antoniofloresgil/cvw/README.md

# core-v-wally

This repository is a fork of [openhwgroup/cvw](https://github.com/openhwgroup/cvw) (CORE-V-Wally) that is
more than Wally: next to the processor it holds an [open FPGA flow, an open ASIC flow with a
microcontroller chip, a KiCad test board and FreeRTOS](#what-this-fork-adds). The core and its configurations
are Wally's, upstream is merged into `main` regularly, and every addition to the core is behind a configuration
parameter that is off by default, so the upstream configurations behave as before
([the inventory](docs/engineering/upstream-coupling.md)). The rest of this README is upstream's setup guide
and still applies.

Wally is a 5-stage pipelined processor configurable to support up through the RVA22 profile, including virtual memory, PMP, and the various privileged modes and CSRs. The rv64gc configuration supports:

- RV64IMAFDCB with M, S, and U modes
- Zicsr, Zifencei, Zicntr, Zihpm, Zicond, and Zicclsm
- Zbc
- Zkn scalar crypto (Zbkb, Zbkc, Zbkx, Zknd, Zkne, and Zknh)
- Zcb
- Zfh and Zfa
- Zicbom, Zicboz, and Zicbop
- Sstc
- Sv39, Sv48, and Sv57 virtual memory with Svpbmt, Svnapot, Svinval, and Svadu
- 16 PMP entries

Other configurations range down to a minimal RV32E core, and derivative configurations add the Q extension. Wally provides optional caches, branch prediction, and standard RISC-V peripherals (CLINT, PLIC, UART, GPIO).   Wally is written in SystemVerilog.  It passes the [RISC-V Arch Tests](https://github.com/riscv/riscv-arch-test) and boots Linux on an FPGA.  Wally is part of the OpenHW Foundation family of robust open RISC-V cores.

Wally block diagram

Wally is described in a textbook, [*RISC-V System-on-Chip Design*](https://pages.hmc.edu/harris/ddca/rvsocd.html), by Harris, Stine, Thompson, and Harris.  Users should follow the setup instructions below.

# What this fork adds

| | What it is | Where |
|---|---|---|
| **Open FPGA flow** | Wally on Xilinx 7-series boards with no Vivado: Yosys, nextpnr-xilinx (openXC7) and Project X-Ray, with LiteX/LiteDRAM for the DDR3 instead of Vivado's MIG. On the Nexys Video the RV32 design runs at 40 MHz and RV64GC boots Linux to a BusyBox shell at 12.5 MHz. The Vivado flow stays. The chip below also builds for the Nexys Video (`make nexysvideochip`). | `fpga/`, [flow and LiteDRAM](docs/fpga-opensource-litedram.md), [DDR3 bring-up](docs/engineering/experiments/open-ddr3-bringup.md), [the chip on the FPGA](docs/fpga-chip.md) |
| **Open ASIC flow** | Wally from RTL to GDS with LibreLane on the IHP SG13G2 and SG13CMOS5L open PDKs, with KLayout and Magic DRC, LVS and timing signoff, all open tools. It builds a chip: **`asic_soc_rv32imac`**, an RV32IMAC RISC-V microcontroller with 16 PMP entries, the JTAG debug port and instruction trace, 64 KiB of SRAM in eight macros, an SPI-flash/UART bootloader, a timer with PWM and capture, a watchdog, I2C, an RTC and a pad ring for a QFN 32. It has not been fabricated. | `asic/librelane/`, [README](asic/librelane/README.md), [ADR 0022](docs/engineering/decisions/0022-asic-microcontroller.md) |
| **Test board** | A KiCad 10 board for that chip: USB-C, an FT2232H for JTAG and UART, SPI flash, I2C and analog parts to try the peripherals, and, in a second variant (rev A-S), a test socket for the QFN 32 chip next to the direct-soldering one (rev A). Its schematic and PCB are generated and routed by Python scripts, and `fab.py` writes the JLCPCB files. `make boardsim` simulates the chip on the board's own netlist. | `hardware/board/`, [README](hardware/board/README.md), [ADR 0023](docs/engineering/decisions/0023-mcu-test-board.md) |
| **Real-time OS** | FreeRTOS and Zephyr run on the chip, with static memory protection from locked PMP entries (FreeRTOS) and User-mode threads isolated by the PMP (Zephyr, with drivers for the UART, GPIO, SPI, PWM, I2C, watchdog, MCU timer with capture and RTC, GPIO and I2C interrupts, and the instruction trace switched on by the kernel); their demos are tested in the chip's RTL simulation (`make chipsim`, 15 tests). | `asic/librelane/chip/freertos/`, `asic/librelane/chip/zephyr/` |
| **Debug and trace** | RISC-V Debug 1.0 over JTAG (halt, step, triggers, System Bus Access; OpenOCD and GDB) and an E-Trace instruction trace. | [debug](docs/debug.md), [trace](docs/trace.md), `testbench/debug/` |
| **Multicore and PMU** | Optional multicore (`NCORES`) with private MSI/MESI caches and Linux SMP; the Sscofpmf, Smcntrpmf and Smcdeleg counter extensions and an SBI PMU. | [engineering notes](docs/engineering/README.md) |

The design decisions, measurements and what is still open are written down in
[`docs/engineering/`](docs/engineering/README.md): architecture decision records, experiment records and
[current work](docs/engineering/current-work.md). To use the fork, clone `antoniofloresgil/cvw` with
`--recurse-submodules` (the step-by-step setup below clones upstream; the commands are the same).

# Configurations

Wally default configurations are listed below.  Synthesis results are from TSMC 28HPC+ TT conditions (0.9 V, 25 °C), Design Compiler Y-2026.03-SP3 physical (topographical) synthesis, with timing that includes its estimated wire delays, before place and route.  The hierarchy is ungrouped automatically, and the clock frequency counts paths into the register files, which are written on the falling edge, as half-cycle paths.  Embench results are without F and D.

| | rv32e | rv32i | rv32imc | rv32imcb | rv32gc | rv64i | rv64gc |
| --- | --- | --- | --- | --- | --- | --- | --- |
| Features | Tiny Embedded | RVI20U32 | Microcontroller | Microcontroller with bit manipulation | Like rv64gc | RVI20U64 | RVA22S64 |
| Privilege Modes | M | M | M, U | M, U | M, S, U | M | M, S, U |
| Extensions | E | I | IMC, Zicsr, Zicntr, Zihpm | IMCB, Zbc, Zicsr, Zicntr, Zihpm | IMAFDCB, Zbc, Zbkb, Zbkc, Zbkx, Zkn, Zkt, Zfh, Zfa, Zcb, Zicond, Zicbom, Zicboz, Zicbop, Zifencei, Zicntr, Zihpm, Sv32, Svadu, Svinval, Sstc | I | IMAFDCB, Zbc, Zbkb, Zbkc, Zbkx, Zkn, Zkt, Zfh, Zfa, Zcb, Zicond, Zicbom, Zicboz, Zicbop, Zifencei, Zicntr, Zihpm, Sv39, Sv48, Sv57, Svadu, Svinval, Svnapot, Svpbmt, Sstc |
| Memory | Bus | IROM, DTIM | IROM, DTIM | IROM, DTIM | 16 KB I$, 16 KB D$ | IROM, DTIM | 16 KB I$, 16 KB D$ |
| Branch Predictor | None | None | Static (backward taken) | Static (backward taken) | 1K gshare, 1K BTB, 16 RAS | None | 1K gshare, 1K BTB, 16 RAS |
| Peripherals | No | No | CLINT, PLIC, UART, GPIO, SPI, PWM | CLINT, PLIC, UART, GPIO, SPI, PWM | CLINT, PLIC, UART, GPIO, SPI, PWM | No | CLINT, PLIC, UART, GPIO, SPI, PWM |
| External bus (AHB) | Yes | No | Yes | Yes | Yes | No | Yes |
| CoreMark/MHz | 0.35 | 1.04 | 3.54 | 4.06 | 4.33 | 0.91 | 4.20 |
| Embench Speed | 0.20 | 0.63 | 1.58 | 1.65 | 1.70 | 0.70 | 2.03 |
| Clock Frequency (MHz) | 2800 | 2780 | 1880 | 1890 | 920 | 2540 | 770 |
| Total Area (mm^2) | 0.0058 | 0.0065 | 0.020 | 0.021 | 0.43 | 0.016 | 0.48 |
| Logic Area (mm^2) | 0.0058 | 0.0065 | 0.020 | 0.021 | 0.11 | 0.016 | 0.17 |
| Flip-Flops | 573 + 495 latches | 573 + 1,023 latches | 1,792 + 1,023 latches | 1,801 + 1,023 latches | 16,496 | 3,026 | 24,416 |
| Gates | 3,650 | 4,495 | 14,583 | 16,122 | 89,945 | 10,309 | 139,072 |
| RAM Bits | 0 | 0 | 0 | 0 | 312,320 | 0 | 356,352 |

CoreMark and Embench (speed-optimized, scored per MHz) are compiled for each configuration's ISA and simulated with Verilator.  With F and D, the compiler optimizes away much of the timed work in the Embench nbody, st, and minver benchmarks, so Embench is compiled without F and D for every configuration, and its floating-point benchmarks use software floating point rather than the FPU.  rv32e, rv32i, and rv64i add performance counters to time the benchmarks.  Synthesis is of `wallypipelinedcore`, with rv32i, rv32imc, rv32imcb, and rv64i using the AHB bus in place of the IROM and DTIM.  The clock frequency is the best of three synthesis targets, and the area is from that run.  Flip-flops and gates are standard cells; gates exclude buffers and inverters.  rv32e, rv32i, rv32imc, and rv32imcb build the integer register file from latches (`LATCH_BASED_REGISTERFILE`), counted separately, including a clock-gate latch for each register.  RAM bits are the SRAM bits used for I$ and D$ data and tags, BTB, and PHT; the SRAM macros take 0.31 mm^2 in rv32gc and rv64gc.

See also [comparison to other cores](docs/comparison.adoc).

# Verification

Wally is presently at Technology Readiness Level 4, passing the [RISC-V architectural certification tests](https://github.com/riscv/riscv-arch-test) and custom tests, and booting Linux in simulation and on an FPGA.  The rv32imc, rv32gc, and rv64gc configurations achieve 100% code and functional coverage.  See the [Test Plan](docs/testplans/testplan.md) for details.

# New User Setup

New users may wish to do the following setup to access the server via a GUI and use a text editor.

- Git started with Git configuration and authentication: C.1  (replace with your name and email)
  ```bash
  $ git config --global user.name "Ben Bitdiddle"
  $ git config --global user.email "ben_bitdiddle@wally.edu"
  $ git config --global pull.rebase false
  ```
- Optional: Download and install x2go - B.1.1
- Optional: Download and install VSCode - B.4.2
- Optional: Make sure you can log into your server via x2go and via a terminal
  - Terminal on Mac, cmd on Windows, xterm on Linux
  - See B.1 about ssh -Y login from a terminal

Then fork and clone the repo, source setup, make the tests and run regression

1. If you don't already have a Github account, create one
2. In a web browser, visit https://github.com/openhwfoundation/cvw
3. In the upper right part of the screen, click on Fork
4. Create a fork, choosing the owner as your github account and the repository as cvw.
5. On the Linux computer where you will be working, log in.
6. Clone your fork of the repo. Change `<yourgithubid>` to your github id.
  ```bash
  $ git clone --recurse-submodules https://github.com/<yourgithubid>/cvw
  $ cd cvw
  $ git remote add upstream https://github.com/openhwfoundation/cvw
  ```

> [!NOTE]
> If you are installing on a new system without any tools installed, please jump to the next section, [Toolchain Installation](#toolchain-installation-and-configuration), then come back here.

7. Run the setup script to set `$WALLY` and `$RISCV` and add `$WALLY/bin` to your `PATH`.

  ```bash
  $ source ./setup.sh
  ```

8. Add the following lines to your `.bashrc` or `.bash_profile` to run the setup script each time you log in.

  ```bash
  if [ -f ~/cvw/setup.sh ]; then
    source ~/cvw/setup.sh
  fi
  ```

9. Try compiling the HelloWally program and simulating it on the SystemVerilog with Verilator and on the Spike simulator.
  ```
  $ cd examples/C/hello
  $ make
  $ wsim --sim verilator rv64gc --elf hello
  Hello Wally!
  0 1 2 3 4 5 6 7 8 9
  $ spike hello
  Hello Wally!
  0 1 2 3 4 5 6 7 8 9
  ```

10. Build the tests from the cvw directory and run a regression simulation to prove everything is installed.  Building tests may take a while.

  ```bash
  $ cd ~/cvw && make --jobs
  $ regression-wally
  ```

# Toolchain Installation and Configuration

This section describes the open source toolchain installation.

### Compatibility
The current version of the toolchain has been tested on Ubuntu (versions 20.04 LTS, 22.04 LTS, 24.04 LTS, and 26.04 LTS), Debian (versions 12 and 13), Red Hat/Rocky/AlmaLinux (versions 8, 9, and 10), SUSE versions 15.6 and 16.0 and Fedora (version 44). Only the latest minor release of each major version is tested.

> [!WARNING]
> - Ubuntu 22.04 LTS is incompatible with Synopsys Design Compiler.
> - Whisper is not installed on Ubuntu 20.04 LTS due to issues compiling the boost libraries.

### Overview
The toolchain installation script installs the following tools:
- [RISC-V GNU Toolchain](https://github.com/riscv-collab/riscv-gnu-toolchain): GCC and accompanying compiler tools
- [QEMU](https://www.qemu.org/docs/master/system/target-riscv.html): emulator
- [Spike](https://github.com/riscv-software-src/riscv-isa-sim): functional RISC-V model
- [Whisper](https://github.com/tenstorrent/whisper): RISC-V instruction set simulator (ISS)
- [Verilator](https://github.com/verilator/verilator): open-source Verilog simulator
- [RISC-V Sail Model](https://github.com/riscv/sail-riscv): golden reference model for RISC-V
- [OSU Skywater 130 cell library](https://foss-eda-tools.googlesource.com/skywater-pdk/libs/sky130_osu_sc_t12): standard cell library
- [uv](https://docs.astral.sh/uv/): Python package manager and virtual environment tool
- [mise](https://mise.jdx.dev/): development environment setup tool for managing tool versions and environment variables
- [Yosys](https://github.com/YosysHQ/yosys) and [yosys-slang](https://github.com/povik/yosys-slang): Verilog/SystemVerilog synthesis
- [nextpnr-xilinx](https://github.com/openXC7/nextpnr-xilinx): placement and routing for Xilinx 7-series FPGAs
- [Project X-Ray](https://github.com/f4pga/prjxray): Xilinx 7-series device database and bitstream tools
- [openFPGALoader](https://github.com/trabucayre/openFPGALoader): FPGA SRAM and flash programmer

The FPGA installation also generates nextpnr chip databases for the `xc7a100t` used by the Arty A7-100T and Nexys A7-100T and the `xc7a200t` used by the Nexys Video. On the Arty A7 and Nexys A7 the open-source flow builds a reduced Wally configuration with internal BRAM, UART, GPIO and CLINT. On the Nexys Video it uses a LiteX/LiteDRAM DDR3 controller instead of Vivado IP, and can build either the reduced RV32 configuration or the RV64GC Linux configuration (`OPENCONFIG=fpganexysvideo`, see [docs/fpga-opensource-litedram.md](docs/fpga-opensource-litedram.md)).

After sourcing `$WALLY/setup.sh`, generate a bitstream with either:

```bash
cd fpga/generator
make FLOW=vivado ArtyA7
make FLOW=vivado nexysa7
make FLOW=vivado nexysvideo
make FLOW=opensource ArtyA7
make FLOW=opensource nexysa7
make FLOW=opensource nexysvideo
```

`make nexysvideochip` (no `FLOW`) builds the microcontroller chip of the ASIC flow for the Nexys Video, with no DDR3 ([docs/fpga-chip.md](docs/fpga-chip.md)). The open-source output is written under `fpga/generator/opensource-<board>/`. The open-source flow is experimental: it targets 25 MHz on the Arty A7-100T and Nexys A7-100T and 40 MHz on the Nexys Video. So far only the Nexys Video bitstream has been programmed on hardware (`DONE=1`); DDR3 bring-up is still in progress (see `docs/fpga-opensource-litedram.md`).

Additionally, Buildroot Linux is built for Wally and linux test-vectors are generated for simulation. See the [Linux README](linux/README.md) for more details. This can be skipped using the `--no-buildroot` flag.

### Installation

The tools can be installed by running this from your `cvw` directory (`$WALLY` is not set until `setup.sh` has been sourced, and `setup.sh` needs the tools installed first)

```bash
$ ./bin/wally-tool-chain-install.sh
```
If this script is run as root or using `sudo`, it will also install all of the prerequisite packages using the system package manager. The default installation directory when run in this manner is `/opt/riscv`.

If a user-level installation is desired, the script can instead be run by any user without `sudo` and the installation directory will be `~/riscv`. In this case, the prerequisite packages must first be installed by running

```bash
$ sudo ./bin/wally-package-install.sh
```

In either case, the installation directory can be overridden by passing the desired directory as an argument to the installation script. For example,

```bash
$ sudo ./bin/wally-tool-chain-install.sh /home/riscv
```

See `wally-tool-chain-install.sh` and the scripts in the `bin/installation` directory for a detailed description of each component, or to issue the commands one at a time to install on the command line.

> [!NOTE]
> The complete installation process requires ~55 GB of free space. If the `--clean` flag is passed to the installation script then the final consumed space is only ~26 GB. The `--clean` flag removes source files and build directories.

### Configuration
`$WALLY/setup.sh` sources `$RISCV/site-setup.sh`. If the toolchain was installed in either of the default locations (`/opt/riscv` or `~/riscv`), `$RISCV` will automatically be set to the correct path when `setup.sh` is run. If a custom installation directory was used, then `$WALLY/setup.sh` must be modified to set the correct path.

`$RISCV/site-setup.sh` allows for customization of the site specific information such as commercial licenses and PATH variables. It is automatically copied into your `$RISCV` folder when the installation script is run.

Change the following lines to point to the path and license server for your Siemens Questa and Synopsys Design Compiler and VCS installations and license servers.  If you only have Questa or VCS, you can still simulate but cannot run logic synthesis.  If Questa, VSC, or Design Compiler are already setup on this system then don't set these variables.

```bash
export MGLS_LICENSE_FILE=..         # Change this to your Siemens license server
export SNPSLMD_LICENSE_FILE=..      # Change this to your Synopsys license server
export QUESTA_HOME=..               # Change this for your path to Questa
export DC_HOME=..                   # Change this for your path to Synopsys Design Compiler
export VCS_HOME=..                  # Change this for your path to Synopsys VCS
```

# Installing EDA Tools

Electronic Design Automation (EDA) tools are vital to implementations of System on Chip architectures as well as validating different designs.   Open-source and commercial tools exist for multiple strategies and although the one can spend a lifetime using combinations of different tools, only a small subset of tools is utilized for this text.  The tools are chosen because of their ease in access as well as their repeatability for accomplishing many of the tasks utilized to design Wally.  It is anticipated that additional tools may be documented later after this is text is published to improve use and access.

Verilator is an open-source Verilog simulator.  It is fast and free.  Run Wally on the riscv-arch-test suite using Verilator with:

```
regression-wally
```

Running code coverage simulations or lock-step presently requires commercial tools; functional coverage also runs on Verilator.  Siemens Questa is the primary tool utilized for simulating and validating Wally. Synopsys VCS also can run regression-wally, lock-step simulation, and code and functional coverage.  For logic synthesis, you will need Synopsys Design Compiler.  Questa and Design Compiler are commercial tools that require an educational or commercial license.

Measure code and functional coverage of the rv64gc, rv32gc, or rv32imc configuration with Questa (add `--coveragesim vcs` to use VCS):

```
regression-wally --ccov rv64gc    # report in sim/questa/cov/rv64gc_uncovered_hierarchical.rpt
regression-wally --fcov rv64gc    # report in sim/questa/fcov/rv64gc_fcov.uncovered.log
```

Note: Some EDA tools utilize `LM_LICENSE_FILE` for their environmental variable to point to their license server.  Some operating systems may also utilize `MGLS_LICENSE_FILE` instead, therefore, it is important to read the user manual on the preferred environmental variable required to point to a user’s license file.  Although there are different mechanisms to allow licenses to work, many companies commonly utilize the FlexLM (i.e., Flex-enabled) license server manager that runs off a node locked license.

Although most EDA tools are Linux-friendly, they tend to have issues when not installed on recommended OS flavors.  Red Hat Enterprise Linux (and its free Rocky clone) and SUSE Linux products  typically tend to be recommended for installing commercial-based EDA tools and are recommended for utilizing complex simulation and architecture exploration.

### Siemens Questa

Siemens Questa simulates behavioral, RTL and gate-level HDL.  To install Siemens Questa first go to a web browser and navigate to https://eda.sw.siemens.com/en-US/ic/questa/simulation/advanced-simulator/.  Click Sign In and log in with your credentials and the product can easily be downloaded and installed.  Some  Windows-based installations also require gcc libraries that are typically provided as a compressed zip download through Siemens.

### Synopsys Design Compiler (DC)

Many commercial synthesis and place and route tools require a common installer.  These installers are provided by the EDA vendor and Synopsys has one called Synopsys Installer.  To use Synopsys Installer, you will need to acquire a license through Synopsys that is typically Called Synopsys Common Licensing (SCL).  Both the Synopsys Installer, license key file, and Design Compiler can all be downloaded through Synopsys Solvnet.  First open a web browser, log into Synsopsy Solvnet, and download the installer and Design Compiler installation files.  Then, install the Installer.

```bash
$ firefox &
```

- Navigate to https://solvnet.synopsys.com
- Log in with your institution’s username and password
- Click on Downloads, then scroll down to Synopsys Installer
- Select the latest version (currently 5.4).  Click Download Here, agree,
- Click on SynopsysInstaller_v5.4.run
- Return to downloads and also get Design Compiler (synthesis) latest version, and any others you want.
- Click on all parts and the .spf file, then click Download Files near the top
- Move the SynopsysInstaller into `/cad/synopsys/Installer_5.4` with 755 permission for cad,
- move other files into `/cad/synopsys/downloads` and work as user cad from here on

```bash
$ cd /cad/synopsys/installer_5.4
$ ./SynopsysInstaller_v5.4.run
```
- Accept default installation directory
```bash
$ ./installer
```
- Enter source path as `/cad/synopsys/downloads`, and installation path as `/cad/synopsys`
- When prompted, enter your site ID
- Follow prompts

Installer can be utilized in graphical or text-based modes.  It is far easier to use the text-based installation tool.  To install DC, navigate to the location where your downloaded DC files are and type installer.  You should be prompted with questions related to where you wish to have your files installed.

The Synopsys Installer automatically installs all downloaded product files into a single top-level target directory. You do not need to specify the installation directory for each product. For example, if you specify `/import/programs/synopsys` as the target directory, your installation directory structure might look like this after installation:

```bash
/import/programs/synopsys/syn/S-2021.06-SP1
```

> [!Note]
> Although most parts of Wally, including the Questa simulator, will work on most modern Linux platforms, as of 2024, the Synopsys CAD tools for SoC design are only supported on Red Hat Enterprise Linux (or AlmaLinux/Rocky) 8.4+ or 9.1+ or SUSE Linux Enterprise Server (SLES) 15.

The Verilog simulation has been tested with Siemens Questa/ModelSim. This package is available to universities worldwide as part of the Design Verification Bundle through the Siemens Academic Partner Program members for $990/year.

If you want to implement your own version of the chip, your tool and license complexity rises significantly. Logic synthesis uses Synopsys Design Compiler. Placement and routing uses Cadence Innovus. Both Synopsys and Cadence offer their tools at a steep discount to their university program members, but the cost is still several thousand dollars per year. Most research universities with integrated circuit design programs have Siemens, Synopsys, and Cadence licenses. You also need a process design kit (PDK) for a specific integrated circuit technology and its libraries. The open-source Google Skywater 130 nm PDK is sufficient to synthesize the core but lacks memories. Google presently funds some fabrication runs for universities. IMEC and Muse Semiconductor offers full access to multiproject wafer fabrication on the TSMC 28 nm process including logic, I/O, and memory libraries; this involves three non-disclosure agreements. Fabrication costs on the order of $10,000 for a batch of 1 mm2 chips.

Startups can expect to spend more than $1 million on CAD tools to get a chip to market. Commercial CAD tools are not realistically available to individuals without a university or company connection.

# Adding Cron Job for nightly builds

If you want to add a cronjob you can do the following:
1) Set up the email client `mutt` to send emails through the command line
2) Enter `crontab -e` into a terminal
3) add this code to test cloning CVW, making CVW's tests, then running `regression-wally --nightly --buildroot` every day at 21:30 in your local time
```bash
30 21 * * * curl -L https://raw.githubusercontent.com/openhwfoundation/cvw/refs/heads/main/bin/nightly_build.py | uv run --script - --path {PATH_FOR_NIGHTLY_RUNS} --target all --tests all --send_email {YOUR_EMAIL}
```
This utility will take up approximately 100 GB on your hard drive. You can also run the script directly from `bin/nightly_build.py`.

# Example wsim commands

wsim runs one of multiple simulators, Questa, VCS, or Verilator using a specific configuration and one or more ELF files.
The general syntax is
`wsim <config> <elf or directory>... [--options]`

Every ELF named, and every `*.elf` found under every directory named, runs back-to-back in a single simulation session.
Tests are self-checking, so the simulation ends with a single summary: `SUCCESS! All tests ran without failures.` or `FAIL: N test programs had errors`.

Parameters and options:

```
-h, --help                                                   show this help message and exit
--elf ELF, -e ELF                                            ELF File name; use if name does not end in .elf
--test {buildroot,fpga,coremark,embench}, -T ...             Special testbench mode
--name NAME, -n NAME                                         Name used for log and coverage database files
--sim {questa,verilator,vcs}, -s {questa,verilator,vcs}      Simulator
--tb {testbench,testbench_fp}, -t {testbench,testbench_fp}   Testbench
--gui, -g                                                    Simulate with GUI
--ccov, -c                                                   Code Coverage
--fcov, -f                                                   Functional Coverage
--args ARGS, -a ARGS                                         Optional arguments passed to simulator via $value$plusargs
--params PARAMS, -p PARAMS                                   Optional top-level parameter overrides of the form param=value
--define DEFINE, -d DEFINE                                   Optional define macros passed to simulator
--vcd, -v                                                    Generate testbench.vcd
--lockstep, -l                                               Run ImperasDV lock, step, and compare.
--lockstepverbose, -lv                                       Run ImperasDV lock, step, and compare with tracing enabled
--rvvi, -r                                                   Simulate rvvi hardware interface and ethernet.
```

Run a whole directory of RISC-V Architecture Tests in one session with Questa

```bash
wsim rv64gc $WALLY/addins/riscv-arch-test/work/cvw-rv64gc/elfs/rv64i/I
```

Run one ELF in the Questa gui

```bash
wsim rv64gc $WALLY/addins/riscv-arch-test/work/cvw-rv64gc/elfs/rv64i/I/I-add-00.elf --gui
```

Run several ELFs back-to-back with Verilator

```bash
wsim rv32gc $WALLY/tests/periph/rv32/WALLY-gpio-01.elf $WALLY/tests/periph/rv32/WALLY-clint-01.elf --sim verilator
```

Run lockstep against ImperasDV with a single elf file in the gui. Lockstep requires a single elf.

```bash
wsim rv64gc $WALLY/addins/riscv-arch-test/work/cvw-rv64gc/elfs/rv64i/I/I-add-00.elf --lockstep --gui
```

Collect functional coverage over a directory of tests (add `--sim vcs` to use VCS).

```bash
wsim rv64gc $WALLY/addins/riscv-arch-test/work/cvw-rv64gc/elfs/priv/Sv --fcov
```

Run Linux boot simulation in lock step between Wally and ImperasDV

```bash
wsim buildroot buildroot --args +INSTR_LIMIT=600000000 --lockstep
```

# Textbook Errata

See [errata.md](./errata.md) for errata on the [RISC-V System-on-Chip Design](https://www.amazon.com/RISC-V-Microprocessor-System-Chip-Design/dp/0323994989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) textbook.
