antoniofloresgil/cvw/docs/comparison.adoc

= CORE-V-Wally Compared with Other RISC-V Cores

These tables compare CORE-V-Wally configurations with other open-source cores that have
https://github.com/riscv/riscv-arch-test[riscv-arch-test] (ACT) configurations.
Each row describes the configuration ACT builds, at the core commit ACT pins; the core name links to that commit.
Areas do not include L2 caches or tightly coupled memories (ICCM, DCCM, IROM, DTIM): they cover the core and its L1 caches,
as CORE-V-Wally's own results do.
See the <<_reproducing_the_tables,last section>> for where each entry comes from.

This comparison attempts to show each core in its most positive light: each runs the configuration and build its developers
chose for riscv-arch-test, with the most favorable settings we found (footnoted). If a core is not configured well here,
please https://github.com/openhwfoundation/cvw/issues[file an issue].

The data in these tables were collected with the help of AI (Claude Code): runs were scripted and checked, and descriptions,
readiness levels, and documentation ratings were researched from the cited sources, but errors are possible.
Corrections are appreciated, as an issue or a pull request.

== Overview

[cols="2,2,3,3,3,3,3,2,1,1",options="header"]
|===
| Core | Supplier | Language | Description | Pipeline | Memory | Branch Predictor | External Bus | TRLfootnote:trl[Technology Readiness Level, linked to its evidence: 3 by default; 4 if there is documentation of the core running on an FPGA or in silicon; 5 if full functional and code coverage is available in a public repository and documented to pass on a particular version. A core is 3 regardless if, with each riscv-arch-test exclusion narrowed to the test groups that actually fail, the exclusions for core bugs remove more than 10% of the tests or a whole suite of a base or major extension (I/E, M, A, F, D, C, B, V, H, Zicsr, Zifencei, Sm, S, U, PMP, or an Sv mode). Exclusions caused by the tests, the Sail reference model, UDB, or a testbench do not count. Counted with riscv-arch-test's own test selection over each configuration's `exclude_extensions` in `ci.yaml`.] | Docsfootnote:doc[Linked to the main documentation. Good: full documentation including features, a microarchitecture diagram, how to use the core, and performance. Fair: a list of features and enough documentation to use the core. Poor: the core would be hard to use for lack of documentation.]
10+h| Application cores — Linux-capable cores with caches and virtual memory.
| link:../config/rv64gc/config.vh[cvw rv64gc] | OpenHW Foundation | SystemVerilog | RVA22S64 | 5-stage, single issue, in-order | 16 KB I$, 16 KB D$ | 1K gshare, 1K BTB, 16 RAS | AHB | link:../fpga/README.md[4]footnote:trlcvw[CORE-V-Wally boots Linux on FPGAs. rv64gc, rv32gc, and rv32imc have 100% code coverage and 96.7% to 99.75% functional coverage, which is not yet documented for a release.] | https://pages.hmc.edu/harris/ddca/rvsocd.html[Good]
| link:../config/rv32gc/config.vh[cvw rv32gc] | OpenHW Foundation | SystemVerilog | Like rv64gc | 5-stage, single issue, in-order | 16 KB I$, 16 KB D$ | 1K gshare, 1K BTB, 16 RAS | AHB | link:../fpga/README.md[4]footnote:trlcvw[] | https://pages.hmc.edu/harris/ddca/rvsocd.html[Good]
| https://github.com/ucb-bar/chipyard/tree/0acc1e1de2d3284bcd4d876956932a013ffe1949[Rocket] | CHIPS Alliance, UC Berkeley | Chisel | Linux-capable core with the Saturn vector unit (VLEN 128)footnote:rocket[Chipyard 1.14.0 `MINV128D64RocketConfig`, Saturn's minimal reference configuration, with the hypervisor extension and Sv48 added; rocket-chip 55bcad0, Saturn 8ef05c9, and the four patches in riscv-arch-test#2652. One Rocket core with Saturn: VLEN 128, DLEN 64, ELEN 64, Zvfh and Zvbb. Vector loads and stores go through Rocket's L1 D$, and vector FMAs use Rocket's scalar FMA (FP latencies 3). One unified sequencer holds the integer, multiply (4 stages), permute, divide, and FP units, with no issue queues.] | 5-stage, single issue, in-order | 32 KB I$, 32 KB D$ (blocking) | 512-entry BHT, 28-entry BTB, 6-entry RAS | TileLink | https://www2.eecs.berkeley.edu/Pubs/TechRpts/2016/EECS-2016-17.html[4]footnote:trlxrocket[With each exclusion narrowed to the test groups that fail, its riscv-arch-test configuration excludes 317 of 3,441 tests (9%), nearly all for core bugs (chiefly vector floating point, the vector exceptions, and a few hypervisor groups), so TRL stays 4.] | https://chipyard.readthedocs.io/en/latest/generators/rocket/[Fair]
| https://github.com/openhwfoundation/cva6/tree/81245a47fad8fe1a5d562d953ef2662e099def76[CVA6 cv64a6_&#8203;imafdc_&#8203;sv39_&#8203;hpdcache] | OpenHW Foundation | SystemVerilog | Linux-capable application core | 6-stage, single issue, in-order issue, out-of-order completion | 16 KB I$, 32 KB 8-way HPDcache D$ (write-through) | 128-entry BHT, 32-entry BTB, 2-entry RAS | AXI4 | https://github.com/openhwfoundation/cva6/blob/master/tutorials/fpga.md[4] | https://docs.openhwfoundation.org/projects/cva6-user-manual/en/latest/[Good]
| https://github.com/openhwfoundation/cva6/tree/81245a47fad8fe1a5d562d953ef2662e099def76[CVA6 cv32a6_&#8203;imac_&#8203;sv32] | OpenHW Foundation | SystemVerilog | 32-bit Linux-capable application core | 6-stage, single issue, in-order issue, out-of-order completion | 16 KB I$, 32 KB D$ (write-through) | 128-entry BHT, 32-entry BTB, 2-entry RAS | AXI4 | https://github.com/openhwfoundation/cva6/blob/master/tutorials/fpga.md[4] | https://docs.openhwfoundation.org/projects/cva6-user-manual/en/latest/[Good]
| https://gitlab.com/shaktiproject/cores/c-class/-/tree/6feeb421f02f5f76dacba3c44caa61cfba60b56f[Shakti C-class] | IIT Madras | Bluespec SystemVerilog | Linux-capable Bluespec application core | 6-stage, single issue, in-order | 16 KB I$, 16 KB D$ | 512-entry gshare, 32-entry BTB, 8-entry RAS | AXI4 | https://shakti.org.in/tapeout.html[4]footnote:trlxshc[Its riscv-arch-test configuration excludes 104 of 572 tests (18%), many of them shared with E-class's exclusions in one ci.yaml; narrowed to its own failing groups, 49 (9%) are for core bugs, so TRL stays 4.] | https://c-class.readthedocs.io/en/latest/[Good]
| https://github.com/bsc-loca/core_tile/tree/2528e7df6507fa06d372f001e55cfd46efae4a4b[Sargantana] | Barcelona Supercomputing Center | SystemVerilog | Linux-capable core with register renaming | 7-stage, single issue, in-order with register renaming | 16 KB I$, 32 KB D$ (write-through) | 128-entry bimodal, 128-entry BTB, 16-entry RAS | Custom cache refill interfaces | https://upcommons.upc.edu/bitstream/handle/2117/384912/sargantana_preprint.pdf[3]footnote:trlxsarg[TRL 3: with each exclusion narrowed to the test groups that fail, its riscv-arch-test configuration still excludes 213 of 726 tests (29%), nearly all for core bugs, including all of ZicsrF. It would otherwise be TRL 4 (the link is the FPGA evidence).] | https://github.com/bsc-loca/sargantana[Fair]
| https://github.com/riscv-boom/riscv-boom/tree/5223e44cfeb26f41380057a2eb4d651197475f69[BOOM] | UC Berkeley | Chisel | Linux-capable 2-wide out-of-order core | 7-stage, 2-wide out-of-order | 16 KB I$, 16 KB D$ | TAGE-L, BTB, 32-entry RAS | TileLink | https://people.eecs.berkeley.edu/~krste/papers/SonicBOOM-CARRV2020.pdf[4] | https://docs.boom-core.org/en/latest/[Good]
| https://github.com/SpinalHDL/NaxRiscv/tree/9f452d50560d02fb391bc8039f5453c54e0911af[NaxRiscv] | SpinalHDL (Charles Papon) | SpinalHDL | Linux-capable 2-wide out-of-order core | 10-stage, 2-wide out-of-orderfootnote:naxdepth[Counted from the registered stage boundaries in the RTL of the Gen64 build with RVC, fetch to integer writeback: 3 fetch, align, decode, rename, dispatch, issue, register read and execute, and writeback. Not documented by NaxRiscv.] | 16 KB I$, 16 KB D$ | 4 KB gshare, 512-entry BTB, 16-entry RAS | Native cache and peripheral buses | https://spinalhdl.github.io/NaxRiscv-Rtd/main/NaxRiscv/hardware/index.html[4]footnote:trlxnax[Its riscv-arch-test configuration excludes 53 of 489 tests (11%); narrowed to the groups that fail, 43 (9%) are for core bugs, so TRL stays 4.] | https://spinalhdl.github.io/NaxRiscv-Rtd/[Good]
| https://github.com/T-head-Semi/openc910/tree/b91c90914c19f114d35c8f6b73408eb241ed847c[OpenC910] | T-Head (Alibaba) | Verilog | 3-wide out-of-order Linux-capable core | 12-stage, 3-wide out-of-order | 64 KB I$, 64 KB D$, 1 MB L2 | 64 Kbit bi-mode BHT, 1024-entry BTB, 12-entry RAS | AXI4 | https://hc32.hotchips.org/assets/program/conference/day1/HotChips2020_Edge_Computing_Xuantie910_v1.1.pdf[3]footnote:trlxc910[TRL 3: its riscv-arch-test configuration excludes 131 of 561 tests (23%) for core bugs, including ZicsrF and about half of F and D; the configuration is not run in CI. It would otherwise be TRL 4 (the link is the silicon evidence).] | https://github.com/T-head-Semi/openc910/tree/main/doc[Good]
| https://github.com/OpenXiangShan/XiangShan/tree/e7bab53e66dfb3c4a1d11cf9519b0396f8576cae[XiangShan Kunminghu] | BOSC, ICT (CAS) | Chisel | RVA23 6-wide out-of-order core | 13-stage, 6-wide out-of-order | 64 KB I$, 64 KB D$, 1 MB L2 | TAGE-SC, 2048-entry FTB, ITTAGE, RAS | CHI | https://www.qemu.org/docs/master/system/riscv/xiangshan-kunminghu.html[4]footnote:trlxxs[With each exclusion narrowed to the test groups that fail, its riscv-arch-test configuration excludes 336 of 4,568 tests (7%). Leaving out reference-model and UDB limitations (chiefly a required tdata3, and CSRs Sail 0.16 lacks), at most 172 (4%) are for core bugs, so TRL stays 4.] | https://docs.xiangshan.cc/projects/design/en/latest/[Good]
10+h| Embedded cores with caches or tightly coupled memories — Higher-performance embedded cores.
| link:../config/rv32imcb/config.vh[cvw rv32imcb] | OpenHW Foundation | SystemVerilog | Microcontroller with bit manipulation | 5-stage, single issue, in-order | IROM, DTIM | Static (backward taken) | AHB | link:../fpga/README.md[4]footnote:trlcvw[] | https://pages.hmc.edu/harris/ddca/rvsocd.html[Good]
| https://github.com/stnolting/neorv32/tree/b1f307244928161a3fca1a010af11d5a736b5339[NEORV32] | Stephan Nolting | VHDL | Multicycle VHDL microcontroller core | 2-stage, single issue, in-order, multicycle | 4 KB I$ | None | Wishbone-style XBUS | https://github.com/stnolting/neorv32-setups[4] | https://stnolting.github.io/neorv32/[Good]
| https://github.com/lowRISC/ibex/tree/e9f55342edbd27e9e17a0e41b1c95a81abb5eac8[Ibex (OpenTitan)] | lowRISC | SystemVerilog | Security-hardened OpenTitan core | 3-stage, single issue, in-order | 4 KB I$ (ECC, scrambled)footnote:ibexic[The cache resets disabled (`cpuctrlsts.icache_enable` = 0), and the riscv-arch-test boot code leaves it off.] | None | Ibex memory interface (OBI-like) with ECC | https://opensource.googleblog.com/2026/03/opentitan-shipping-in-production.html[4] | https://ibex-core.readthedocs.io/en/latest/[Good]
| https://github.com/chipsalliance/Cores-VeeR-EL2/tree/925f3a34bdadc8f28b12a70cfb73e043b0f5ef3d[VeeR EL2] | CHIPS Alliance (Western Digital) | SystemVerilog | Scalar embedded core | 4-stage, single issue, in-order | 16 KB I$, 64 KB ICCM, 64 KB DCCMfootnote:el2ccm[The EL2 ICCM and DCCM arrays are instantiated in the testbench, outside `el2_veer_wrapper`.] | 512-entry gshare BHT, 512-entry BTB, 8-entry RAS | AXI4 | https://github.com/chipsalliance/Cores-SweRVolf[4]footnote:trlxel2[Its riscv-arch-test configuration excludes 30 of 234 tests (13%), but the U and Zifencei suites are excluded for a reference-model limitation (EL2 legally writes mtval = 0 on some illegal-instruction traps) and a testbench one; 19 tests (8%) are for core bugs, so TRL stays 4.] | https://github.com/chipsalliance/Cores-VeeR-EL2/tree/main/docs[Good]
| https://github.com/T-head-Semi/opene906/tree/c5b878958e73e0b8f324a8132943f184a7831c07[OpenE906] | T-Head (Alibaba) | Verilog | 32-bit microcontroller core with FPU | 5-stage, single issue, in-order | 16 KB I$, 16 KB D$ | 8 Kbit BHT, 16-entry BTB, 4-entry RAS | AHB-Lite (instruction, data, and system ports) | 3footnote:trlxe906[TRL 3: its riscv-arch-test configuration excludes 93 of 313 tests (30%) for core bugs, including ZicsrF and about half of F; no record of it running on an FPGA or in silicon was found either.] | https://github.com/T-head-Semi/opene906/tree/main/doc[Fair]
| https://github.com/litex-hub/pythondata-cpu-vexriscv/tree/642ecfed1c84460555d6d803d660cc60cfc1ecb6[VexRiscv] | SpinalHDL (Charles Papon) | SpinalHDL | 5-stage LiteX core | 5-stage, single issue, in-order | 4 KB I$, 4 KB D$ (write-through) | Static (backward taken) | Wishbone | https://github.com/litex-hub/linux-on-litex-vexriscv[3]footnote:trlxvex[TRL 3: with each exclusion narrowed to the test groups that fail, its riscv-arch-test configuration excludes 16 of 140 tests (11%) for core bugs, including all of Zicsr. It would otherwise be TRL 4 (the link is the FPGA evidence).] | https://github.com/SpinalHDL/VexRiscv[Fair]
| https://github.com/openhwfoundation/cva6/tree/81245a47fad8fe1a5d562d953ef2662e099def76[CVA6 cv32a65x] | OpenHW Foundation | SystemVerilog | Dual-issue embedded core | 6-stage, dual issue, in-order issue, out-of-order completion | 2 KB I$, 2 KB D$ (write-through) | 32-entry BHT, 2-entry RAS | AXI4 | https://github.com/openhwfoundation/cva6/releases/tag/cv32a60x-v6.0.0[5]footnote:trla65x[The TRL5 release cv32a60x-v6.0.0 documents 99.8% line, 98.4% condition, and 98.9% functional coverage; the table pins a later commit.] | https://cva6.readthedocs.io/en/latest/04_cv32a65x/design/design.html[Good]
| https://github.com/chipsalliance/Cores-VeeR-EH1/tree/d04b1c7ae675a63dc4307cacfd10547ec937b928[VeeR EH1] | CHIPS Alliance (Western Digital) | SystemVerilog | Dual-issue superscalar embedded core | 9-stage, dual issue, in-order | 16 KB I$, 64 KB DCCM, 512 KB ICCMfootnote:iccm[The EH1 build used with riscv-arch-test enables a 512 KB ICCM by default; the tests run from external memory.] | 128-entry gshare BHT, 32-entry BTB, 4-entry RAS | AXI4 | https://github.com/chipsalliance/Cores-SweRVolf[4] | https://github.com/chipsalliance/Cores-VeeR-EH1/tree/main/docs[Good]
| https://github.com/chipsalliance/Cores-VeeR-EH2/tree/a7203d02d4774c9b8aa08b4827ec300d2c80a388[VeeR EH2] | CHIPS Alliance (Western Digital) | SystemVerilog | Dual-issue superscalar embedded corefootnote:eh2thr[EH2 supports two hardware threads; the riscv-arch-test build has one.] | 9-stage, dual issue, in-order | 32 KB I$, 64 KB ICCM, 256 KB DCCM | 512-entry gshare BHT, 512-entry BTB, 4-entry RAS | AXI4 | 3 | https://github.com/chipsalliance/Cores-VeeR-EH2/tree/main/docs[Good]
10+h| Microcontroller cores — Small pipelined cores without caches.
| link:../config/rv32imc/config.vh[cvw rv32imc] | OpenHW Foundation | SystemVerilog | Microcontroller | 5-stage, single issue, in-order | IROM, DTIM | Static (backward taken) | AHB | link:../fpga/README.md[4]footnote:trlcvw[] | https://pages.hmc.edu/harris/ddca/rvsocd.html[Good]
| https://github.com/MikeOpenHWGroup/cve2/tree/094e9742648f3f527c6f47d047e625600653a9aa[CV32E20] | OpenHW Foundation | SystemVerilog | 2-stage microcontroller core | 2-stage, single issue, in-order | None | None | OBI | https://github.com/openhwfoundation/cve2[4] | https://docs.openhwfoundation.org/projects/cve2-user-manual/en/latest/[Good]
| https://github.com/T-head-Semi/opene902/tree/991836411b405ac6a0a8d7668f2f5de6fa2a5b8c[OpenE902] | T-Head (Alibaba) | Verilog | 2-stage RV32E microcontroller core | 2-stage, single issue, in-order | None | None | AHB-Lite (instruction and system ports) | https://nuttx.apache.org/docs/latest/platforms/risc-v/bl808/index.html[4] | https://github.com/T-head-Semi/opene902/tree/main/doc[Fair]
| https://gitlab.com/shaktiproject/cores/e-class/-/tree/e8a0dfd2d1c4907c74fb58432e379016871fdd3a[Shakti E-class] | IIT Madras | Bluespec SystemVerilog | 3-stage Bluespec embedded core | 3-stage, single issue, in-order | None | None | AXI4-Lite (instruction and data ports) | https://shakti.org.in/tapeout.html[3]footnote:trlxshe[TRL 3: with each exclusion narrowed to the test groups that fail, its riscv-arch-test configuration excludes 67 of 228 tests (29%) for core bugs. It would otherwise be TRL 4 (the link is the silicon evidence).] | https://gitlab.com/shaktiproject/cores/e-class[Fair]
| https://github.com/Wren6991/Hazard3/tree/ba0c83c657a21f2e9946cf02cbc6c8d3d9a7dab6[Hazard3] | Luke Wren (Raspberry Pi) | Verilog | RP2350 microcontroller core | 3-stage, single issue, in-order | None | 1-entry BTB | AHB5 (instruction and data ports) | https://datasheets.raspberrypi.com/rp2350/rp2350-datasheet.pdf[4] | https://wren.wtf/hazard3/doc/[Good]
| https://github.com/openhwgroup/cv32e40p/tree/360d272898d81806be3377193870dbf83a3ea79f[CV32E40P RV32IMC] | OpenHW Foundation | SystemVerilog | 4-stage microcontroller core | 4-stage, single issue, in-order | None | None | OBI | https://github.com/openhwgroup/programs/tree/master/Project-Descriptions-and-Plans/CV32E40Pv1/Milestone-data[5]footnote:trle40p[CV32E40P v1.0.0 closed code and functional coverage; v2 with the v1 parameters (RV32IMC, no FPU or PULP extensions) is kept logically equivalent to it.] | https://docs.openhwfoundation.org/projects/cv32e40p-user-manual/en/latest/[Good]
| https://github.com/openhwgroup/cv32e40p/tree/360d272898d81806be3377193870dbf83a3ea79f[CV32E40P RV32IMCF] | OpenHW Foundation | SystemVerilog | 4-stage microcontroller core with FPU | 4-stage, single issue, in-order | None | None | OBI | https://docs.openhwfoundation.org/projects/cv32e40p-user-manual/en/latest/[4] | https://docs.openhwfoundation.org/projects/cv32e40p-user-manual/en/latest/[Good]
| https://github.com/openhwfoundation/cv32e40s/tree/9d9cae78b01a11458953133d1173c61933a2ba86[CV32E40S RV32IMC] | OpenHW Foundation | SystemVerilog | Security-hardened microcontroller core, default parameters (no PMP or PMA regions)footnote:actnorun[https://github.com/riscv/riscv-arch-test/pull/3166[riscv-arch-test#3166] adds a CV32E40S testbench, pinned at openhwfoundation/cv32e40s 9d9cae7. It runs the tests on RV32IMCB but not on RV32IMC, whose U-mode accesses all fault because it has no PMP regions.] | 4-stage, single issue, in-order | None | None | OBI with integrity | 3 | https://docs.openhwfoundation.org/projects/cv32e40s-user-manual/en/latest/[Good]
| https://github.com/openhwfoundation/cv32e40s/tree/9d9cae78b01a11458953133d1173c61933a2ba86[CV32E40S RV32IMCB] | OpenHW Foundation | SystemVerilog | Security-hardened microcontroller core, maximal parameters: Zba, Zbb, Zbc, and Zbs, 16 PMP regions, and 1 PMA regionfootnote:actnorun[] | 4-stage, single issue, in-order | None | None | OBI with integrity | 3 | https://docs.openhwfoundation.org/projects/cv32e40s-user-manual/en/latest/[Good]
| https://github.com/openhwgroup/cv32e40x/tree/d952cd63bc1b4eb58cd893c28ef8283c781e345e[CV32E40X] | OpenHW Foundation | SystemVerilog | Microcontroller core with extension interface | 4-stage, single issue, in-order | None | None | OBI | https://github.com/mole99/greyhound-ihp[4] | https://docs.openhwfoundation.org/projects/cv32e40x-user-manual/en/latest/[Good]
10+h| Minimal cores — The smallest cores, for control tasks.
| link:../config/rv32e/config.vh[cvw rv32e] | OpenHW Foundation | SystemVerilog | Tiny Embedded | 5-stage, single issue, in-order | Bus | None | AHB | link:../fpga/README.md[4]footnote:trlcvw[] | https://pages.hmc.edu/harris/ddca/rvsocd.html[Good]
| link:../config/rv32i/config.vh[cvw rv32i] | OpenHW Foundation | SystemVerilog | RVI20U32 | 5-stage, single issue, in-order | IROM, DTIM | None | None | link:../fpga/README.md[4]footnote:trlcvw[] | https://pages.hmc.edu/harris/ddca/rvsocd.html[Good]
| https://github.com/YosysHQ/picorv32/tree/ef203c2b0a3fb793280f5114941416c425c5b461[PicoRV32] | YosysHQ (Claire Wolf) | Verilog | Size-optimized multicycle core | Not pipelined (about 4 cycles per instruction) | None | None | AXI4-Lite | https://github.com/YosysHQ/picorv32/tree/main/picosoc[4] | https://github.com/YosysHQ/picorv32[Fair]
| https://github.com/olofk/serv/tree/f200eb2ed7b69ac1c6b8eddd47654522aeee5ce8[SERV] | Olof Kindgren | Verilog | Bit-serial minimal core | Bit-serial, not pipelined (32 or more cycles per instruction) | None | None | Reduced Wishbone | https://serv.readthedocs.io/en/latest/servant.html[3]footnote:trlxserv[TRL 3: its riscv-arch-test configuration excludes 28 of 124 tests (23%) for core bugs, including all of Zicsr and Zifencei. It would otherwise be TRL 4 (the link is the FPGA evidence).] | https://serv.readthedocs.io/en/latest/[Good]
|===

== Features

[cols="2,2,3,6,2,2",options="header"]
|===
| Core | Privilege Modes | Peripherals | Extensions | HDL Linesfootnote:hdllines[Measured with cloc 2.08 as its code count, which leaves out blank and comment lines, over an explicit list of the core's source files (`cloc --list-file=<files>`; Bluespec `.bsv` files are counted with `--force-lang=Verilog-SystemVerilog,bsv`, which has the same comment syntax), at the commit riscv-arch-test pins. For Verilog, SystemVerilog, and VHDL cores, the list is the files whose modules the core's riscv-arch-test simulation elaborates under the core's top, with the packages and headers they use (from the same Verilator command with `--xml-only` or `--json-only`, or from ghdl for VHDL), rather than the whole file list, which can compile unused alternatives. This covers the configured core with its own FPU, caches, MMU, and bus interface, and the shared library modules it instantiates, but not testbenches, verification code, tracers, DPI models, simulation-only memories, or SoC peripherals. For Chisel, SpinalHDL, and Bluespec cores, it is the generator source (Scala or BSV) of the core, not the generated Verilog, which is many times larger (footnoted); the SpinalHDL library and Chisel itself are not counted. A line of a generator language describes more hardware than a line of Verilog, so counts compare best within a language (see the Language row).] | Simulation Speed (instr/s)footnote:simspeed[Instructions simulated per second of CPU time on one host core: an AMD Ryzen 9 9950X (Zen 5, 16 cores, 4.3 GHz maximum) under AlmaLinux 9, with no other load: eight simulations at a time, each pinned with `taskset` to its own physical core while the cores' second hardware threads stay idle. The time is user plus system CPU time including child processes, so a multithreaded simulator counts as one core. Each core runs the simulator of its riscv-arch-test configuration (mostly Verilator, at the version and with the build options of the install script). CoreMark is run at 1 and at N iterations, and the speed is the extra instructions divided by the extra CPU time, which leaves out simulator start-up, program loading, and CoreMark's initialization. N is chosen for about 30 s of extra CPU time (200 s for the Rocket, BOOM, Sargantana, and OpenC910 simulators, whose start-up takes 40 to 150 s), within each testbench's cycle limit. The extra instructions are the per-iteration counts measured with minstret for each ISA class (identical on every core built for the same ISA). CORE-V-Wally runs CoreMark on `wsim` with Verilator, reading MINSTRET, with the simulation speedups of https://github.com/openhwfoundation/cvw/pull/2063[cvw#2063]; rv32e, rv32i, and rv64i add counters, a CLINT, and a UART for it, as for the README benchmarks.]
6+h| Application cores
| link:../config/rv64gc/config.vh[cvw rv64gc] | M, S, U | CLINT, PLIC, UART, GPIO, SPI, PWMfootnote:cvwperiph[In the `wallypipelinedsoc` uncore; the other cores leave interrupt controllers and timers to the SoC.] | IMAFDCB, Zbc, Zbkb, Zbkc, Zbkx, Zkn, Zkt, Zfh, Zfa, Zcb, Zicond, Zicbom, Zicboz, Zicbop, Zifencei, Zicntr, Zihpm, Sv39, Sv48, Sv57, Svadu, Svinval, Svnapot, Svpbmt, Sstc | 11,603footnote:hlcvw[All of src/ except the uncore peripherals (1,671 lines) and the RVVI tracer (287): the one configurable source of every configuration. rv64gc elaborates 10,655 of these lines and rv32e 2,655.] | 203 k
| link:../config/rv32gc/config.vh[cvw rv32gc] | M, S, U | CLINT, PLIC, UART, GPIO, SPI, PWMfootnote:cvwperiph[] | IMAFDCB, Zbc, Zbkb, Zbkc, Zbkx, Zkn, Zkt, Zfh, Zfa, Zcb, Zicond, Zicbom, Zicboz, Zicbop, Zifencei, Zicntr, Zihpm, Sv32, Svadu, Svinval, Sstc | 11,603footnote:hlcvw[] | 364 k
| https://github.com/ucb-bar/chipyard/tree/0acc1e1de2d3284bcd4d876956932a013ffe1949[Rocket] | M, S, U, H | None | IMAFDCBV, Za64rs, Za128rs, Zfh, Zfhmin, Zicsr, Zifencei, Zihpm, Zvfh, Zvfhmin, Zvbb, Zvkb, Sv39, Sv48, Svbare, Svade, Sstvecd, Ssu64xl, Sscounterenw, Shcounterenw, Shvstvecd, Shvsatpa, Shgatpa, Shtvala | 26,210footnote:hlrocket[Rocket 18,368 lines (rocket/, tile/, the TileLink, AMBA, and util pieces it uses, and the hardfloat FPU) plus the Saturn vector unit 7,842. The generated Verilog of the tile is 45,086 lines.] | 5.3 k
| https://github.com/openhwfoundation/cva6/tree/81245a47fad8fe1a5d562d953ef2662e099def76[CVA6 cv64a6_&#8203;imafdc_&#8203;sv39_&#8203;hpdcache] | M, S, U | None | IMAFDCB, Zcb, Zicbom, Zicond, Zicsr, Zifencei, Zbc, Zkn, Ziccif, Zicntr, Zihpm, Ssccptr, Sv39, Svbare, Svade, Sstvala, Sstvecd, Sscounterenw, Ssu64xl | 41,871footnote:hlcva6[The modules elaborated under the core; the CVA6 file list also compiles the two cache subsystems the configuration does not use (about 60,100 lines in all). cv64a6_imafdc_sv39 includes the cvfpu FPU and the HPDcache that riscv-arch-test builds.] | 22 k
| https://github.com/openhwfoundation/cva6/tree/81245a47fad8fe1a5d562d953ef2662e099def76[CVA6 cv32a6_&#8203;imac_&#8203;sv32] | M, S, U | None | IMACB, Zbc, Zbkc, Zbkb, Zbkx, Zkn, Zknd, Zkne, Zknh, Zicntr, Zihpm, Zicsr, Zifencei, Sv32, Svbare | 32,555footnote:hlcva6[] | 35 k
| https://gitlab.com/shaktiproject/cores/c-class/-/tree/6feeb421f02f5f76dacba3c44caa61cfba60b56f[Shakti C-class] | M, S, U | None | IMAFDC, Zicsr, Zifencei, Zicntr, Zihpm, Zihintntl, Zihintpause, Sv39, Svbare, Sstvecd, Sstvecv, Ssu64xl | 23,233footnote:hlshc[The core with its FPU (3,453 lines), caches, TLBs, PMP, and AXI4 types. The generated Verilog is 87,273 lines.] | 195 k
| https://github.com/bsc-loca/core_tile/tree/2528e7df6507fa06d372f001e55cfd46efae4a4b[Sargantana] | M, S, U, H | None | IMAFDB, Zfhmin, Zfa, Zicond, Zicsr, Zifencei, Zicntr, Zihpm, Zicbom, Zicbop, Zicboz, Zic64b, Ziccamoa, Ziccif, Ziccrse, Smstateen, Ssstateen, Sv39, Svbare, Svade, Ssccptr, Sscounterenw, Sstvala, Sstvecd, Sscofpmf, Shcounterenw, Shgatpa, Shtvala, Shvsatpa, Shvstvala, Shvstvecd | 49,552footnote:hlsarg[The tile: core, cvfpu FPU, SIMD unit, MMU, instruction cache, and HPDcache, with its behavioral SRAMs; not the debug module, L2 model, or boot ROM.] | 12 k
| https://github.com/riscv-boom/riscv-boom/tree/5223e44cfeb26f41380057a2eb4d651197475f69[BOOM] | M, S, U | None | IMAFDC, Za64rs, Za128rs, Zicsr, Zifencei, Zicntr, Zihpm, Sv39, Svbare, Svade, Sstvecd, Sstvecv, Ssu64xl, Sscounterenwfootnote:boomnob[BOOM v3 does not implement the bit-manipulation extensions.] | 12,728footnote:hlboom[riscv-boom only; BOOM also reuses Rocket's page-table walker, FPU, and TileLink, which are not added. The generated Verilog of the tile, including those parts, is 115,547 lines.] | 9.6 k
| https://github.com/SpinalHDL/NaxRiscv/tree/9f452d50560d02fb391bc8039f5453c54e0911af[NaxRiscv] | M, S, U | None | IMAFDC, Zicsr, Zicntr, Zihpm, Zifencei, Ssu64xl, Sstvecd, Sv39, Svbare | 14,985footnote:hlnax[The plugins of the RV64 configuration with C, F, and D (FPU 1,817 lines). The generated Verilog is 66,297 lines.] | 308 k
| https://github.com/T-head-Semi/openc910/tree/b91c90914c19f114d35c8f6b73408eb241ed847c[OpenC910] | M, S, U | CLINT, PLIC, debug (in the cluster) | IMAFDC, Zicsr, Zifencei, Zicntr, Zihpm, Sv39, Svbare | 293,663footnote:hlc910[One core of the cluster: core, MMU, PMP, bus interface, performance counters, and its per-core debug unit, with the L1 SRAM models; not the L2 cache, CLINT, PLIC, or cluster logic. The released RTL appears to be written out by a tool, which inflates the count.] | 3.0 k
| https://github.com/OpenXiangShan/XiangShan/tree/e7bab53e66dfb3c4a1d11cf9519b0396f8576cae[XiangShan Kunminghu] | M, S, U, H | None | RVA23S64 profile (108 extensions in its riscv-arch-test configuration)footnote:xsext[Every RVA23S64 extension plus H; the riscv-arch-test configuration lists them.] | 115,176footnote:hlxs[XiangShan's core and utility source (84,897 lines), the yunsuan floating-point and vector units it uses (26,570), and hardware helpers (3,709); not the L2 (coupledL2, huancun), OpenLLC, difftest, AIA, or SoC. The generated Verilog of the core is 3.17 million lines.] | 1.8 k
6+h| Embedded cores with caches or tightly coupled memories
| link:../config/rv32imcb/config.vh[cvw rv32imcb] | M, U | CLINT, PLIC, UART, GPIO, SPI, PWMfootnote:cvwperiph[] | IMCB, Zbc, Zicsr, Zicntr, Zihpm | 11,603footnote:hlcvw[] | 946 k
| https://github.com/stnolting/neorv32/tree/b1f307244928161a3fca1a010af11d5a736b5339[NEORV32] | M, U | CLINT | IMACB, Zbc, Zbkc, Zcb, Zicond, Zicsr, Zifencei, Zicntr, Zihpm, Zihintpause, Zihintntl, Zkt, Smcntrpmf | 6,633footnote:hlneo[The CPU complex with its caches and bus; the FPU, CFU, and crypto units are disabled in this configuration and not counted.] | 277 k
| https://github.com/lowRISC/ibex/tree/e9f55342edbd27e9e17a0e41b1c95a81abb5eac8[Ibex (OpenTitan)] | M, U | None | IMCB, Zcb, Zicsr, Zifencei, Zbc, Zbkc, Zbkb, Zbkx, Zicntr, Zihpmfootnote:ibexun[Also implements Zcmp, Smepmp, and debug, which the riscv-arch-test configuration does not claim.] | 18,642footnote:hlibex[`ibex_top` with the OpenTitan parameters (lockstep, instruction cache with ECC, 16 PMP regions) and the primitives it uses.] | 140 k
| https://github.com/chipsalliance/Cores-VeeR-EL2/tree/925f3a34bdadc8f28b12a70cfb73e043b0f5ef3d[VeeR EL2] | M, U | PIC, 2 timers, debug module, DMA | IMCB, Zicsr, Zbc, Zbkc, Zihpm, Zifencei | 17,765footnote:hlel2[The VeeR wrapper, including the interrupt controller, DMA, and debug; EL2's memory arrays are in its testbench and not counted.] | 66 k
| https://github.com/T-head-Semi/opene906/tree/c5b878958e73e0b8f324a8132943f184a7831c07[OpenE906] | M, U | CLIC, CLINT, debug | IMAFC, Zicsr, Zifencei, Zicntr, Zihpm, Zicclsm | 71,755footnote:hle906[Core, FPU, PMP, bus interface, performance counters, trigger unit, and SRAM models; not the debug transport, CLINT, or CLIC.] | 119 k
| https://github.com/litex-hub/pythondata-cpu-vexriscv/tree/642ecfed1c84460555d6d803d660cc60cfc1ecb6[VexRiscv] | M | None | IMAC, Zicsr, Zicntr, Zifencei | 6,444footnote:hlvex[The framework, caches, and the 18 plugins of the IMAC configuration, at VexRiscv b6118e5, which pythondata 642ecfe pins. The generated Verilog is 7,040 lines.] | 1.46 M
| https://github.com/openhwfoundation/cva6/tree/81245a47fad8fe1a5d562d953ef2662e099def76[CVA6 cv32a65x] | M | Nonefootnote:a65cvxif[Includes the CV-X-IF example coprocessor, which decodes some custom and floating-point opcodes.] | IMCB, Zbc, Zbkc, Zcb, Zicsr, Zifencei | 29,924footnote:hlcva6[] | 50 k
| https://github.com/chipsalliance/Cores-VeeR-EH1/tree/d04b1c7ae675a63dc4307cacfd10547ec937b928[VeeR EH1] | M | PIC, 2 timers, debug module, DMA | IMC, Zicsr, Zifencei | 16,312footnote:hlveer[The VeeR wrapper, which includes the interrupt controller, DMA, debug, and the I$, ICCM, and DCCM arrays.] | 169 k
| https://github.com/chipsalliance/Cores-VeeR-EH2/tree/a7203d02d4774c9b8aa08b4827ec300d2c80a388[VeeR EH2] | M | PIC, 2 timers, debug module, DMA | IMACB, Zbc, Zbkb, Zbkc, Zbkx, Zicsr, Zifencei | 24,748footnote:hlveer[] | 67 k
6+h| Microcontroller cores
| link:../config/rv32imc/config.vh[cvw rv32imc] | M, U | CLINT, PLIC, UART, GPIO, SPI, PWMfootnote:cvwperiph[] | IMC, Zicsr, Zicntr, Zihpm | 11,603footnote:hlcvw[] | 1.33 M
| https://github.com/MikeOpenHWGroup/cve2/tree/094e9742648f3f527c6f47d047e625600653a9aa[CV32E20] | M | None | IMC, Zicsr, Zifencei | 7,657 | 1.19 M
| https://github.com/T-head-Semi/opene902/tree/991836411b405ac6a0a8d7668f2f5de6fa2a5b8c[OpenE902] | M, U | CLIC | EMC, Zicsr, Zifencei | 20,592footnote:hle902[Core, PMP, bus interface, and system I/O; not the debug unit (2,971 lines), which includes the triggers.] | 189 k
| https://gitlab.com/shaktiproject/cores/e-class/-/tree/e8a0dfd2d1c4907c74fb58432e379016871fdd3a[Shakti E-class] | M, U | None | IMAC, Zicsr, Zifencei, Zicntr, Zihpm, Zihintntl, Zihintpausefootnote:eclasstpl[Benchmarked and synthesized with the repository's ASIC template (see its synthesis note); riscv-arch-test builds it with AXI4 and a simulation multiplier.] | 7,136footnote:hlshe[The core, multiply/divide unit, and AXI4-Lite interface. The generated Verilog is 15,935 lines.] | 75 k
| https://github.com/Wren6991/Hazard3/tree/ba0c83c657a21f2e9946cf02cbc6c8d3d9a7dab6[Hazard3] | M, U | None | IMACB, Zcb, Zbc, Zbkc, Zbkb, Zbkx, Zicsr, Zifencei, Zicntr, Zihintntl, Zihintpause | 5,977footnote:hlhz3[`hazard3_cpu_2port` and its headers; not the debug module or transport.] | 966 k
| https://github.com/openhwgroup/cv32e40p/tree/360d272898d81806be3377193870dbf83a3ea79f[CV32E40P RV32IMC] | M | None | IMC, Zicsr, Zifencei, Zicntr | 10,956 | 1.16 M
| https://github.com/openhwgroup/cv32e40p/tree/360d272898d81806be3377193870dbf83a3ea79f[CV32E40P RV32IMCF] | M | None | IMFC, Zicsr, Zifencei, Zicntr | 17,754footnote:hle40pf[Including the FPU wrapper, the cvfpu and common_cells modules it uses, and the divide/square-root unit.] | 832 k
| https://github.com/openhwfoundation/cv32e40s/tree/9d9cae78b01a11458953133d1173c61933a2ba86[CV32E40S RV32IMC] | M, U | None | IMC, Zcb, Zcmp, Zcmt, Zicsr, Zifencei, Zktfootnote:e40sun[Also implements Smepmp, Smstateen, and the Xsecure hardening features, which the riscv-arch-test configuration does not claim.] | 11,533 | 524 k
| https://github.com/openhwfoundation/cv32e40s/tree/9d9cae78b01a11458953133d1173c61933a2ba86[CV32E40S RV32IMCB] | M, U | None | IMCB, Zcb, Zcmp, Zcmt, Zicsr, Zifencei, Zkt, Zbc, Zbkcfootnote:e40sun[] | 11,822 | 300 k
| https://github.com/openhwgroup/cv32e40x/tree/d952cd63bc1b4eb58cd893c28ef8283c781e345e[CV32E40X] | M | None | IMC, Zcb, Zcmp, Zcmt, Zkt, Zicsr, Zifencei, Zicntr | 10,037 | 380 k
6+h| Minimal cores
| link:../config/rv32e/config.vh[cvw rv32e] | M | None | E | 11,603footnote:hlcvw[] | 614 k
| link:../config/rv32i/config.vh[cvw rv32i] | M | None | I | 11,603footnote:hlcvw[] | 1.56 M
| https://github.com/YosysHQ/picorv32/tree/ef203c2b0a3fb793280f5114941416c425c5b461[PicoRV32] | M | None | IMCfootnote:nomul[Synthesized and benchmarked without M, which riscv-arch-test's configuration includes: a multiplier would be most of the core's area.] | 2,664 | 1.83 M
| https://github.com/olofk/serv/tree/f200eb2ed7b69ac1c6b8eddd47654522aeee5ce8[SERV] | M | None | IMC, Zicsr, Zifenceifootnote:nomul[] | 2,354footnote:hlserv[SERV with its multiply/divide unit; its register file is in servant's RAM, and servile's glue (340 lines) is not counted.] | 131 k
|===

== Performance

Benchmark scores per MHz and synthesized clock frequency.

[cols="3,2,2,2,2",options="header"]
|===
| Core | CoreMark/MHz | CoreMark IPC | Embench Speed | Clock (MHz)footnote:synprelim[The best of several targets (at least one that meets timing and two above it), with automatic ungrouping (`compile_ultra -no_seq_output_inversion`), and with fmax counting paths launched and captured on opposite clock edges at half the period: 1 / max(period − slack of full-cycle paths, period − 2 × slack of half-cycle paths). CORE-V-Wally writes its register files on the falling clock edge, so paths into them are half-cycle paths; they do not set the frequency of any configuration here.]
5+h| Application cores
| link:../config/rv64gc/config.vh[cvw rv64gc] | 4.20footnote:cmcvw[From the link:../README.md#configurations[README], which uses the same CoreMark port.] | 0.89 | 1.87footnote:embcvw64[With the common build and the medany GCC 16.1 toolchain used for every RV64 core; the README's 2.03 uses GCC 15.2 with the program linked at 0x4000_0000.] | 770footnote:syncvw[From the link:../README.md#configurations[README Configurations table].]
| link:../config/rv32gc/config.vh[cvw rv32gc] | 4.33footnote:cmcvw[] | 0.88 | 1.70footnote:embcvw[From the link:../README.md#configurations[README], built with CORE-V-Wally's own Embench build; the common build in benchmarks/comparison gives 1.572 on rv32imc (README 1.578).] | 920footnote:syncvw[]
| https://github.com/ucb-bar/chipyard/tree/0acc1e1de2d3284bcd4d876956932a013ffe1949[Rocket] | 3.10 | 0.76 | 1.58 | 1430footnote:synrocket[`RocketTile` with the Saturn vector unit as riscv-arch-test builds it, but with 6 performance counters instead of 29. The I$ and D$ data arrays and tags are single-port macros. The critical path runs through Saturn's vector integer multiply pipeline.]
| https://github.com/openhwfoundation/cva6/tree/81245a47fad8fe1a5d562d953ef2662e099def76[CVA6 cv64a6_&#8203;imafdc_&#8203;sv39_&#8203;hpdcache] | 3.44footnote:cmcva6[The testharness's 2,000,000-cycle limit is raised.] | 0.73 | 1.58 | 1310footnote:syncva6[`cva6`, the top of CVA6's own synthesis flow, with its I$, write-through HPDcache D$, AXI adapter, MMU, and PMP; the RVFI trace port is tied off. AMOs execute outside the core, in the testbench's AXI atomics adapter, so they are not included. The register files, TLBs, and arrays of at most 4 Kbit are flip-flops.]footnote:syncv64[Includes the FPU (FPnew with the T-Head divider and square root). The FMA and the path from `satp`'s ASID to the I$ data macro both limit the clock to about 1300 MHz.]
| https://github.com/openhwfoundation/cva6/tree/81245a47fad8fe1a5d562d953ef2662e099def76[CVA6 cv32a6_&#8203;imac_&#8203;sv32] | 3.52footnote:cmcva6[] | 0.71 | 1.49 | 1510footnote:syncva6[]footnote:syncv32[The shared TLB's 64-entry arrays are under 4 Kbit, so they are flip-flops: the MMU holds 6,300 flip-flops. The critical path runs from a D$ directory macro to the write buffer.]
| https://gitlab.com/shaktiproject/cores/c-class/-/tree/6feeb421f02f5f76dacba3c44caa61cfba60b56f[Shakti C-class] | 3.43 | 0.85 | 1.58 | 1450footnote:synshc[`mkccore_axi4` (core, caches, TLBs, page-table walker, FPU, PMP, and two AXI4 masters), generated by bsc from the riscv-arch-test configuration without its trace, assertion, and simulation-only logic. The RTL builds the 16 KB I$ and D$ as 104 separate 64-word arrays (64 × 32 and 64 × 64 data, 64 × 20 tags), so their macros are small and cost about 1 µm^2^ per bit, 55% of the total area; macros of 4 KB per way would be about a quarter of that. The register files are flip-flops. The critical path runs from an I$ tag macro through the hit and way selection.]
| https://github.com/bsc-loca/core_tile/tree/2528e7df6507fa06d372f001e55cfd46efae4a4b[Sargantana] | 3.40 | 0.83 | 1.64footnote:embsarg[Built for RV64IM: Sargantana has no C, and the medany toolchain has no RV64IMA library without it.] | 820footnote:synsarg[`top_tile`, the top of Sargantana's own synthesis flow, in the default configuration riscv-arch-test builds: it includes the 128-bit SIMD and vector unit (about 37,000 flip-flops) and the load bypass (`SARG_BYPASS_LSQ`). AMOs execute in the L2, outside the tile. The physical register files (integer, FP, and 64 × 128 vector) and the BTB are flip-flops. The critical path runs from the vector address generator to a D$ data macro.]
| https://github.com/riscv-boom/riscv-boom/tree/5223e44cfeb26f41380057a2eb4d651197475f69[BOOM] | 5.90 | 1.46 | 2.63 | 1240footnote:synboom[`BoomTile` as riscv-arch-test builds it, with 6 performance counters. Its 12 arrays of 4 Kbit or more (I$ and D$ data and tags, the L2 TLB, the BTB, and the TAGE and bimodal predictor tables) are 23 single- and two-port macros. The five smaller ones are flip-flops, and the ROB's 2 Kbit copy of instructions for the trace port, which nothing reads, is removed. The critical path runs from the loop predictor's update index to the bimodal predictor table's macro.]
| https://github.com/SpinalHDL/NaxRiscv/tree/9f452d50560d02fb391bc8039f5453c54e0911af[NaxRiscv] | 5.36footnote:cmnax[NaxRiscv's simulator memory has a 1-cycle minimum latency and then delivers each 64-bit beat with probability 100/128 per cycle.] | 1.33 | 2.65 | 1420footnote:synnax[`NaxRiscv` as riscv-arch-test generates it (RV64IMAFDC, Sv39), but with `asic = true`: the out-of-order core with its 16 KB I$ and D$ and native memory buses. Its cache data, BTB, gshare, and hit-prediction arrays have separate read and write ports, so they are two-port register-file macros, about twice the area of single-port ones. NaxRiscv is written for FPGAs: 151 smaller arrays (85 Kbit: physical register files, TLBs, cache tags, and reorder, load, store, and issue queues) are multiported or read asynchronously, so they are flip-flops with their read multiplexers, which make up most of the flip-flops and logic area; an ASIC implementation would use register-file macros. `asic = true` builds the multiplier from 65 × 1-bit partial products instead of the 17 × 17-bit DSP blocks of an FPGA, with the same latency, and has the load/store unit share an integer register-file write port. riscv-arch-test's `asic = false` build reaches 1440 MHz at 0.629 mm^2^, and both run CoreMark in the same number of cycles. The critical path runs from the gshare macro through the branch-history hash back to the macro's address.]
| https://github.com/T-head-Semi/openc910/tree/b91c90914c19f114d35c8f6b73408eb241ed847c[OpenC910] | 6.10 | 1.51 | 3.37 | 1790footnote:sync910[`ct_top`: one core with its 64 KB I$ and D$, MMU with 1024-entry JTLB, PMP, and per-core bus interface, configured by the stock `cpu_cfig.h` that riscv-arch-test builds. The L2, coherence unit, CLINT, PLIC, shared debug logic, and second core of riscv-arch-test's dual-core cluster are left out. The cache data and tags, BHT, BTB, indirect BTB, and JTLB are single-port macros; the physical register files are flip-flops. The latch is the core clock gate's enable latch. The critical path is the I$ data macro's read into the fetch stage's instruction register, so the clock is set by the estimated macro access time.]
| https://github.com/OpenXiangShan/XiangShan/tree/e7bab53e66dfb3c4a1d11cf9519b0396f8576cae[XiangShan Kunminghu] | 10.2footnote:cmxs[Three iterations rather than ten, because the Verilator emulator runs about 300 cycles per second.] | 2.14 | 6.43 | —footnote:synpend[Not yet synthesized.]
5+h| Embedded cores with caches or tightly coupled memories
| link:../config/rv32imcb/config.vh[cvw rv32imcb] | 4.06footnote:cmcvw[] | 0.83 | 1.65footnote:embcvw[] | 1890footnote:syncvw[]
| https://github.com/stnolting/neorv32/tree/b1f307244928161a3fca1a010af11d5a736b5339[NEORV32] | 1.24 | 0.25 | 0.52 | 1950footnote:synneo[NEORV32 v1.13.7 `neorv32_top` with the riscv-arch-test generics, but no CLINT and 8 PMP regions (the fewest riscv-arch-test's PMP tests accept; its configuration has 16): the core complex, its 4 KB I$ (a 1024 × 32 single-port data macro; the 64 × 20 tag array is flip-flops), and the bus gateway, external bus interface, I/O switch, SYSINFO, and the atomic-memory-operation and LR/SC units, which NEORV32 places outside the core complex. The I$ data macro's 0.51 ns minimum cycle time sets the clock frequency.]
| https://github.com/lowRISC/ibex/tree/e9f55342edbd27e9e17a0e41b1c95a81abb5eac8[Ibex (OpenTitan)] | 4.16footnote:cmibex[The boot code enables the instruction cache, which resets disabled; with the testbench's zero-wait memory it makes no difference (4.16 without).] | 0.84 | 1.60 | 1110footnote:synibex[`ibex_top` with the OpenTitan parameters riscv-arch-test builds: 16 PMP regions, 10 performance counters, debug triggers, the security features, and the scrambled, ECC-protected 4 KB I$ (two 256 × 28 tag and two 256 × 78 data macros). Its critical path runs from an I$ tag macro through descrambling, ECC check, and tag compare to the instruction register. The security features (the lockstep shadow core, dummy-instruction insertion, I$ scrambling, and ECC on the memory buses) account for nearly all of the area beyond Ibex's maxperf-pmp-bmfull-icache configuration, which has the same pipeline, I$, and PMP, runs the benchmarks in the same number of cycles, and synthesizes to 1160 MHz, 0.055 mm^2^, 3,302 flip-flops, and 31,547 gates. Ibex's basic "maxperf" configuration (no I$, PMP, or security features) synthesizes to 1700 MHz, 0.021 mm^2^, 2,037 flip-flops, and 13,569 gates.]
| https://github.com/chipsalliance/Cores-VeeR-EL2/tree/925f3a34bdadc8f28b12a70cfb73e043b0f5ef3d[VeeR EL2] | 4.78footnote:cmveer[With the stack, which holds CoreMark's data, in the DCCM, as VeeR's own CoreMark does; EH1 scores 1.85 with it in external memory.]footnote:cmel2[5 iterations: the testbench stops at 2,000,000 cycles.] | 0.97 | 1.67footnote:emblong[On a copy of the simulator rebuilt with a higher cycle limit; the riscv-arch-test build stops before the longest benchmarks finish.] | 1010footnote:synveer[The VeeR wrapper with the configuration riscv-arch-test builds, but with the ICCM and DCCM removed and without the JTAG transport (the debug module interface becomes ports). It includes the debug module, interrupt controller, DMA controller, trace port, and four 64-bit AXI4 ports, which the cores do not let us remove. The register file is flip-flops; the I$ data and tag arrays are macros. The cores are built with fpga_optimize=1, as riscv-arch-test simulates them, which replaces clock gates with enables. With fpga_optimize=0 and TSMC integrated clock gates (423, 1,195, and 912 of them), EH1, EH2, and EL2 reach 2060, 1630, and 985 MHz in 0.147, 0.246, and 0.159 mm^2^ (+4%, +4%, and −1.5% clock frequency; −4%, −5%, and −8% area), before clock-tree insertion delay through the gates is modeled.]footnote:synel2[With 16 PMP entries, VeeR's default; riscv-arch-test configures 64, which reaches 950 MHz at 0.211 mm^2^ with the PMP checker and its CSRs taking 29% of the logic area. The critical path runs from the instruction aligner to an I$ data macro. The 512 × 22 BTB (11 Kbit) has two combinational read ports, so it is flip-flops.]
| https://github.com/T-head-Semi/opene906/tree/c5b878958e73e0b8f324a8132943f184a7831c07[OpenE906] | 3.05footnote:cme906[The configuration's boot code enables the caches, which reset disabled. Code and data share one zero-wait-state SRAM.] | 0.73 | 1.43 | 1590footnote:syne906[`pa_core_top`: the core with its caches, FPU, 8-region PMP, and three AHB-Lite masters, configured by the stock `cpu_cfig.h` that riscv-arch-test builds; the CLIC, CLINT, and debug module are left out. The I$ and D$ data and tags and the 8 Kbit BHT are single-port macros. The critical path runs from the D$ tag macro through load forwarding and the register scoreboard's stall to the instruction buffer. Its 5-stage pipeline clocks faster than OpenE902's 2 stages.]
| https://github.com/litex-hub/pythondata-cpu-vexriscv/tree/642ecfed1c84460555d6d803d660cc60cfc1ecb6[VexRiscv] | 2.88footnote:cmvex[The testbench memory takes 2 cycles per 32-bit Wishbone beat, so a cache line refill takes 16 cycles.] | 0.69 | 1.11 | 1420footnote:synvex[`VexRiscv` from the LiteX netlist riscv-arch-test uses, with its two Wishbone masters. Its 4 KB I$ and 4 KB D$ data arrays each have a read port and a separate write port, so they are two-port register-file macros (1024 × 32), about twice the area of single-port macros, and their 0.70 ns minimum cycle time sets the clock frequency (the logic alone reaches 1630 MHz). The two 128 × 22 tag arrays (under 4 Kbit) and the register file are flip-flops, most of the 8,277.]
| https://github.com/openhwfoundation/cva6/tree/81245a47fad8fe1a5d562d953ef2662e099def76[CVA6 cv32a65x] | 5.37 | 1.09 | 1.76 | 1510footnote:syncva6[]footnote:syncv65x[The I$ tags (2 × 64 × 25) and D$ directory (2 × 64 × 28) are under 4 Kbit, so they are flip-flops; with the HPDcache's miss and write buffers they are about 8,300 of the 13,694 flip-flops. The critical path runs from operand read to the scoreboard.]
| https://github.com/chipsalliance/Cores-VeeR-EH1/tree/d04b1c7ae675a63dc4307cacfd10547ec937b928[VeeR EH1] | 5.16footnote:cmveer[] | 1.23 | 1.48footnote:emblong[] | 1970footnote:synveer[]footnote:syneh1[The critical path runs from an I$ tag macro to the instruction aligner, so the clock frequency depends on the macro's estimated access time. The 32-entry BTB and 128 × 2 BHT are flip-flops.]
| https://github.com/chipsalliance/Cores-VeeR-EH2/tree/a7203d02d4774c9b8aa08b4827ec300d2c80a388[VeeR EH2] | 6.30footnote:cmveer[]footnote:cmeh2[With one hardware thread.] | 1.28footnote:ipcother[The core's `minstret` is missing or does not count, so the instruction count is that of the same binary on another core: CoreMark's timed region executes the same instructions on every core built for the same ISA.] | 1.93 | 1560footnote:synveer[]footnote:syneh2[One thread, as riscv-arch-test builds it. The DCCM controller stays (VeeR requires a DCCM with atomics), but its arrays are removed. The 512 × 22 BTB (11 Kbit) has two combinational read ports, so it is flip-flops. The critical path runs from the I$ tag macro to the fetch address.]
5+h| Microcontroller cores
| link:../config/rv32imc/config.vh[cvw rv32imc] | 3.54footnote:cmcvw[] | 0.85 | 1.58footnote:embcvw[] | 1880footnote:syncvw[]
| https://github.com/MikeOpenHWGroup/cve2/tree/094e9742648f3f527c6f47d047e625600653a9aa[CV32E20] | 2.76 | 0.66 | 1.22 | 1890footnote:syncg[`cve2_top` with the default parameters the testbench uses; the latch is the enable latch of the behavioral clock gate.]
| https://github.com/T-head-Semi/opene902/tree/991836411b405ac6a0a8d7668f2f5de6fa2a5b8c[OpenE902] | 2.59 | 0.64footnote:ipcother[] | 0.80footnote:emblong[] | 1050footnote:syne902[`cr_core_top`: the core with its 8-region PMP and AHB-Lite masters, configured by the stock `cpu_cfig.h` that riscv-arch-test builds. `openE902` also has a CLIC, a CLINT, and the debug module, which add 0.008 mm^2^.]
| https://gitlab.com/shaktiproject/cores/e-class/-/tree/e8a0dfd2d1c4907c74fb58432e379016871fdd3a[Shakti E-class] | 0.67footnote:cmshe[With the ASIC template's AXI4-Lite fabric; E-class has no caches, so every fetch and load is a bus transaction to block RAM. With the AXI4 fabric of the riscv-arch-test build, it is 0.56.] | 0.16footnote:ipcother[] | 0.31 | 2080footnote:synshe[`mkeclass`, the core below the SoC (no CLINT, PLIC, or fabric), generated by bsc with the repository's ASIC template (`templates/synth32.inc`: ASIC multiplier with 4 multiply and 32 divide stages, AXI4-Lite) except where riscv-arch-test needs otherwise: 16 PMP entries (with fewer, `pmpaddr8`–`pmpaddr15` raise illegal-instruction exceptions), the reset address, and no user-level traps, debug, triggers, or HPM counters, which its riscv-arch-test configuration does not declare. The critical path is the multiplier's accumulate step. The riscv-arch-test build, with its single-cycle simulation multiplier, runs at 1400 MHz.]
| https://github.com/Wren6991/Hazard3/tree/ba0c83c657a21f2e9946cf02cbc6c8d3d9a7dab6[Hazard3] | 4.30 | 0.87 | 1.71 | 1370footnote:synhz3[`hazard3_cpu_2port` with the riscv-arch-test configuration's parameters, which also enable Zbkb, Zbkx, Zcb, 16 PMP regions (26% of the area), debug support, 4 triggers, and 32 interrupts; without the debug module and JTAG transport.]
| https://github.com/openhwgroup/cv32e40p/tree/360d272898d81806be3377193870dbf83a3ea79f[CV32E40P RV32IMC] | 3.44footnote:cmcnt[The boot code clears `mcountinhibit`: the counters reset stopped.] | 0.82 | 1.53 | 2090footnote:syncge4[The latches are the enable latches of the repository's behavioral clock-gate model: one in the sleep unit, one for the CV32E40P FPU, and in CV32E40S one per hardened CSR. Their paths borrow up to a full cycle, so they count as full-cycle paths.]
| https://github.com/openhwgroup/cv32e40p/tree/360d272898d81806be3377193870dbf83a3ea79f[CV32E40P RV32IMCF] | 3.44footnote:cmcnt[] | 0.82 | 1.53 | 1540footnote:syncge4[]footnote:syne40pf[With FPU_ADDMUL_LAT = FPU_OTHERS_LAT = 1, a verified setting, and with DC register retiming on the FPU wrapper, as the CV32E40P integration guide prescribes (FPnew places the pipeline registers at its outputs). FP add, multiply, and other non-divide operations take two cycles. The critical path runs from the operand register in the decode stage through the fused multiply-add to the first retimed FPU register. The single-cycle FPU that the riscv-arch-test testbench configures (latencies 0) limits the clock to 860 MHz at 0.036 mm^2^. Two-cycle latencies gain nothing in this flow (1350 MHz), because retiming leaves a stage inside the multiplier's datapath block. The benchmarks are compiled without F, so the FPU latency does not affect them.]
| https://github.com/openhwfoundation/cv32e40s/tree/9d9cae78b01a11458953133d1173c61933a2ba86[CV32E40S RV32IMC] | 2.78footnote:cmcnt[]footnote:cme40s[At reset settings: `cpuctrl.dataindtiming` = 1 makes divides and branches fixed-latency (3.11 for RV32IMC and 3.48 for RV32IMCB with it cleared). On a copy of the riscv-arch-test testbench without its fixed 2-cycle data-bus stalls (1.79 for RV32IMC and 1.91 for RV32IMCB with them).] | 0.66 | 1.36 | 1800footnote:syncge4[]footnote:syne40s[`cv32e40s_core` in a wrapper that sets the testbench's PMA and LFSR parameters; it includes register-file ECC, hardened CSRs, dummy-instruction logic, and, in RV32IMCB, 16 PMP regions.]
| https://github.com/openhwfoundation/cv32e40s/tree/9d9cae78b01a11458953133d1173c61933a2ba86[CV32E40S RV32IMCB] | 3.05footnote:cmcnt[]footnote:cme40s[] | 0.62 | 1.41 | 1670footnote:syncge4[]footnote:syne40s[]
| https://github.com/openhwgroup/cv32e40x/tree/d952cd63bc1b4eb58cd893c28ef8283c781e345e[CV32E40X] | 3.44footnote:cmcnt[]footnote:cme40x[On a copy of the riscv-arch-test testbench without its fixed 2-cycle data-bus stalls (2.04 with them).] | 0.82 | 1.53 | 1850footnote:syncge4[]footnote:syne40x[`cv32e40x_core` in a wrapper that ties off the unused X interface (X_EXT = 0), with the testbench's parameters.]
5+h| Minimal cores
| link:../config/rv32e/config.vh[cvw rv32e] | 0.35footnote:cmcvw[] | 0.25 | 0.20footnote:embcvw[] | 2800footnote:syncvw[]
| link:../config/rv32i/config.vh[cvw rv32i] | 1.04footnote:cmcvw[] | 0.71 | 0.63footnote:embcvw[] | 2780footnote:syncvw[]
| https://github.com/YosysHQ/picorv32/tree/ef203c2b0a3fb793280f5114941416c425c5b461[PicoRV32] | 0.35footnote:cmpico[Timed with `rdcycle`: PicoRV32 has no `mcycle`.]footnote:cmnom[Compiled without M (`-march=rv32ic_zicsr`), so multiplies and divides are library calls. With M, as riscv-arch-test builds the core: PicoRV32 0.95, SERV 0.072.] | 0.24 | 0.18 | 4140footnote:synpico[Without the multiplier and divider (`ENABLE_MUL`, `ENABLE_FAST_MUL`, and `ENABLE_DIV` = 0); with the fast multiplier and the divider that riscv-arch-test builds, it runs at 2460 MHz in 0.016 mm^2^. The `always @*` at picorv32.v:401 has a Verilog `(* full_case *)` attribute, which Yosys honors and Design Compiler ignores; the synthesized copy adds `// synopsys full_case`, so that Design Compiler does not infer 68 latches.]
| https://github.com/olofk/serv/tree/f200eb2ed7b69ac1c6b8eddd47654522aeee5ce8[SERV] | 0.025footnote:cmserv[SERV has no cycle counter: timed with the testbench's `servant_timer`, which counts cycles.]footnote:cmnom[] | 0.017footnote:ipcother[] | 0.014footnote:emblong[] | 4010footnote:synserv[`servile` (SERV and its bus arbiter) without the optional multiply/divide unit, and its 1,152-bit register-file RAM in flip-flops, with the parameters servant uses; servant's memory, timer, and GPIO are not included. The critical path is the register-file read. With the multiply/divide unit, as riscv-arch-test builds it, SERV runs at 2380 MHz in 0.014 mm^2^.]
|===

== Area

Synthesized area and size of each core with its L1 caches.

[cols="3,2,2,2,2,2",options="header"]
|===
| Core | Total Area (mm^2^) | Logic Area (mm^2^) | Flip-Flops | Gates | RAM Bits
6+h| Application cores
| link:../config/rv64gc/config.vh[cvw rv64gc] | 0.48 | 0.17 | 24,416 | 139,072 | 356,352
| link:../config/rv32gc/config.vh[cvw rv32gc] | 0.43 | 0.11 | 16,496 | 89,945 | 312,320
| https://github.com/ucb-bar/chipyard/tree/0acc1e1de2d3284bcd4d876956932a013ffe1949[Rocket] | 0.385 | 0.233 | 34,620 | 203,530 | 546,304
| https://github.com/openhwfoundation/cva6/tree/81245a47fad8fe1a5d562d953ef2662e099def76[CVA6 cv64a6_&#8203;imafdc_&#8203;sv39_&#8203;hpdcache] | 0.371 | 0.204 | 26,418 | 161,013 | 537,600
| https://github.com/openhwfoundation/cva6/tree/81245a47fad8fe1a5d562d953ef2662e099def76[CVA6 cv32a6_&#8203;imac_&#8203;sv32] | 0.239 | 0.094 | 16,736 | 70,196 | 470,016
| https://gitlab.com/shaktiproject/cores/c-class/-/tree/6feeb421f02f5f76dacba3c44caa61cfba60b56f[Shakti C-class] | 0.502 | 0.224 | 36,820 | 181,212 | 272,384
| https://github.com/bsc-loca/core_tile/tree/2528e7df6507fa06d372f001e55cfd46efae4a4b[Sargantana] | 1.148 | 0.874 | 148,143 | 697,575 | 417,792
| https://github.com/riscv-boom/riscv-boom/tree/5223e44cfeb26f41380057a2eb4d651197475f69[BOOM] | 0.618 | 0.395 | 82,476 | 305,498 | 412,672
| https://github.com/SpinalHDL/NaxRiscv/tree/9f452d50560d02fb391bc8039f5453c54e0911af[NaxRiscv] | 0.619 | 0.421 | 96,391 | 307,941 | 331,264
| https://github.com/T-head-Semi/openc910/tree/b91c90914c19f114d35c8f6b73408eb241ed847c[OpenC910] | 1.016 | 0.666 | 92,436 + 1 latch | 640,237 | 1,496,320
| https://github.com/OpenXiangShan/XiangShan/tree/e7bab53e66dfb3c4a1d11cf9519b0396f8576cae[XiangShan Kunminghu] | — | — | — | — | —
6+h| Embedded cores with caches or tightly coupled memories
| link:../config/rv32imcb/config.vh[cvw rv32imcb] | 0.021 | 0.021 | 1,801 + 1,023 latches | 16,122 | 0
| https://github.com/stnolting/neorv32/tree/b1f307244928161a3fca1a010af11d5a736b5339[NEORV32] | 0.033 | 0.025 | 4,886 | 18,876 | 32,768
| https://github.com/lowRISC/ibex/tree/e9f55342edbd27e9e17a0e41b1c95a81abb5eac8[Ibex (OpenTitan)] | 0.105 | 0.084 | 9,175 | 71,263 | 54,272
| https://github.com/chipsalliance/Cores-VeeR-EL2/tree/925f3a34bdadc8f28b12a70cfb73e043b0f5ef3d[VeeR EL2] | 0.175 | 0.135 | 21,745 | 99,574 | 152,064
| https://github.com/T-head-Semi/opene906/tree/c5b878958e73e0b8f324a8132943f184a7831c07[OpenE906] | 0.143 | 0.071 | 10,860 | 62,658 | 291,072
| https://github.com/litex-hub/pythondata-cpu-vexriscv/tree/642ecfed1c84460555d6d803d660cc60cfc1ecb6[VexRiscv] | 0.068 | 0.032 | 8,277 | 21,818 | 65,536
| https://github.com/openhwfoundation/cva6/tree/81245a47fad8fe1a5d562d953ef2662e099def76[CVA6 cv32a65x] | 0.122 | 0.083 | 13,694 | 60,393 | 49,152
| https://github.com/chipsalliance/Cores-VeeR-EH1/tree/d04b1c7ae675a63dc4307cacfd10547ec937b928[VeeR EH1] | 0.153 | 0.091 | 13,880 | 70,487 | 144,640
| https://github.com/chipsalliance/Cores-VeeR-EH2/tree/a7203d02d4774c9b8aa08b4827ec300d2c80a388[VeeR EH2] | 0.259 | 0.179 | 31,524 | 136,452 | 304,128
6+h| Microcontroller cores
| link:../config/rv32imc/config.vh[cvw rv32imc] | 0.020 | 0.020 | 1,792 + 1,023 latches | 14,583 | 0
| https://github.com/MikeOpenHWGroup/cve2/tree/094e9742648f3f527c6f47d047e625600653a9aa[CV32E20] | 0.019 | 0.019 | 2,386 + 1 latch | 12,657 | 0
| https://github.com/T-head-Semi/opene902/tree/991836411b405ac6a0a8d7668f2f5de6fa2a5b8c[OpenE902] | 0.019 | 0.019 | 1,510 | 14,378 | 0
| https://gitlab.com/shaktiproject/cores/e-class/-/tree/e8a0dfd2d1c4907c74fb58432e379016871fdd3a[Shakti E-class] | 0.030 | 0.030 | 3,452 | 23,225 | 0
| https://github.com/Wren6991/Hazard3/tree/ba0c83c657a21f2e9946cf02cbc6c8d3d9a7dab6[Hazard3] | 0.026 | 0.026 | 2,668 | 20,614 | 0
| https://github.com/openhwgroup/cv32e40p/tree/360d272898d81806be3377193870dbf83a3ea79f[CV32E40P RV32IMC] | 0.020 | 0.020 | 2,130 + 1 latch | 16,331 | 0
| https://github.com/openhwgroup/cv32e40p/tree/360d272898d81806be3377193870dbf83a3ea79f[CV32E40P RV32IMCF] | 0.039 | 0.039 | 3,924 + 2 latches | 31,464 | 0
| https://github.com/openhwfoundation/cv32e40s/tree/9d9cae78b01a11458953133d1173c61933a2ba86[CV32E40S RV32IMC] | 0.023 | 0.023 | 2,972 + 12 latches | 16,418 | 0
| https://github.com/openhwfoundation/cv32e40s/tree/9d9cae78b01a11458953133d1173c61933a2ba86[CV32E40S RV32IMCB] | 0.039 | 0.039 | 4,191 + 45 latches | 29,202 | 0
| https://github.com/openhwgroup/cv32e40x/tree/d952cd63bc1b4eb58cd893c28ef8283c781e345e[CV32E40X] | 0.020 | 0.020 | 2,432 + 1 latch | 14,072 | 0
6+h| Minimal cores
| link:../config/rv32e/config.vh[cvw rv32e] | 0.0058 | 0.0058 | 573 + 495 latches | 3,650 | 0
| link:../config/rv32i/config.vh[cvw rv32i] | 0.0065 | 0.0065 | 573 + 1,023 latches | 4,495 | 0
| https://github.com/YosysHQ/picorv32/tree/ef203c2b0a3fb793280f5114941416c425c5b461[PicoRV32] | 0.010 | 0.010 | 1,605 | 8,000 | 0
| https://github.com/olofk/serv/tree/f200eb2ed7b69ac1c6b8eddd47654522aeee5ce8[SERV] | 0.006 | 0.006 | 1,354 | 3,757 | 0
|===

== Reproducing the Tables

The privilege modes and extensions are the `implemented_extensions` of each configuration's
https://github.com/riscv/riscv-unified-db[UDB] architecture yaml in riscv-arch-test, at
https://github.com/riscv/riscv-arch-test/tree/cbbb9f0eb59beb5588e9158a7c13aace48231c51[act4 cbbb9f0eb] or in the open pull request listed below.
U, S, and H appear as privilege modes; M implies Zmmul, A implies Zaamo and Zalrsc, C implies Zca and its F and D
variants, and B stands for Zba, Zbb, and Zbs.
The other rows summarize each core's documentation and RTL at the commit ACT pins in
`.github/scripts/install-<core>.sh`, for the build parameters that script and the configuration's `run_cmd.txt` use.
The CORE-V-Wally entries come from the link:../README.md#configurations[Configurations table] in the README.

=== Synthesis

Every core is synthesized with CORE-V-Wally's `synthDC` flow: Design Compiler Y-2026.03-SP3 in topographical mode with TSMC 28HPC+ TT
libraries (0.9 V, 25 °C) and TLU+ parasitics, so timing and area include wire delays.
The area covers the core and its L1 caches. L2 caches and tightly coupled memories (VeeR ICCM and DCCM, CORE-V-Wally IROM and DTIM)
are not included; CORE-V-Wally's microcontroller configurations are synthesized with the AHB bus in their place.
Small, multi-ported, or associative arrays (register files, TLBs, queues, small predictor tables) are synthesized as flip-flops.
Large one- and two-port arrays (cache data and tags, large predictor tables) are SRAM macros; Logic Area excludes them,
Total Area includes them, and RAM Bits is their capacity.
CORE-V-Wally instantiates macros generated with the TSMC 28HPC+ memory compilers.
For the other cores, each such array is an estimated macro of exactly its size: its area, access time, setup times, and cycle
time come from the TSMC 28HPC+ memory compilers' quick-reference tables at the same corner (SVT periphery), interpolated
between table entries, with the timing tables and pins of a generated macro of the same kind. The quick-reference tables
reproduce the generated macros' timing to within 1 ps and overstate their area by 5%, so the estimated areas are scaled by 0.95
(0.97 for dual-port macros); the two-port register-file compiler has no generated macro to compare against, so its areas are
not scaled. The clock frequency is also limited by each macro's minimum cycle time.

=== Embench

Embench speed runs on the same testbenches with the common build in link:../benchmarks/comparison/README.md[benchmarks/comparison]:
the flags of CORE-V-Wally's Embench speed build (`-O3 -flto -funroll-loops`, plus `-fwrapv` on RV32), no F or D on any core
(so the floating-point benchmarks use software floating point), riscv64-unknown-elf-gcc 15.2.0 for RV32, and a medany GCC 16.1.0
toolchain for RV64. The score is the geometric mean over the 22 benchmarks of Embench's baseline time divided by the measured
cycles at 1 MHz, as Embench's `benchmark_speed.py` computes it, and a benchmark counts only if its own check passes.

----
export ACT_CONFIGS=... CI_TOOLS=... RV64_TOOLCHAIN=<bin directory of a medany riscv64-unknown-elf toolchain>
benchmarks/comparison/embench/run_all.sh <core> ...
----

=== CoreMark

CoreMark runs on each core's riscv-arch-test testbench with link:../benchmarks/coremark[CORE-V-Wally's CoreMark port],
which link:../benchmarks/comparison/README.md[benchmarks/comparison] documents:

* The program boots, halts, and prints with the configuration's `rvmodel_macros.h` and links with its `link.ld`.
* Time is `mcycle` (or the noted substitute), and CoreMark/MHz = Iterations × 10^6^ / Total ticks, with 10 iterations unless noted.
  A result counts only if CoreMark reports "Correct operation validated".
* Every core is compiled with riscv64-unknown-elf-gcc 15.2.0 and CORE-V-Wally's CoreMark flags,
  for its subset of IMAFDC, Zba, Zbb, Zbs, and Zbc; other extensions such as Zcb, Zicond, scalar crypto, and V are not used.
* `ee_u32` is `signed int` on RV64, as in CORE-V-Wally's and SiFive's RV64 ports, and `unsigned int` on RV32.
* Core-specific steps, each footnoted in the table, are behind compile flags of the port.
* CoreMark IPC is the instructions retired in the timed region (`minstret`, with `-DCOUNT_INSTRET`) divided by its cycles.
  Cores built for the same ISA execute identical instruction counts there: 238,965 per iteration for RV32IMC, 203,014 with B and Zbc,
  247,612 for RV32EMC, 210,696 for RV64IMAFDC with B and Zbc, 243,700 with B but not Zbc, and 247,606 without B.

----
export ACT_CONFIGS=<directory of ACT configuration directories> CI_TOOLS=<directory of ACT core installs>
benchmarks/comparison/coremark/run_all.sh            # all cores, or name the ones to run
----

[cols="2,3,3",options="header"]
|===
| Core | Core source | riscv-arch-test configuration
| Rocket | https://github.com/ucb-bar/chipyard/tree/0acc1e1de2d3284bcd4d876956932a013ffe1949[chipyard 0acc1e1] | https://github.com/riscv/riscv-arch-test/pull/2652[riscv-arch-test#2652]
| CVA6 cv64a6_imafdc_sv39_hpdcache | https://github.com/openhwfoundation/cva6/tree/81245a47fad8fe1a5d562d953ef2662e099def76[cva6 81245a4] | https://github.com/riscv/riscv-arch-test/pull/3041[riscv-arch-test#3041]
| CVA6 cv32a6_imac_sv32 | https://github.com/openhwfoundation/cva6/tree/81245a47fad8fe1a5d562d953ef2662e099def76[cva6 81245a4] | https://github.com/riscv/riscv-arch-test/pull/3072[riscv-arch-test#3072]
| Shakti C-class | https://gitlab.com/shaktiproject/cores/c-class/-/tree/6feeb421f02f5f76dacba3c44caa61cfba60b56f[c-class 6feeb42] | https://github.com/riscv/riscv-arch-test/pull/3110[riscv-arch-test#3110]
| Sargantana | https://github.com/bsc-loca/core_tile/tree/2528e7df6507fa06d372f001e55cfd46efae4a4b[core_tile 2528e7d] | https://github.com/riscv/riscv-arch-test/tree/cbbb9f0eb59beb5588e9158a7c13aace48231c51/config/cores/sargantana/sargantana-rv64imafdb[ACT config]
| BOOM | https://github.com/riscv-boom/riscv-boom/tree/5223e44cfeb26f41380057a2eb4d651197475f69[riscv-boom 5223e44] | https://github.com/riscv/riscv-arch-test/pull/3111[riscv-arch-test#3111]
| NaxRiscv | https://github.com/SpinalHDL/NaxRiscv/tree/9f452d50560d02fb391bc8039f5453c54e0911af[NaxRiscv 9f452d5] | https://github.com/riscv/riscv-arch-test/pull/3108[riscv-arch-test#3108]
| OpenC910 | https://github.com/T-head-Semi/openc910/tree/b91c90914c19f114d35c8f6b73408eb241ed847c[openc910 b91c909] | https://github.com/riscv/riscv-arch-test/tree/cbbb9f0eb59beb5588e9158a7c13aace48231c51/config/cores/c910/c910-openc910[ACT config]
| XiangShan Kunminghu | https://github.com/OpenXiangShan/XiangShan/tree/e7bab53e66dfb3c4a1d11cf9519b0396f8576cae[XiangShan e7bab53] | https://github.com/riscv/riscv-arch-test/tree/cbbb9f0eb59beb5588e9158a7c13aace48231c51/config/cores/xiangshan/xiangshan-kmhv2[ACT config]
| NEORV32 | https://github.com/stnolting/neorv32/tree/b1f307244928161a3fca1a010af11d5a736b5339[neorv32 b1f3072] | https://github.com/riscv/riscv-arch-test/pull/3105[riscv-arch-test#3105]
| Ibex (OpenTitan) | https://github.com/lowRISC/ibex/tree/e9f55342edbd27e9e17a0e41b1c95a81abb5eac8[ibex e9f5534] | https://github.com/riscv/riscv-arch-test/tree/cbbb9f0eb59beb5588e9158a7c13aace48231c51/config/cores/ibex/ibex-opentitan[ACT config]
| VeeR EL2 | https://github.com/chipsalliance/Cores-VeeR-EL2/tree/925f3a34bdadc8f28b12a70cfb73e043b0f5ef3d[Cores-VeeR-EL2 925f3a3] | https://github.com/riscv/riscv-arch-test/tree/cbbb9f0eb59beb5588e9158a7c13aace48231c51/config/cores/veer-el2/veer-el2-rv32imcb-u-pmp[ACT config]
| OpenE906 | https://github.com/T-head-Semi/opene906/tree/c5b878958e73e0b8f324a8132943f184a7831c07[opene906 c5b8789] | https://github.com/riscv/riscv-arch-test/pull/3107[riscv-arch-test#3107]
| VexRiscv | https://github.com/litex-hub/pythondata-cpu-vexriscv/tree/642ecfed1c84460555d6d803d660cc60cfc1ecb6[pythondata-cpu-vexriscv 642ecfe] | https://github.com/riscv/riscv-arch-test/pull/3108[riscv-arch-test#3108]
| CVA6 cv32a65x | https://github.com/openhwfoundation/cva6/tree/81245a47fad8fe1a5d562d953ef2662e099def76[cva6 81245a4] | https://github.com/riscv/riscv-arch-test/tree/cbbb9f0eb59beb5588e9158a7c13aace48231c51/config/cores/cva6/cv32a65x[ACT config]
| VeeR EH1 | https://github.com/chipsalliance/Cores-VeeR-EH1/tree/d04b1c7ae675a63dc4307cacfd10547ec937b928[Cores-VeeR-EH1 d04b1c7] | https://github.com/riscv/riscv-arch-test/tree/cbbb9f0eb59beb5588e9158a7c13aace48231c51/config/cores/veer-eh1/veer-eh1-rv32imc[ACT config]
| VeeR EH2 | https://github.com/chipsalliance/Cores-VeeR-EH2/tree/a7203d02d4774c9b8aa08b4827ec300d2c80a388[Cores-VeeR-EH2 a7203d0] | https://github.com/riscv/riscv-arch-test/tree/cbbb9f0eb59beb5588e9158a7c13aace48231c51/config/cores/veer-eh2/veer-eh2-rv32imacb[ACT config]
| CV32E20 | https://github.com/MikeOpenHWGroup/cve2/tree/094e9742648f3f527c6f47d047e625600653a9aa[cve2 094e974] | https://github.com/riscv/riscv-arch-test/tree/cbbb9f0eb59beb5588e9158a7c13aace48231c51/config/cores/cve2/cv32e20[ACT config]
| OpenE902 | https://github.com/T-head-Semi/opene902/tree/991836411b405ac6a0a8d7668f2f5de6fa2a5b8c[opene902 9918364] | https://github.com/riscv/riscv-arch-test/pull/3106[riscv-arch-test#3106]
| Shakti E-class | https://gitlab.com/shaktiproject/cores/e-class/-/tree/e8a0dfd2d1c4907c74fb58432e379016871fdd3a[e-class e8a0dfd] | https://github.com/riscv/riscv-arch-test/pull/3110[riscv-arch-test#3110]
| Hazard3 | https://github.com/Wren6991/Hazard3/tree/ba0c83c657a21f2e9946cf02cbc6c8d3d9a7dab6[Hazard3 ba0c83c] | https://github.com/riscv/riscv-arch-test/tree/cbbb9f0eb59beb5588e9158a7c13aace48231c51/config/cores/hazard3/hazard3-rv32imacb-u-pmp[ACT config]
| CV32E40P RV32IMC | https://github.com/openhwgroup/cv32e40p/tree/360d272898d81806be3377193870dbf83a3ea79f[cv32e40p 360d272] | https://github.com/riscv/riscv-arch-test/tree/cbbb9f0eb59beb5588e9158a7c13aace48231c51/config/cores/cve4/cv32e40p-v2-rv32imc[ACT config]
| CV32E40P RV32IMCF | https://github.com/openhwgroup/cv32e40p/tree/360d272898d81806be3377193870dbf83a3ea79f[cv32e40p 360d272] | https://github.com/riscv/riscv-arch-test/tree/cbbb9f0eb59beb5588e9158a7c13aace48231c51/config/cores/cve4/cv32e40p-v2-rv32imcf[ACT config]
| CV32E40S RV32IMC | https://github.com/openhwfoundation/cv32e40s/tree/9d9cae78b01a11458953133d1173c61933a2ba86[cv32e40s 9d9cae7] | https://github.com/riscv/riscv-arch-test/pull/3166[riscv-arch-test#3166]
| CV32E40S RV32IMCB | https://github.com/openhwfoundation/cv32e40s/tree/9d9cae78b01a11458953133d1173c61933a2ba86[cv32e40s 9d9cae7] | https://github.com/riscv/riscv-arch-test/pull/3166[riscv-arch-test#3166]
| CV32E40X | https://github.com/openhwgroup/cv32e40x/tree/d952cd63bc1b4eb58cd893c28ef8283c781e345e[cv32e40x d952cd6] | https://github.com/riscv/riscv-arch-test/tree/cbbb9f0eb59beb5588e9158a7c13aace48231c51/config/cores/cve4/cv32e40x-rv32imc[ACT config]
| PicoRV32 | https://github.com/YosysHQ/picorv32/tree/ef203c2b0a3fb793280f5114941416c425c5b461[picorv32 ef203c2] | https://github.com/riscv/riscv-arch-test/tree/cbbb9f0eb59beb5588e9158a7c13aace48231c51/config/cores/picorv32/picorv32-rv32imc[ACT config]
| SERV | https://github.com/olofk/serv/tree/f200eb2ed7b69ac1c6b8eddd47654522aeee5ce8[serv f200eb2] | https://github.com/riscv/riscv-arch-test/tree/cbbb9f0eb59beb5588e9158a7c13aace48231c51/config/cores/serv/serv-rv32imc[ACT config]
|===
