antoniofloresgil/cvw/hardware/board/chip_qfn32_socket.png

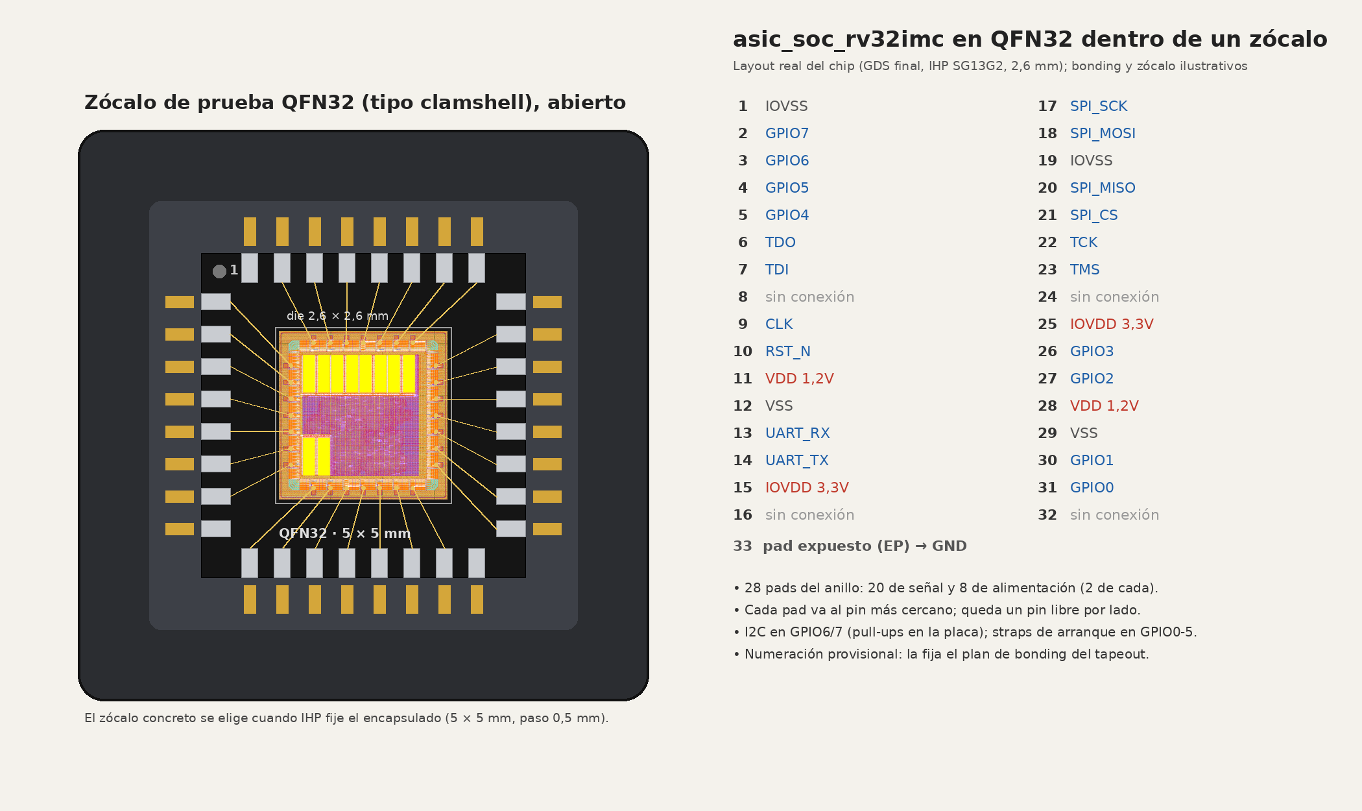
hardware/board/chip_qfn32_socket.png
