antoniofloresgil/cvw/hardware/board/mcu_board_bottom.png

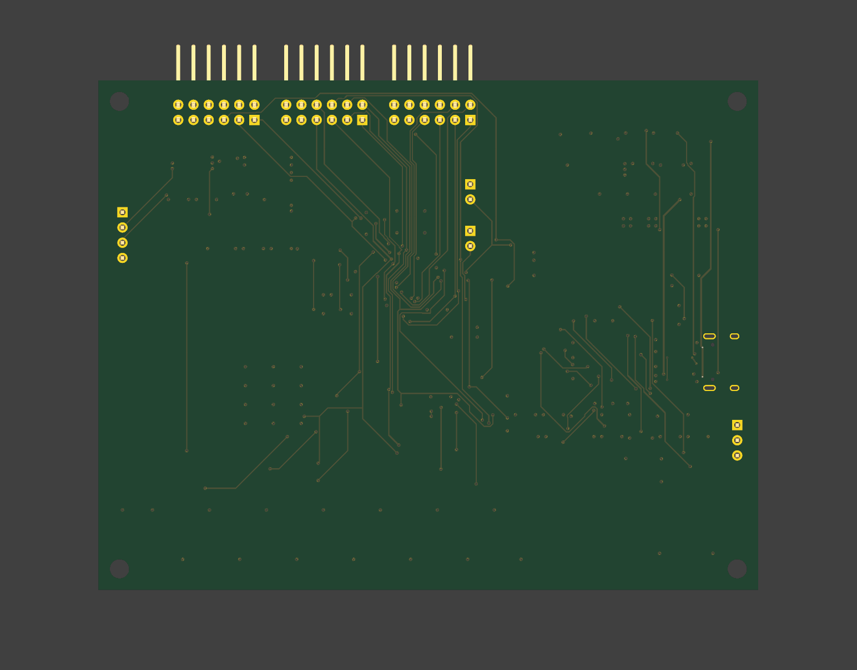
hardware/board/mcu_board_bottom.png
