antoniofloresgil/cvw/hardware/board/mcu_board_socket_bottom.png

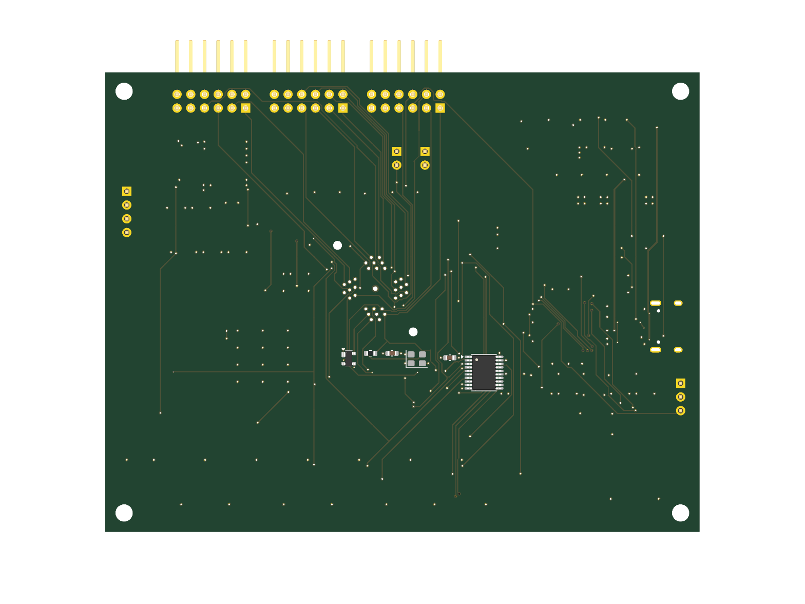
hardware/board/mcu_board_socket_bottom.png
