antoniofloresgil/cvw/hardware/board/mcu_board_socket_top.png

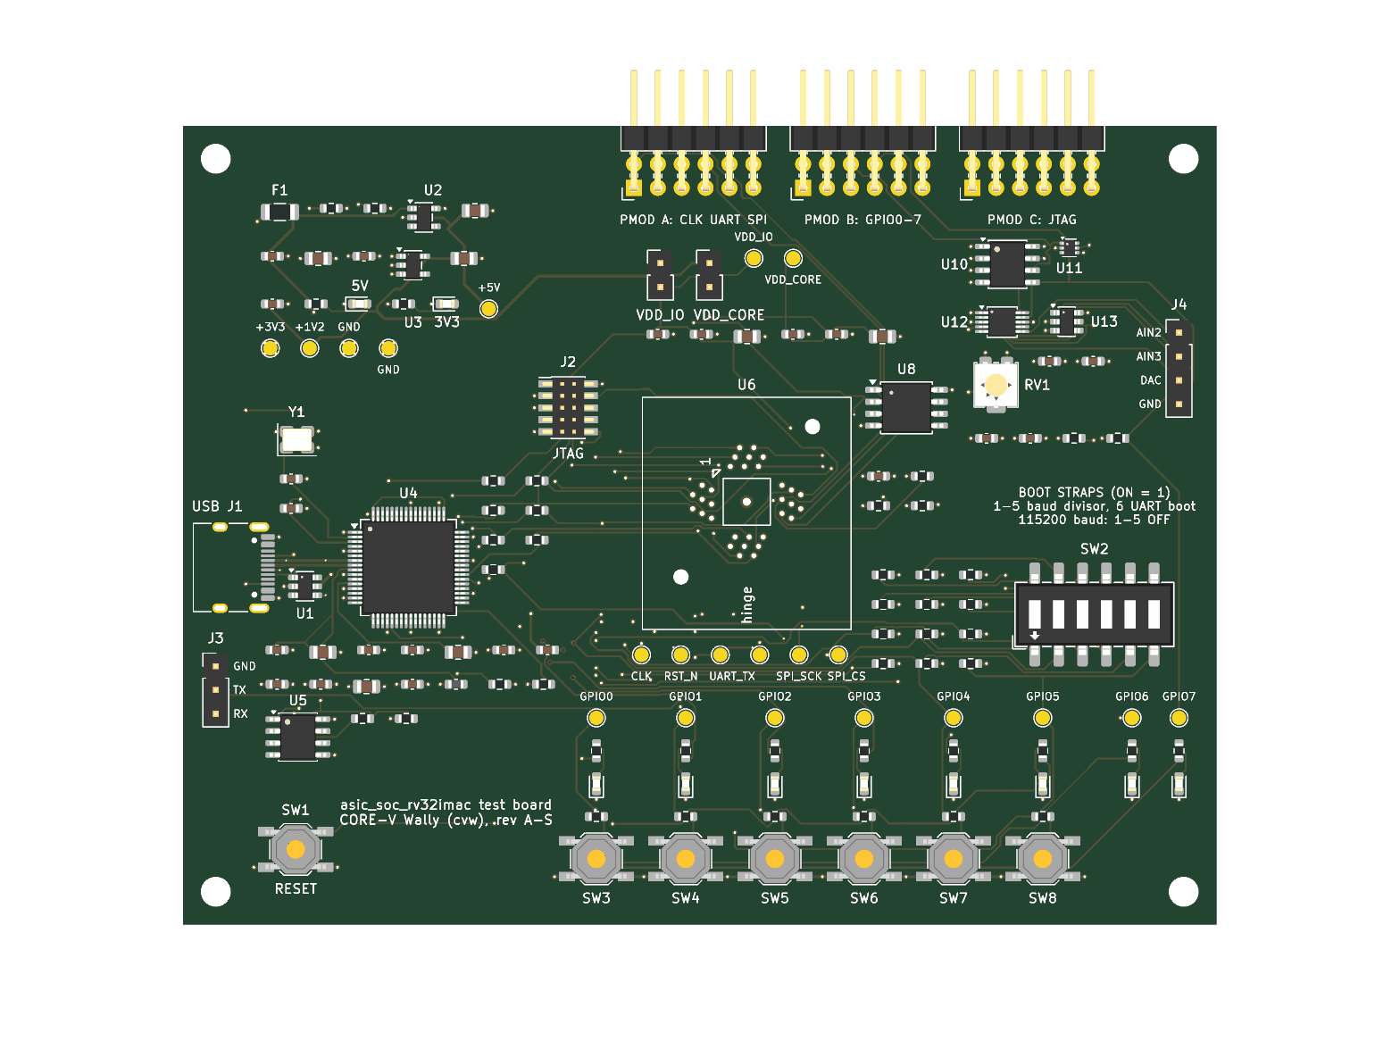
hardware/board/mcu_board_socket_top.png
