antoniofloresgil/cvw/hardware/board/mcu_board_top.png

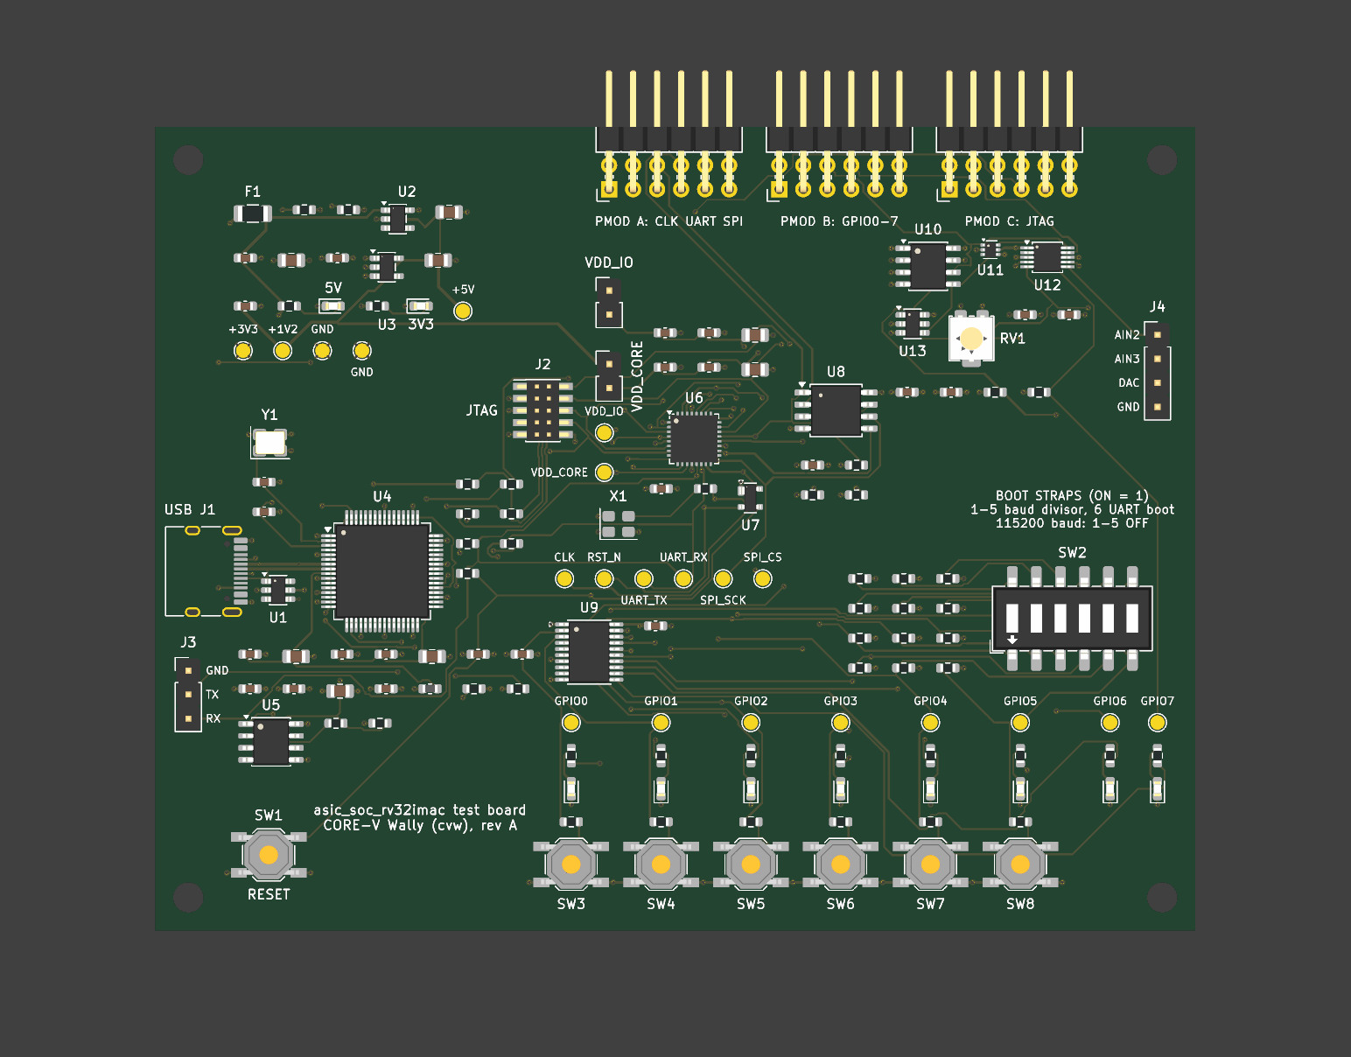
hardware/board/mcu_board_top.png
