antoniofloresgil/cvw/hardware/board/socket_footprint.png

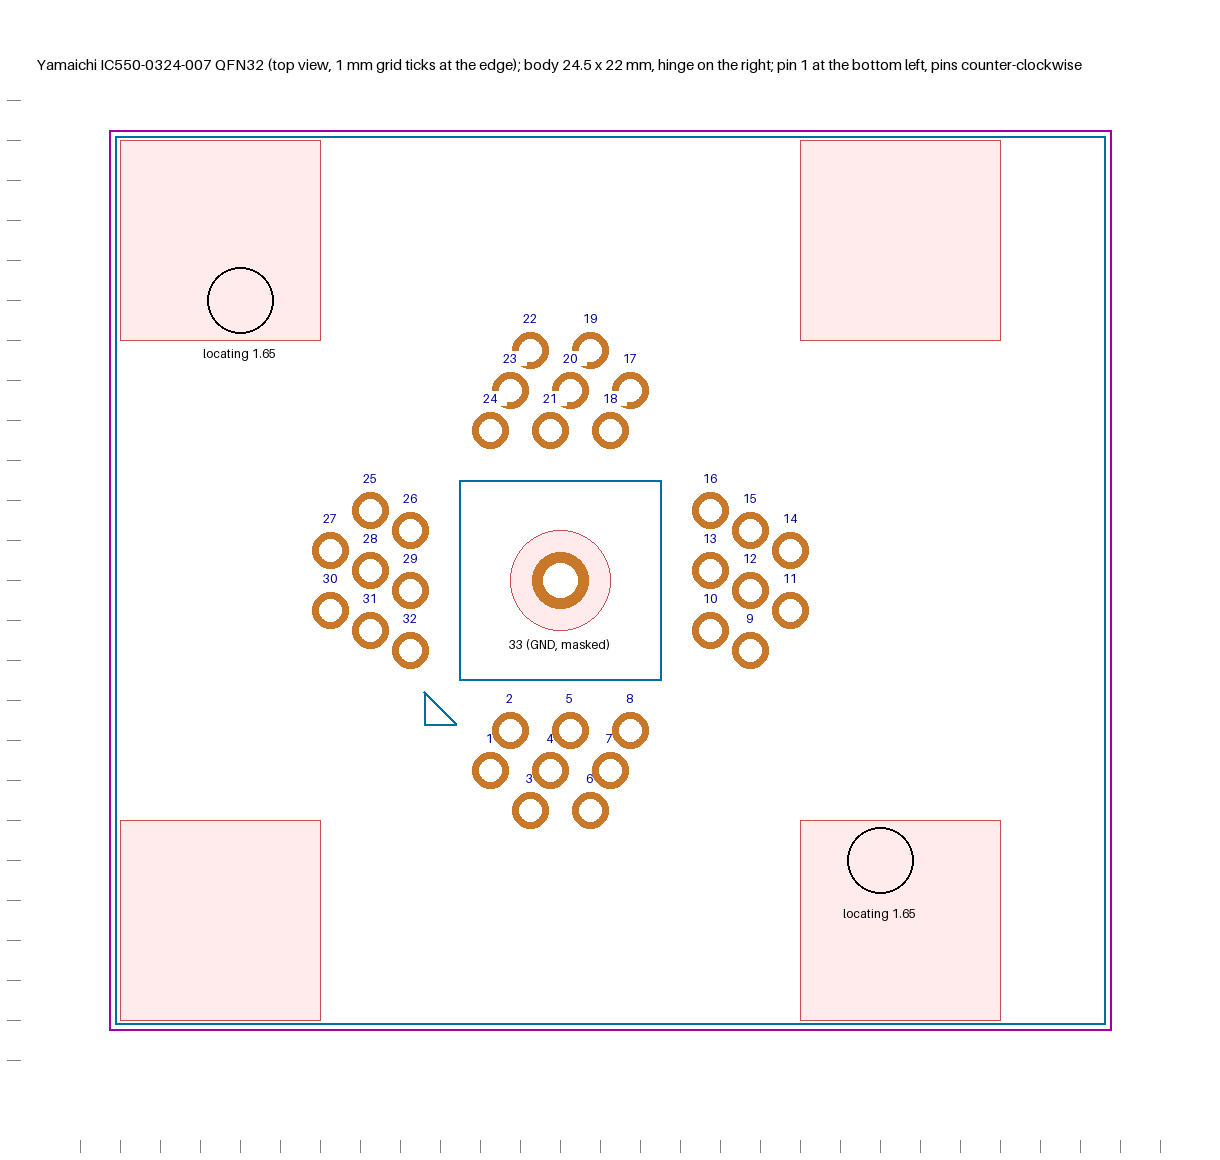
hardware/board/socket_footprint.png
