antoniofloresgil/cvw/docs/engineering/experiments/2026-10-21-sscofpmf.md

# Sscofpmf RTL and CSR verification (2026-10-21)

## Question and source

Does optional `SSCOFPMF_SUPPORTED` implement HPM overflow, privilege filtering
and the local interrupt without changing base configurations? Tested the
working tree on `adding-mpu-support` above `92c007ae5`, with the
`sscofpmf_rv32gc` and `sscofpmf_rv64gc` derivatives and base rv32gc/rv64gc,
rv32i/rv64i. Generated configs came from `make deriv`. Results must be
rechecked against any later committed revision.

## Procedure and observations

After `source ./setup.sh`:

```bash
make deriv
python3 tests/pmu/run.py --work /tmp/sscofpmf-pmu
```

Directed RTL checks: **PASS**, 14 Verilator cases (RV32/RV64; six original
counter cases, four Sscofpmf-on counter cases and four on/off interrupt
cases). The same run verified generated OpenSBI PMU mappings and all eight
board DTBs. Evidence: `/tmp/sscofpmf-pmu/results.json`, per-case build/run
logs, SHA-256 of `results.json`
`cbf65a7507fd688161cb0211fea3afbc394fddbc0ba53966f4483fd9aabaf24e`.

Verilator `5.022` RTL lint with `-Wall` and the repository lint exclusions:
**PASS** for both Sscofpmf derivatives, six base configurations and
`fdqh_rv64gc` (nine configurations).
Logs: `/tmp/sscofpmf-lint-<config>.log`. The installed `lint-wally` wrapper
uses `--quiet`, unsupported by this host's Verilator, so the equivalent direct
lint command omitted only that option. `source ./setup.sh` selected the
Verilator under `/opt/riscv`.

Full-core `hpmcounters.elf` on `sscofpmf_rv64gc`: **PASS**,
`SUCCESS! All tests ran without failures.` Run command:

```bash
python3 bin/wsim sscofpmf_rv64gc /tmp/wally-pmu-upstream-20261021-coverage/hpmcounters.elf --sim verilator
```

Evidence: `/tmp/sscofpmf-wsim-run.log` (SHA-256
`48f5af9c6cd22c0b9cf1b09cbf7b2a7a725f8315581db963cf00447aaeefdc0c`),
generated model `sim/verilator/wkdir/sscofpmf_rv64gc_testbench/Vtestbench`
(SHA-256 `2e99b5e7709919ac5b14eb49dd0e64aedf2a8b9f805f54566db3932fce2a5b6c`).
The development Verilator runtime lacks `VL_SYSTEM_IN(std::string)` used by
generated testbench C++; the same compatibility wrapper as in the earlier PMU
integration was added only to the generated PCH under `sim/verilator/wkdir/`
and the model was rebuilt. The RTL and testbench sources were not changed for
that workaround. The source ELF was assembled for the earlier PMU integration
and is outside the repository's tracked files.

## Limits

Directed tests establish RTL CSR/event behavior, not Linux sampling, board
timing or physical FPGA behavior. The pre-M-stage event attribution caveat is
described in [ADR 0014](../decisions/0014-sscofpmf-counter-overflow.md).
Existing board DTBs do not advertise Sscofpmf because their base configs keep
it disabled. An enabled SoC needs matching firmware and OS description before
testing `perf record` or mode-filtered `perf stat` end to end.
