antoniofloresgil/cvw/docs/engineering/experiments/2026-10-20-sbi-pmu.md

# SBI PMU / perf stat integration

Date: 2026-10-20. Branch: `riscv-pmu-counters`, base
`82d0b80f7d1471f224fc5a8fc307d75f5eb26f53` plus working-tree changes.
Question: can the synthesizable fixed-function counters be exposed accurately
to OpenSBI generic firmware and Linux perf stat? Scope and event definitions:
[ADR 0013](../decisions/0013-sbi-pmu-perf-stat.md).

Focused work/evidence: `/tmp/wally-pmu-20261020/`. Permanent raw evidence will
be archived under ignored `sim/verilator/wkdir/pmu/verification-20261020/`.
Unit tests, commands and Linux reproduction are described in
[linux/pmu](../../../linux/pmu/README.md). Tools: setup-selected `/opt/riscv`,
Verilator 5.022 devel (`v5.020-157-g2b4852048`), Linux 6.19.14 and OpenSBI 1.7
sources, Buildroot GCC 15.2.0 Linux toolchain. Sources/build products for the
Linux probe are isolated from existing multicore simulations.

## Observations

- **PASS:** six counter CSR/event unit configurations, RV32/RV64 and
  COUNTERS=3/8/32: fixed events, no double count for returns, invalid retirement,
  zero selectors, inhibition, S/U permissions and rollover/high halves.
- **PASS:** all seven board DTS compile with the generated PMU include; generator
  keeps standard event/counter bounds consistent for reduced counts.
- **PASS:** eight lint configurations, including the dedicated PMU Linux config.
  Host-unsupported `--quiet` is omitted; existing lint exclusions remain.
- **PASS:** full-core hpmcounters coverage, including the two new event sources.
  Standard wsim initially hit the installed development Verilator's missing
  runtime helper VL_SYSTEM_IN(std::string). The final native build supplies
  that host system-call wrapper only inside the generated precompiled header.
  A forced-include attempt was rejected by GCC's PCH rules and was superseded.
  No RTL, test assertions or repository simulator sources are changed by the
  compatibility helper. The host also lacks uv, so bin/elf2hex was invoked
  through Python explicitly. ELF objdump and memfile inputs were generated
  before the passing wsim run. Exact helper/commands/logs are archived.
- **PASS:** actual static RISC-V perf, Linux and OpenSBI images built. Native
  PMU model built from the matching source fingerprint. Checkpoint comparison
  (continuous 100k versus 50k+restore to 100k) is byte-identical.
- **INCOMPLETE/running:** full Linux PMU integration, under its own supervisor.
  No native Linux PMU PASS or FPGA hardware verdict is claimed yet.

The test harness requires a fresh executable/source fingerprint and image
hashes, prevents concurrent work-directory reuse and rejects incompatible
checkpoints. Expected end marker: WALLY_PMU_PASS perf_event_open_and_perf_stat.
No QEMU result is used as proof of Wally's fixed-event semantics. No Sscofpmf,
filtering, overflow sampling, FPGA synthesis or board test is included.

## Native Linux run

Supervisor: `/tmp/wally-pmu-20261020/supervisor.py`, PID 57465.
Status: `/tmp/wally-pmu-20261020/supervisor-status.json`. Model SHA-256:
`e379008b4082333def569f05fbeba94974590416b7b2a83b90c85c8aaab91071`. Frozen sources:
`/tmp/wally-pmu-20261020/frozen-source/`. Images, model metadata, log and
checkpoint: `/tmp/wally-pmu-20261020/linux/`. The model is one native-cache
hart with 32 counter slots and 128 MiB RAM, config pmu_linux. The full run
resumes the validated 100k checkpoint, saves every 5M cycles and has a 1.5B
limit. Its supervisor verifies software hashes, frozen source/model identity,
all seven counter reports, the real perf-stat output and the final marker.
It archives raw results and does not commit or push. Earlier multicore/Linux
models do not validate this model. The native run remains incomplete until
its own final verdict is recorded.

## Final native Linux verdict

**PASS at 121,617,639 cycles** on the frozen native single-core model.
The seven perf_event_open counters and disabled-value checks passed, followed
by the actual perf stat executable. Model SHA-256:
`e379008b4082333def569f05fbeba94974590416b7b2a83b90c85c8aaab91071`. Final log SHA-256:
`f5d058c755d1d44afac5fe80cb502d6b688ae868d18cd50172179aed37b83268`. Raw evidence is archived under the verification path
above. This supersedes the earlier running snapshot; no FPGA test is implied.
