antoniofloresgil/cvw/docs/engineering/experiments/2026-10-21-smcntrpmf.md

# Smcntrpmf RTL and mode-transition verification (2026-10-21)

## Question and source

Can Wally count `mcycle` and `minstret` only in a selected privilege mode
while preserving the base PMU behavior? Working tree on `adding-mpu-support`
above `f1a5b7744`; target configurations generated by `make deriv`:
`smcntrpmf_rv32gc`, `smcntrpmf_rv64gc`, `pmf_rv32gc` and `pmf_rv64gc`.
Results require rechecking against any later committed revision.

## Procedure and observations

After `source ./setup.sh`:

```bash
make deriv
python3 tests/pmu/run.py --work /tmp/smcntrpmf-pmu
```

The directed suite: **PASS**, 18 Verilator cases. It covers RV32/RV64 CSR permissions, reserved-field masks,
independent cycle/instret filtering, interaction with `mcountinhibit`, the
extension-disabled case, and coexistence with Sscofpmf. It also checks the
existing PMU map and board DTBs. The RTL lint elaborates the four new
derivatives and representative base configurations with the repository's
`-Wall` exclusions: **PASS** in the four new derivatives, two Sscofpmf
derivatives, six base configurations and `fdqh_rv64gc` (13 elaborations).
Logs are under `/tmp/smcntrpmf-pmu/` and
`/tmp/smcntrpmf-lint-<config>.log`; SHA-256 of `results.json` is
`f6a72ed9e2b116d62731be4175a5a123df3b3b38147f9dd9fa216c54d08e4ffb`.

A separate RV64 full-core program, `tests/pmu/smcntrpmf.S`, enters U-mode,
reads the unprivileged counter aliases, executes user instructions, takes an
ecall into the machine handler and returns to M-mode. It checks that the
fixed counters advanced in U-mode and remain constant during M-mode work.
The program is assembled into `/tmp/smcntrpmf-fullcore/smcntrpmf.elf` and
run on `pmf_rv64gc` through `wsim --sim verilator`: **PASS**,
`SUCCESS! All tests ran without failures.` The reproducible command sequence
uses `riscv64-unknown-elf-gcc -E -I tests/coverage`,
`riscv64-unknown-elf-as`, and `riscv64-unknown-elf-gcc -nostartfiles
-T examples/link/link.ld`, followed by:

```bash
python3 bin/elf2hex /tmp/smcntrpmf-fullcore/smcntrpmf.elf /tmp/smcntrpmf-fullcore/smcntrpmf.elf.memfile
bash bin/extractFunctionRadix.sh /tmp/smcntrpmf-fullcore/smcntrpmf.elf
python3 bin/wsim pmf_rv64gc /tmp/smcntrpmf-fullcore/smcntrpmf.elf --sim verilator
```

Evidence: `/tmp/smcntrpmf-fullcore/wsim-run-final.log` (SHA-256
`2859dc41c96c7c4561c6abca35884b012a0b6c1165ec613a54806d956f788415`),
ELF SHA-256 `269c9cda003e857efe19466d114550502283e530f9194cf76ecabfc3e3f054fc`,
model SHA-256 `0a79616ab518991c3484734a520cfc22b55b0df1f0e45889e15404964b6f9139`.
This host lacks `uv` for the `elf2hex` shebang, so the same script was run
through `python3`. Its development Verilator also lacks
`VL_SYSTEM_IN(std::string)`; the compatibility wrapper was added only to the
generated PCH under `sim/verilator/wkdir/` before rebuilding the model.
Neither workaround changed versioned RTL or testbench sources.

The existing `hpmcounters.elf` regression on the same combined
`pmf_rv64gc` model also **PASS**. Evidence:
`/tmp/smcntrpmf-fullcore/hpm-regression.log`, SHA-256
`ac2af1ce0ac0bcdfad191fd404f7f31bfca3e5913b41d96addacead53996258b`.
This checks that the new fixed-counter filters coexist with the existing HPM
event tests when their reset-default filters are clear.

## Limits

The directed tests are RTL simulation, not a Linux, board or synthesized FPGA
result. Cycle attribution at the exact trap/return edge is implementation
defined by the standard. `perf stat -e cycles:u,instructions:u` under Linux
requires a matching firmware/device tree and has not been exercised by this
record.
