antoniofloresgil/cvw/docs/engineering/experiments/2026-10-20-mesi.md

# Optional MESI validation

Latest native Linux verdict: **PASS at 388,367,974 cycles**.
This final result supersedes the earlier running/incomplete snapshot below.
Model SHA-256: `2e4b7a5c2be679753729dad4841d4dc117ecd4e5ea557113f4acc801d33fe376`.
Log SHA-256: `619c634aed64d8960c3b71a83b5ef168081a69f0a720a8c397303aee1ee70cd9`.
Both CPUs online, shared counters 128/128; evidence: `/tmp/wally-linux-mesi-20261020`.

Date: 2026-10-20. Branch: `multicore-support`, published base
`b72f8852188560c181b8f1bc06e552d497ccf371` plus uncommitted burst and MESI work.
Question: can clean-exclusive D permission avoid first-write arbitration
while preserving data sharing, instructions, atomics and failed-fill recovery?
See [ADR 0011](../decisions/0011-optional-mesi-exclusive-state.md).

## Reproduction and evidence

Source `./setup.sh`. Focused native-Linux work directory:
`/tmp/wally-mesi-20261020/`. Helpers `checks.py`, `soc.py`, `lint.py`,
`negative.py`, `software.py` record commands, source hashes and per-case logs.
Final focused evidence is archived under ignored
`sim/verilator/wkdir/multicore/verification-mesi-20261020/`, including source
copies, input hashes, commands, logs, binary hashes and a working-tree patch.
Raw logs and executables are not permanent documentation.

A repository-supported controller run is:

```bash
python3 tests/multicore/run.py --private-dcache --mesi --private-icache \
    --local-dcache-reads --local-dcache-writes --cache-to-cache \
    --cache-bursts --coherence-banks 2 --cache-line-words 4 \
    --icache-line-words 4 --cache-words 32 --icache-words 32 \
    --latency 0 3 --unit-only --work-dir /tmp/wally-mesi-example
```

The controller fixtures share `tests/multicore/mesi_checks.vh`: exclusive
allocation, first byte-store with measured coherence-request count, M-to-S
writeback, E-to-S sharing, shared upgrade, remote E invalidation, clean
replacement, instruction invalidation after E-to-M, LR/SC, simultaneous
readers and failed peer fill/retry. Existing randomized reference, multiword,
error/reset and AMO checks remain enabled. MSI-disabled controls run the same
fixture with their original permission expectations.

Tools: Verilator 5.022 devel (`v5.020-157-g2b4852048`) and the setup-selected
`/opt/riscv` toolchain. Lint removes only the host-unsupported `--quiet`
option; the repository's existing warning exclusions remain unchanged.
Single-core XML elaboration checks require all coherence modules to disappear.

## Observed verdict and limits

Focused verification **PASS**:

- Nine controller configurations, RV32/RV64, 2/3/4 harts, 1/2/4 homes,
  latency 0/3, D lines 1/4/8 words, unequal I/D geometry, bursts and
  cache-to-cache on/off, local paths on/off. Seven MESI and two MSI controls
  run directed checks and 2,000 random reference operations each: 18,000 total.
- Six full-core models run atomic, smoke, UART and the new `exclusive` suite:
  24 executions. Cases include MESI with one/two/four homes, local writes
  disabled, bursts disabled, an MSI control and single-core bypass.
- Fifteen lint/structural checks: seven ordinary configurations, five MESI
  variants, Linux wrapper and two single-core XML configurations. Neither
  single-core elaboration retains coherence modules.
- Two negative controls fail as required: granting E with a peer violates
  shared ownership; rejecting local E stores violates the measured request
  count. The fixtures remain outside tracked sources.
- Nine DTS comparisons preserve geometry and bytes; invalid topology and
  both directions of explicit manifest/protocol mismatch are rejected.
  Scoped pre-commit hooks and `git diff --check` pass.

All full-core cases use RV64, 2 KiB private I/D banks per hart and 32-byte
I/D lines. Matched two-hart/two-home, latency-three, burst/forwarding/local-path
measurements:

| Program | MSI cycles | MESI cycles |
| --- | ---: | ---: |
| Atomic | 17,839 | 17,839 |
| Smoke | 2,375 | 2,375 |
| UART | 7,785 | 7,785 |
| Exclusive first writes | 3,870 | 3,739 |

`exclusive.S` reads then writes 32 initially clean private lines per hart and
checks every initial/read-after-write value. Independent pages avoid data
sharing during its loop. It improves by 3.39%; the other three programs do
not improve. The directed fixture separately confirms that E-to-M uses zero
additional coherence requests with local writes enabled, while MSI S-to-M
requires one. This is workload-specific simulation evidence, not a universal
speedup or FPGA frequency result. Select it with `--suite exclusive`.
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
