antoniofloresgil/cvw/hardware/board/mcu_board.kicad_pcb

## KiCad design hardware/board/mcu_board.kicad_pcb (2026-11-08)

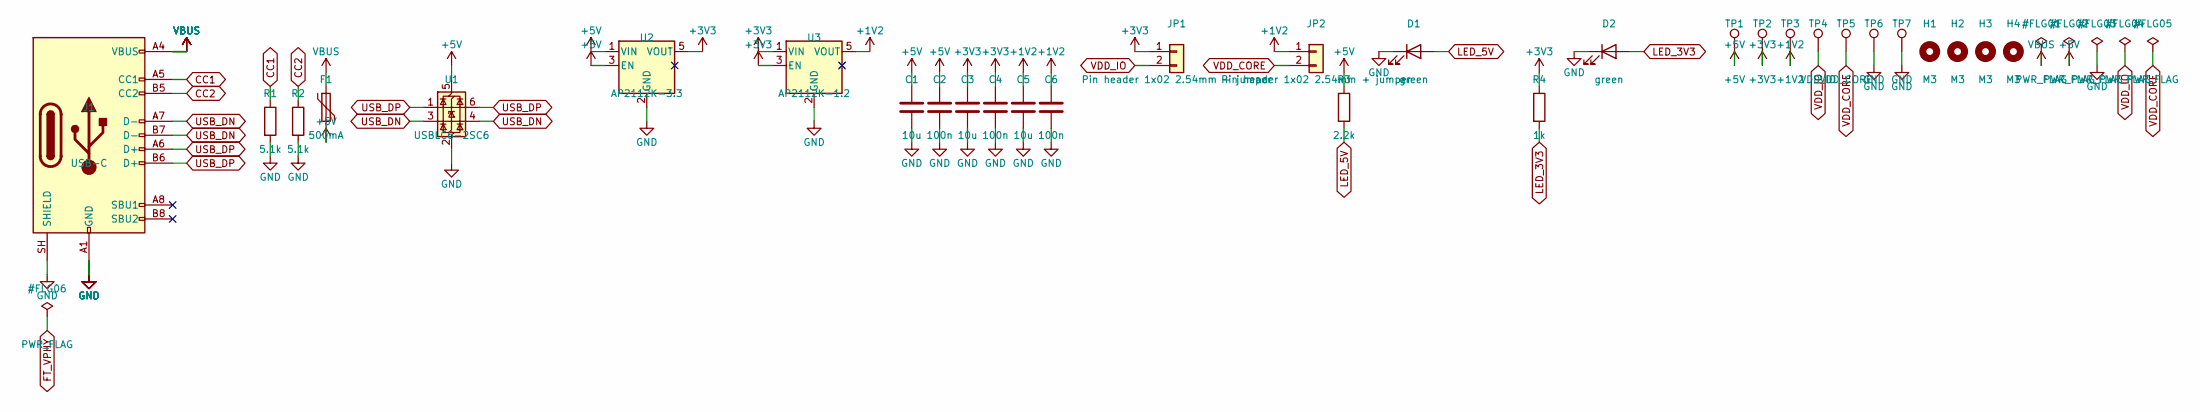
[picture p7: schematic power.kicad_sch, Power: USB-C, 3.3 V and 1.2 V]

Parts:
C1, C3, C5: 10u; C_0805_2012Metric
C2, C4, C6: 100n; C_0603_1608Metric
D1, D2: green; LED_0603_1608Metric
F1: 500mA; Fuse_1206_3216Metric
H1, H2, H3, H4: M3; MountingHole_3.2mm_M3
J1: USB-C; USB_C_Receptacle_HRO_TYPE-C-31-M-12
JP1, JP2: Pin header 1x02 2.54mm + jumper; PinHeader_1x02_P2.54mm_Vertical
R1, R2: 5.1k; R_0603_1608Metric
R3: 2.2k; R_0603_1608Metric
R4: 1k; R_0603_1608Metric
TP1: +5V; TestPoint_Pad_D1.5mm
TP2: +3V3; TestPoint_Pad_D1.5mm
TP3: +1V2; TestPoint_Pad_D1.5mm
TP4: VDD_IO; TestPoint_Pad_D1.5mm
TP5: VDD_CORE; TestPoint_Pad_D1.5mm
TP6, TP7: GND; TestPoint_Pad_D1.5mm
U1: USBLC6-2SC6; SOT-23-6
U2: AP2112K-3.3; SOT-23-5
U3: AP2112K-1.2; SOT-23-5

Connections:
+1V2: C5.1, C6.1, JP2.1, TP3.1, U3.5 (VOUT)
+3V3: C3.1, C4.1, JP1.1, R4.1, TP2.1, U2.5 (VOUT), U3.1 (VIN), U3.3 (EN); also elsewhere on the board
+5V: C1.1, C2.1, F1.2, R3.1, TP1.1, U1.5 (VBUS), U2.1 (VIN), U2.3 (EN)
CC1: J1.A5 (CC1), R1.1
CC2: J1.B5 (CC2), R2.1
GND: C1.2, C2.2, C3.2, C4.2, C5.2, C6.2, D1.1 (K), D2.1 (K), J1.A1 (GND), J1.A12 (GND), J1.B1 (GND), J1.B12 (GND), J1.SH (SHIELD), R1.2, R2.2, TP6.1, TP7.1, U1.2 (GND), U2.2 (GND), U3.2 (GND); also elsewhere on the board
LED_3V3: D2.2 (A), R4.2
LED_5V: D1.2 (A), R3.2
USB_DN: J1.A7 (D-), J1.B7 (D-), U1.3 (I/O2), U1.4 (I/O2); also elsewhere on the board
USB_DP: J1.A6 (D+), J1.B6 (D+), U1.1 (I/O1), U1.6 (I/O1); also elsewhere on the board
VBUS: F1.1, J1.A4 (VBUS), J1.A9 (VBUS), J1.B4 (VBUS), J1.B9 (VBUS)
VDD_CORE: JP2.2, TP5.1; also elsewhere on the board
VDD_IO: JP1.2, TP4.1; also elsewhere on the board

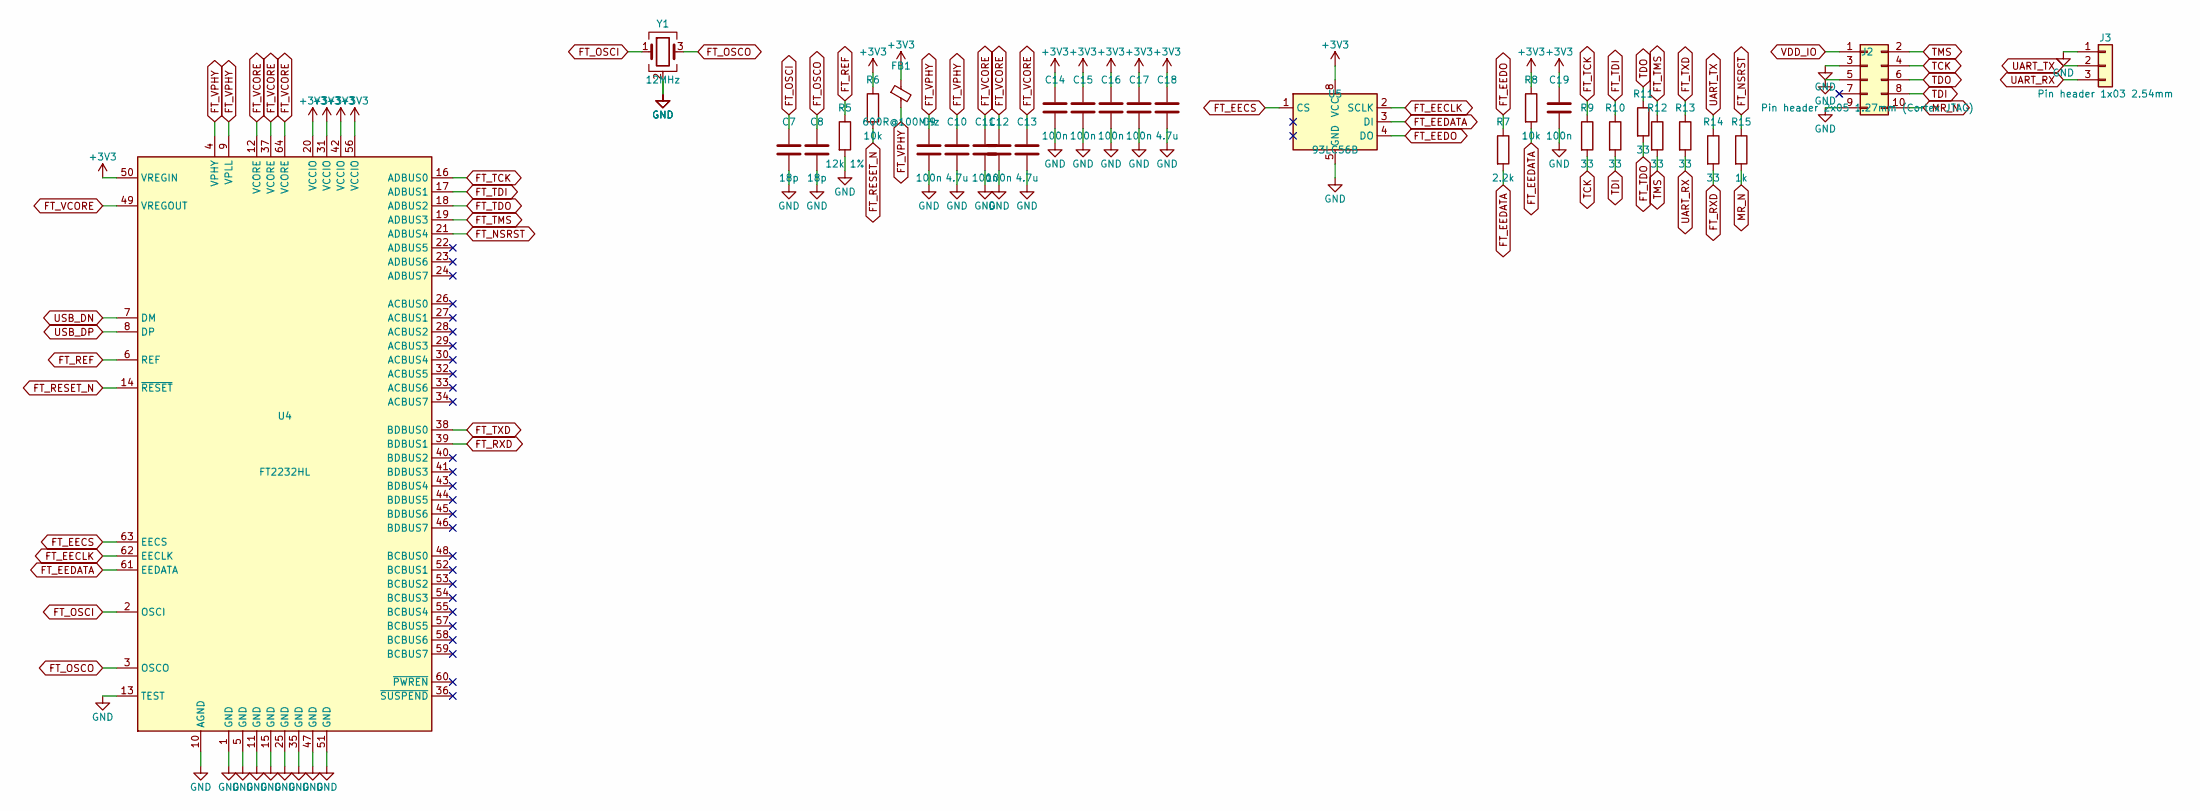
[picture p8: schematic debug.kicad_sch, USB: FT2232HL JTAG and UART]

Parts:
C7, C8: 18p; C_0603_1608Metric
C9, C11, C12, C14, C15, C16, C17, C19: 100n; C_0603_1608Metric
C10, C13, C18: 4.7u; C_0805_2012Metric
FB1: 600R@100MHz; L_0603_1608Metric
J2: Pin header 2x05 1.27mm (Cortex JTAG); PinHeader_2x05_P1.27mm_Vertical_SMD
J3: Pin header 1x03 2.54mm; PinHeader_1x03_P2.54mm_Vertical
R5: 12k 1%; R_0603_1608Metric
R6, R8: 10k; R_0603_1608Metric
R7: 2.2k; R_0603_1608Metric
R9, R10, R11, R12, R13, R14: 33; R_0603_1608Metric
R15: 1k; R_0603_1608Metric
U4: FT2232HL; LQFP-64_10x10mm_P0.5mm
U5: 93LC56B; SOIC-8_3.9x4.9mm_P1.27mm
Y1: 12MHz; Crystal_SMD_3225-4Pin_3.2x2.5mm

Connections:
+3V3: C14.1, C15.1, C16.1, C17.1, C18.1, C19.1, FB1.1, R6.1, R8.1, U4.20 (VCCIO), U4.31 (VCCIO), U4.42 (VCCIO), U4.50 (VREGIN), U4.56 (VCCIO), U5.8 (VCC); also elsewhere on the board
FT_EECLK: U4.62 (EECLK), U5.2 (SCLK)
FT_EECS: U4.63 (EECS), U5.1 (CS)
FT_EEDATA: R7.2, R8.2, U4.61 (EEDATA), U5.3 (DI)
FT_EEDO: R7.1, U5.4 (DO)
FT_NSRST: R15.1, U4.21 (ADBUS4)
FT_OSCI: C7.1, U4.2 (OSCI), Y1.1
FT_OSCO: C8.1, U4.3 (OSCO), Y1.3
FT_REF: R5.1, U4.6 (REF)
FT_RESET_N: R6.2, U4.14 (~RESET)
FT_RXD: R14.2, U4.39 (BDBUS1)
FT_TCK: R9.1, U4.16 (ADBUS0)
FT_TDI: R10.1, U4.17 (ADBUS1)
FT_TDO: R11.2, U4.18 (ADBUS2)
FT_TMS: R12.1, U4.19 (ADBUS3)
FT_TXD: R13.1, U4.38 (BDBUS0)
FT_VCORE: C11.1, C12.1, C13.1, U4.12 (VCORE), U4.37 (VCORE), U4.49 (VREGOUT), U4.64 (VCORE)
FT_VPHY: C9.1, C10.1, FB1.2, U4.4 (VPHY), U4.9 (VPLL)
GND: C7.2, C8.2, C9.2, C10.2, C11.2, C12.2, C13.2, C14.2, C15.2, C16.2, C17.2, C18.2, C19.2, J2.3, J2.5, J2.9, J3.1, R5.2, U4.1 (GND), U4.5 (GND), U4.10 (AGND), U4.11 (GND), U4.13 (TEST), U4.15 (GND), U4.25 (GND), U4.35 (GND), U4.47 (GND), U4.51 (GND), U5.5 (GND), Y1.2 (G), Y1.4 (G); also elsewhere on the board
MR_N: J2.10, R15.2; also elsewhere on the board
TCK: J2.4, R9.2; also elsewhere on the board
TDI: J2.8, R10.2; also elsewhere on the board
TDO: J2.6, R11.1; also elsewhere on the board
TMS: J2.2, R12.2; also elsewhere on the board
UART_RX: J3.3, R13.2; also elsewhere on the board
UART_TX: J3.2, R14.1; also elsewhere on the board
USB_DN: U4.7 (DM); also elsewhere on the board
USB_DP: U4.8 (DP); also elsewhere on the board
VDD_IO: J2.1; also elsewhere on the board

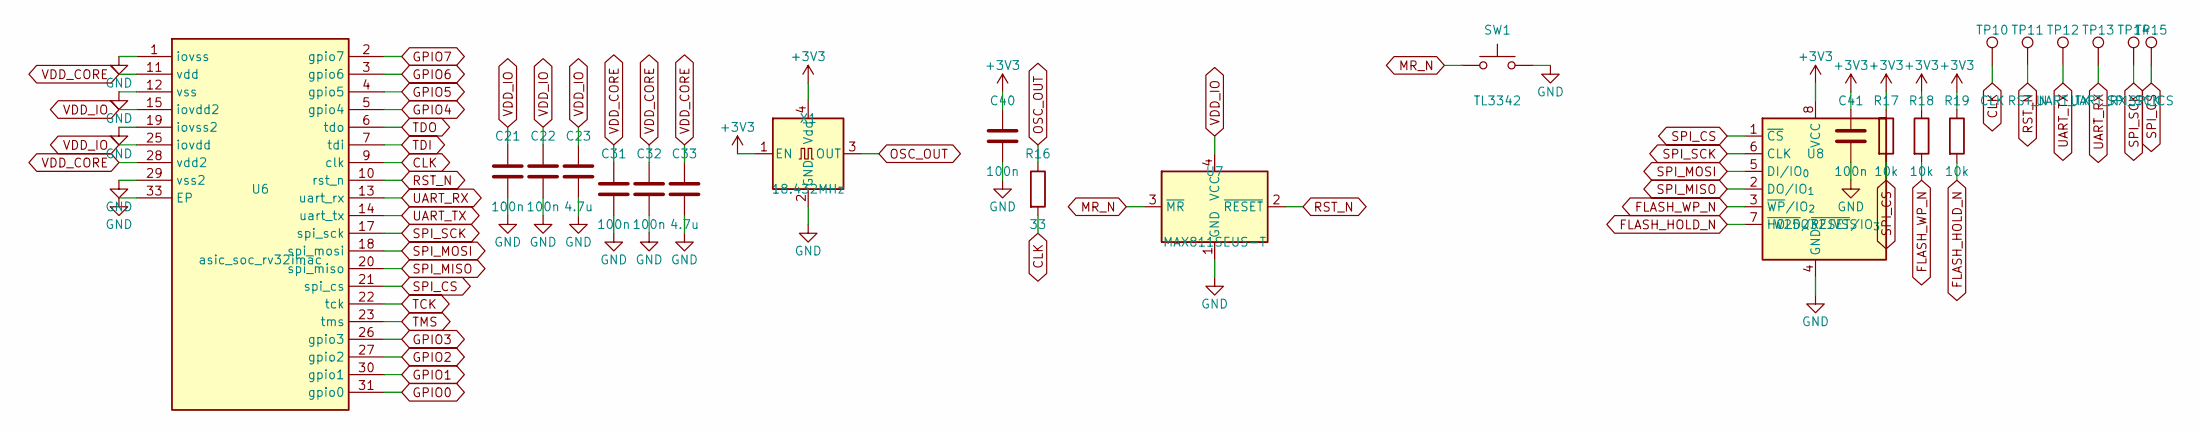
[picture p9: schematic chip.kicad_sch, asic_soc_rv32imac, clock, reset, SPI flash]

Parts:
C21, C22, C31, C32, C40, C41: 100n; C_0603_1608Metric
C23, C33: 4.7u; C_0805_2012Metric
R16: 33; R_0603_1608Metric
R17, R18, R19: 10k; R_0603_1608Metric
SW1: TL3342; SW_SPST_TL3342
TP10: CLK; TestPoint_Pad_D1.5mm
TP11: RST_N; TestPoint_Pad_D1.5mm
TP12: UART_TX; TestPoint_Pad_D1.5mm
TP13: UART_RX; TestPoint_Pad_D1.5mm
TP14: SPI_SCK; TestPoint_Pad_D1.5mm
TP15: SPI_CS; TestPoint_Pad_D1.5mm
U6: asic_soc_rv32imac; QFN-32-1EP_5x5mm_P0.5mm_EP3.3x3.3mm
U7: MAX811SEUS-T; SOT-143
U8: W25Q32JVSS; SOIC-8_5.3x5.3mm_P1.27mm
X1: 18.432MHz; Oscillator_SMD_Abracon_ASE-4Pin_3.2x2.5mm

Connections:
+3V3: C40.1, C41.1, R17.1, R18.1, R19.1, U8.8 (VCC), X1.1 (EN), X1.4 (Vdd); also elsewhere on the board
CLK: R16.2, TP10.1, U6.9 (clk); also elsewhere on the board
FLASH_HOLD_N: R19.2, U8.7 (~HOLD/~RESET/IO_{3})
FLASH_WP_N: R18.2, U8.3 (~WP/IO_{2})
GND: C21.2, C22.2, C23.2, C31.2, C32.2, C33.2, C40.2, C41.2, SW1.2, U6.1 (iovss), U6.12 (vss), U6.19 (iovss2), U6.29 (vss2), U6.33 (EP), U7.1 (GND), U8.4 (GND), X1.2 (GND); also elsewhere on the board
GPIO0: U6.31 (gpio0); also elsewhere on the board
GPIO1: U6.30 (gpio1); also elsewhere on the board
GPIO2: U6.27 (gpio2); also elsewhere on the board
GPIO3: U6.26 (gpio3); also elsewhere on the board
GPIO4: U6.5 (gpio4); also elsewhere on the board
GPIO5: U6.4 (gpio5); also elsewhere on the board
GPIO6: U6.3 (gpio6); also elsewhere on the board
GPIO7: U6.2 (gpio7); also elsewhere on the board
MR_N: SW1.1, U7.3 (~MR); also elsewhere on the board
OSC_OUT: R16.1, X1.3 (OUT)
RST_N: TP11.1, U6.10 (rst_n), U7.2 (~RESET); also elsewhere on the board
SPI_CS: R17.2, TP15.1, U6.21 (spi_cs), U8.1 (~CS); also elsewhere on the board
SPI_MISO: U6.20 (spi_miso), U8.2 (DO/IO_{1}); also elsewhere on the board
SPI_MOSI: U6.18 (spi_mosi), U8.5 (DI/IO_{0}); also elsewhere on the board
SPI_SCK: TP14.1, U6.17 (spi_sck), U8.6 (CLK); also elsewhere on the board
TCK: U6.22 (tck); also elsewhere on the board
TDI: U6.7 (tdi); also elsewhere on the board
TDO: U6.6 (tdo); also elsewhere on the board
TMS: U6.23 (tms); also elsewhere on the board
UART_RX: TP13.1, U6.13 (uart_rx); also elsewhere on the board
UART_TX: TP12.1, U6.14 (uart_tx); also elsewhere on the board
VDD_CORE: C31.1, C32.1, C33.1, U6.11 (vdd), U6.28 (vdd2); also elsewhere on the board
VDD_IO: C21.1, C22.1, C23.1, U6.15 (iovdd2), U6.25 (iovdd), U7.4 (VCC); also elsewhere on the board

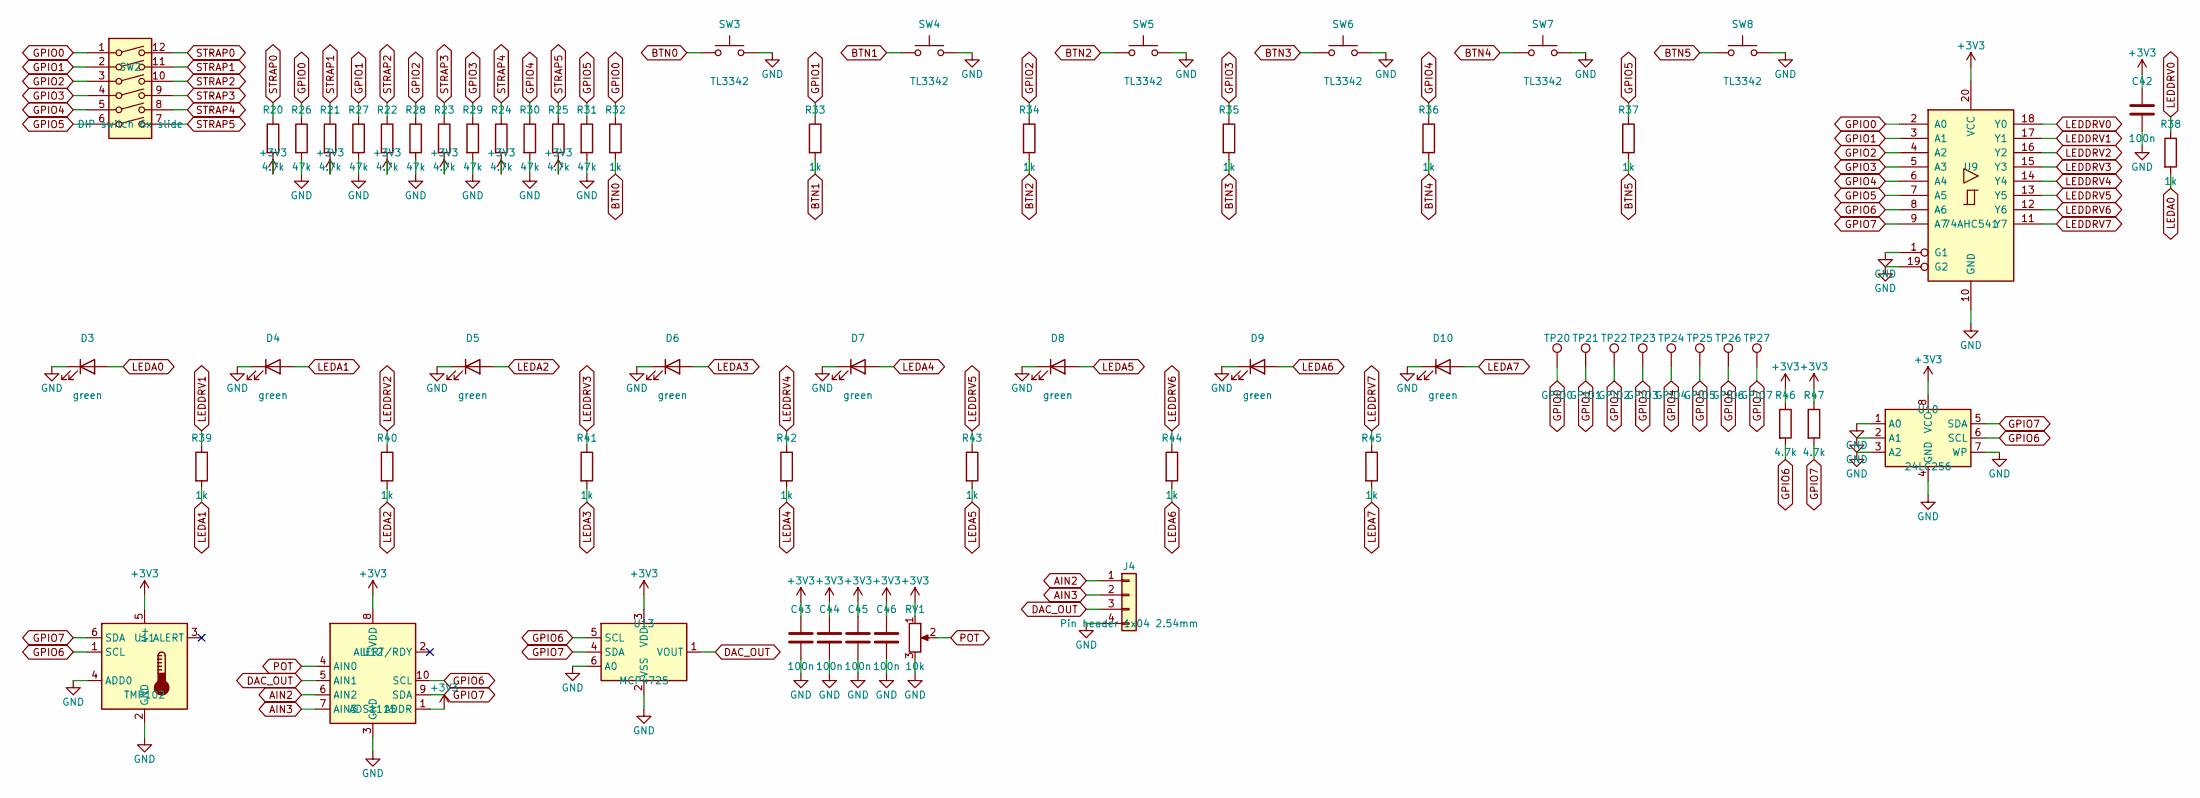
[picture p10: schematic peripherals.kicad_sch, Straps, buttons, LEDs, I2C and analog]

Parts:
C42, C43, C44, C45, C46: 100n; C_0603_1608Metric
D3, D4, D5, D6, D7, D8, D9, D10: green; LED_0603_1608Metric
J4: Pin header 1x04 2.54mm; PinHeader_1x04_P2.54mm_Vertical
R20, R21, R22, R23, R24, R25, R46, R47: 4.7k; R_0603_1608Metric
R26, R27, R28, R29, R30, R31: 47k; R_0603_1608Metric
R32, R33, R34, R35, R36, R37, R38, R39, R40, R41, R42, R43, R44, R45: 1k; R_0603_1608Metric
RV1: 10k; Potentiometer_Bourns_3314J_Vertical
SW2: DIP switch 6x slide; SW_DIP_SPSTx06_Slide_6.7x16.8mm_W8.61mm_P2.54mm_LowProfile
SW3, SW4, SW5, SW6, SW7, SW8: TL3342; SW_SPST_TL3342
TP20: GPIO0; TestPoint_Pad_D1.5mm
TP21: GPIO1; TestPoint_Pad_D1.5mm
TP22: GPIO2; TestPoint_Pad_D1.5mm
TP23: GPIO3; TestPoint_Pad_D1.5mm
TP24: GPIO4; TestPoint_Pad_D1.5mm
TP25: GPIO5; TestPoint_Pad_D1.5mm
TP26: GPIO6; TestPoint_Pad_D1.5mm
TP27: GPIO7; TestPoint_Pad_D1.5mm
U9: 74AHC541; TSSOP-20_4.4x6.5mm_P0.65mm
U10: 24LC256; SOIC-8_3.9x4.9mm_P1.27mm
U11: TMP102; SOT-563
U12: ADS1115; TSSOP-10_3x3mm_P0.5mm
U13: MCP4725; SOT-23-6

Connections:
+3V3: C42.1, C43.1, C44.1, C45.1, C46.1, R20.2, R21.2, R22.2, R23.2, R24.2, R25.2, R46.1, R47.1, RV1.1, U9.20 (VCC), U10.8 (VCC), U11.5 (V+), U12.1 (ADDR), U12.8 (VDD), U13.3 (VDD); also elsewhere on the board
AIN2: J4.1, U12.6 (AIN2)
AIN3: J4.2, U12.7 (AIN3)
BTN0: R32.2, SW3.1
BTN1: R33.2, SW4.1
BTN2: R34.2, SW5.1
BTN3: R35.2, SW6.1
BTN4: R36.2, SW7.1
BTN5: R37.2, SW8.1
DAC_OUT: J4.3, U12.5 (AIN1), U13.1 (VOUT)
GND: C42.2, C43.2, C44.2, C45.2, C46.2, D3.1 (K), D4.1 (K), D5.1 (K), D6.1 (K), D7.1 (K), D8.1 (K), D9.1 (K), D10.1 (K), J4.4, R26.2, R27.2, R28.2, R29.2, R30.2, R31.2, RV1.3, SW3.2, SW4.2, SW5.2, SW6.2, SW7.2, SW8.2, U9.1 (G1), U9.10 (GND), U9.19 (G2), U10.1 (A0), U10.2 (A1), U10.3 (A2), U10.4 (GND), U10.7 (WP), U11.2 (GND), U11.4 (ADD0), U12.3 (GND), U13.2 (VSS), U13.6 (A0); also elsewhere on the board
GPIO0: R26.1, R32.1, SW2.1, TP20.1, U9.2 (A0); also elsewhere on the board
GPIO1: R27.1, R33.1, SW2.2, TP21.1, U9.3 (A1); also elsewhere on the board
GPIO2: R28.1, R34.1, SW2.3, TP22.1, U9.4 (A2); also elsewhere on the board
GPIO3: R29.1, R35.1, SW2.4, TP23.1, U9.5 (A3); also elsewhere on the board
GPIO4: R30.1, R36.1, SW2.5, TP24.1, U9.6 (A4); also elsewhere on the board
GPIO5: R31.1, R37.1, SW2.6, TP25.1, U9.7 (A5); also elsewhere on the board
GPIO6: R46.2, TP26.1, U9.8 (A6), U10.6 (SCL), U11.1 (SCL), U12.10 (SCL), U13.5 (SCL); also elsewhere on the board
GPIO7: R47.2, TP27.1, U9.9 (A7), U10.5 (SDA), U11.6 (SDA), U12.9 (SDA), U13.4 (SDA); also elsewhere on the board
LEDA0: D3.2 (A), R38.2
LEDA1: D4.2 (A), R39.2
LEDA2: D5.2 (A), R40.2
LEDA3: D6.2 (A), R41.2
LEDA4: D7.2 (A), R42.2
LEDA5: D8.2 (A), R43.2
LEDA6: D9.2 (A), R44.2
LEDA7: D10.2 (A), R45.2
LEDDRV0: R38.1, U9.18 (Y0)
LEDDRV1: R39.1, U9.17 (Y1)
LEDDRV2: R40.1, U9.16 (Y2)
LEDDRV3: R41.1, U9.15 (Y3)
LEDDRV4: R42.1, U9.14 (Y4)
LEDDRV5: R43.1, U9.13 (Y5)
LEDDRV6: R44.1, U9.12 (Y6)
LEDDRV7: R45.1, U9.11 (Y7)
POT: RV1.2, U12.4 (AIN0)
STRAP0: R20.1, SW2.12
STRAP1: R21.1, SW2.11
STRAP2: R22.1, SW2.10
STRAP3: R23.1, SW2.9
STRAP4: R24.1, SW2.8
STRAP5: R25.1, SW2.7

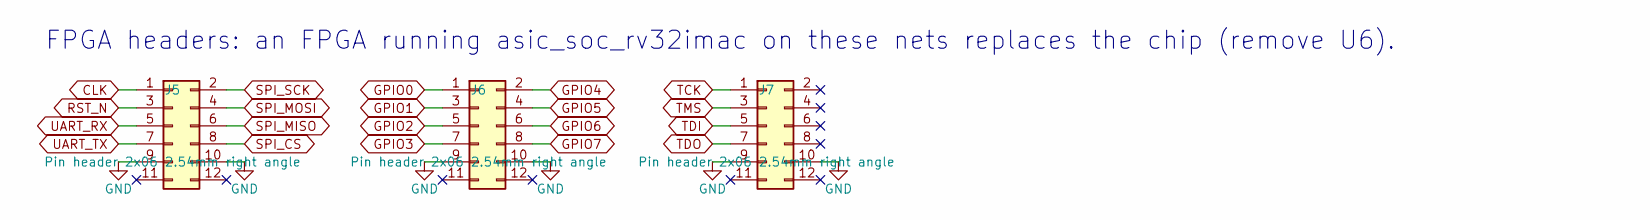
[picture p11: schematic fpga.kicad_sch, FPGA headers]

Parts:
J5, J6, J7: Pin header 2x06 2.54mm right angle; PinHeader_2x06_P2.54mm_Horizontal

Connections:
CLK: J5.1; also elsewhere on the board
GND: J5.9, J5.10, J6.9, J6.10, J7.9, J7.10; also elsewhere on the board
GPIO0: J6.1; also elsewhere on the board
GPIO1: J6.3; also elsewhere on the board
GPIO2: J6.5; also elsewhere on the board
GPIO3: J6.7; also elsewhere on the board
GPIO4: J6.2; also elsewhere on the board
GPIO5: J6.4; also elsewhere on the board
GPIO6: J6.6; also elsewhere on the board
GPIO7: J6.8; also elsewhere on the board
RST_N: J5.3; also elsewhere on the board
SPI_CS: J5.8; also elsewhere on the board
SPI_MISO: J5.6; also elsewhere on the board
SPI_MOSI: J5.4; also elsewhere on the board
SPI_SCK: J5.2; also elsewhere on the board
TCK: J7.1; also elsewhere on the board
TDI: J7.5; also elsewhere on the board
TDO: J7.7; also elsewhere on the board
TMS: J7.3; also elsewhere on the board
UART_RX: J5.5; also elsewhere on the board
UART_TX: J5.7; also elsewhere on the board

Notes on the sheet:
FPGA headers: an FPGA running asic_soc_rv32imac on these nets replaces the chip (remove U6).

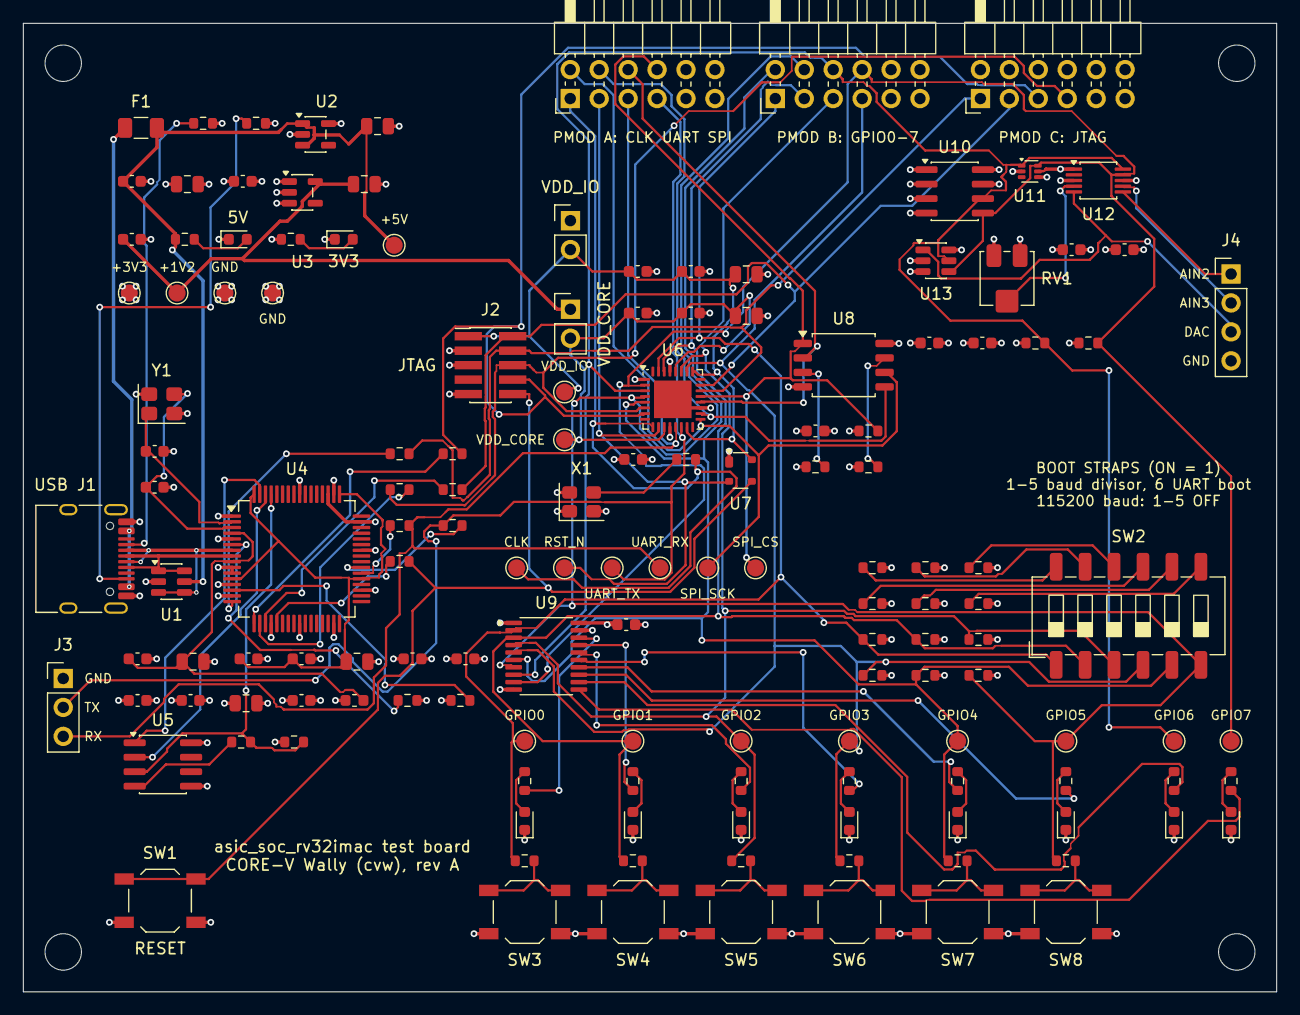
[picture p12: board mcu_board.kicad_pcb from above]

Board: 4 copper layers, 110.0 x 85.0 mm, 149 parts (0 on the bottom side), 86 nets.
