antoniofloresgil/cvw/src/privileged/privileged.sv

///////////////////////////////////////////
// privileged.sv
//
// Written:  David Harris David_Harris@hmc.edu 5 January 2021
// Modified: Rose Thompson, Thomas Fleming, Ben Bracker, Kip Macsai-Goren
//
// Purpose: Privileged unit.
//
// Documentation: RISC-V System on Chip Design
//
// A component of the CORE-V-WALLY configurable RISC-V project.
// https://github.com/openhwfoundation/cvw
//
// Copyright (C) 2021-26 Harvey Mudd College & Oklahoma State University
//
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
// The above copyright notice and this permission notice shall be included in all copies or substantial portions of the Software.
//
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
module privileged import cvw::*;  #(parameter cvw_t P, parameter int unsigned HART_ID = 0) (
  input  logic              clk, reset,
  input  logic              StallD, StallE, StallM, StallW,
  input  logic              FlushD, FlushE, FlushM, FlushW,
  // CSR Reads and Writes, and values needed for traps
  input  logic              CSRReadM, CSRWriteM,                            // Read or write CSRs
  input  logic [P.XLEN-1:0] SrcAM,                                          // rs1 source operand for CSR writes
  input  logic [31:0]       InstrM,                                         // Instruction
  input  logic [31:0]       InstrOrigM,                                     // Original compressed or uncompressed instruction in Memory stage for Illegal Instruction XTVAL
  input  logic [P.XLEN-1:0] IEUAdrxTvalM,                                   // address from IEU
  input  logic [P.XLEN-1:0] PCM,                                            // program counter
  input  logic [P.XLEN-1:0] PCSpillM,                                       // program counter
  // control signals
  input  logic              InstrValidM,                                    // Current instruction is valid (not flushed)
  input  logic              CommittedM, CommittedF,                         // current instruction is using bus; don't interrupt
  input  logic              PrivilegedM,                                    // privileged instruction
  // processor events for performance counter logging
  input  logic              FRegWriteM,                                     // instruction will write floating-point registers
  input  logic              LoadStallD,                                     // load instruction is stalling
  input  logic              StoreStallD,                                    // store instruction is stalling
  input  logic              ICacheStallF,                                   // I cache stalled
  input  logic              DCacheStallM,                                   // D cache stalled
  input  logic              BPDirWrongM,                                    // branch predictor guessed wrong direction
  input  logic              BTAWrongM,                                      // branch predictor guessed wrong target
  input  logic              RASPredPCWrongM,                                // return address stack guessed wrong target
  input  logic              IClassWrongM,                                   // branch predictor guessed wrong instruction class
  input  logic              BPWrongM,                                       // branch predictor is wrong
  input  logic [3:0]        IClassM,                                        // actual instruction class
  input  logic              DCacheMiss,                                     // data cache miss
  input  logic              DCacheAccess,                                   // data cache accessed (hit or miss)
  input  logic              ICacheMiss,                                     // instruction cache miss
  input  logic              ICacheAccess,                                   // instruction cache access
  input  logic              DivBusyE,                                       // integer divide busy
  input  logic              FDivBusyE,                                      // floating point divide busy
  // fault sources
  input  logic              InstrAccessFaultF,                              // instruction access fault
  input  logic              LoadAccessFaultM, StoreAmoAccessFaultM,         // load or store access fault
  input  logic              HPTWInstrAccessFaultF,                          // hardware page table access fault while fetching instruction PTE
  input  logic              HPTWInstrPageFaultF,                            // hardware page table page fault while fetching instruction PTE
  input  logic              InstrPageFaultF,                                // page faults
  input  logic              LoadPageFaultM, StoreAmoPageFaultM,             // page faults
  input  logic              InstrMisalignedFaultM,                          // misaligned instruction fault
  input  logic              LoadMisalignedFaultM, StoreAmoMisalignedFaultM, // misaligned data fault
  input  logic              IllegalIEUFPUInstrD,                            // illegal instruction from IEU or FPU
  input  logic              MTimerInt, MExtInt, SExtInt, MSwInt,            // interrupt sources
  input  logic [63:0]       MTIME_CLINT,                                    // timer value from CLINT
  input  logic [4:0]        SetFflagsM,                                     // set FCSR flags from FPU
  input  logic              SelHPTW,                                        // HPTW in use.  Causes system to use S-mode endianness for accesses
  input  logic              DebugHaltReq,                                   // halt request from the Debug Module (DEBUG_SUPPORTED)
  input  logic              DebugResetHaltReq,                              // it is resethaltreq's
  // CSR outputs
  output logic [P.XLEN-1:0] CSRReadValW,                                    // Value read from CSR
  output logic [1:0]        PrivilegeModeW,                                 // current privilege mode
  output logic [P.XLEN-1:0] SATP_REGW,                                      // supervisor address translation register
  output logic              STATUS_MXR, STATUS_SUM, STATUS_MPRV,            // status register bits
  output logic [1:0]        STATUS_MPP, STATUS_FS,                          // status register bits
  output var logic [7:0]    PMPCFG_ARRAY_REGW[P.PMP_ENTRIES-1:0],           // PMP configuration entries to MMU
  output var logic [P.PA_BITS-3:0] PMPADDR_ARRAY_REGW [P.PMP_ENTRIES-1:0],  // PMP address entries to MMU
  output logic [2:0]        FRM_REGW,                                       // FPU rounding mode
  output logic [3:0]        ENVCFG_CBE,                                     // Cache block operation enables
  output logic              ENVCFG_PBMTE,                                   // Page-based memory type enable
  output logic              ENVCFG_ADUE,                                    // HPTW A/D Update enable
  // PC logic output from privileged unit to IFU
  output logic [P.XLEN-1:0] EPCM,                                           // Exception Program counter to IFU PC logic
  output logic [P.XLEN-1:0] TrapVectorM,                                    // Trap vector, to IFU PC logic
  // control outputs
  output logic              RetM, TrapM,                                    // return instruction, or trap
  output logic              sfencevmaM,                                     // sfence.vma instruction
  output logic              sfencevmaAllM,                                  // sfence.vma with rs2=x0: flush all TLB entries including global
  input  logic              InvalidateICacheM,                              // fence.i instruction
  output logic              BigEndianM,                                     // Use big endian in current privilege mode
  // Fault outputs
  output logic              WaitM,                                          // wfi is waiting for an interrupt: stall the pipeline
  output logic [2*P.XLEN+13:0] ITrace,                                     // instruction trace interface (TRACE_SUPPORTED)
  output logic              DebugMode                                       // the hart is in Debug Mode (DEBUG_SUPPORTED)
);

  logic [4:0]               CauseM;                                         // trap cause
  logic [15:0]              MEDELEG_REGW;                                   // exception delegation CSR
  logic [13:0]              MIDELEG_REGW;                                   // interrupt delegation CSR
  logic                     sretM, mretM;                                   // supervisor / machine return instruction
  logic                     IllegalCSRAccessM;                              // Illegal access to CSR
  logic                     IllegalIEUFPUInstrM;                            // Illegal IEU or FPU instruction, delayed to Mem stage
  logic                     InstrPageFaultM;                                // Instruction page fault, delayed to Mem stage
  logic                     InstrAccessFaultM;                              // Instruction access fault, delayed to Mem stage
  logic                     IllegalInstrFaultM;                             // Illegal instruction fault
  logic                     STATUS_SPP, STATUS_TSR, STATUS_TW, STATUS_TVM;  // Status bits needed within privileged unit
  logic                     STATUS_MIE, STATUS_SIE;                         // status bits: interrupt enables
  logic [13:0]              MIP_REGW, MIE_REGW;                             // interrupt pending and enable bits
  logic [1:0]               NextPrivilegeModeM;                             // next privilege mode based on trap or return
  logic                     DelegateM;                                      // trap should be delegated
  logic                     InterruptM;                                     // interrupt occurring
  logic                     ExceptionM;                                     // Memory stage instruction caused a fault
  logic                     HPTWInstrAccessFaultM;                          // Hardware page table access fault while fetching instruction PTE
  logic                     HPTWInstrPageFaultM;                            // Hardware page table page fault while fetching instruction PTE
  logic                     BreakpointFaultM, EcallFaultM;                  // breakpoint and Ecall traps; they do not retire

  logic                     IntPendingM;                                    // a locally enabled interrupt is pending
  logic                     WaitedM;                                        // wfi in M has waited

  // Debug Mode (src/debug/debugmode.sv): it steers the trap and return paths below
  logic                     ArchTrapM, TrapRawM;                            // architectural trap; trap from the trap logic
  logic                     DebugEnterM, DebugTrapM, EBreakToDebugM, dretM, DebugIntMask, DebugCSRHitM, DebugWakeM;
  logic [P.XLEN-1:0]        DebugTrapVectorM, DPC, DebugCSRReadValM, DebugCSRReadValW;
  logic [1:0]               DCSRPrv;
  logic [P.XLEN-1:0]        CSREPCM, CSRTrapVectorM, CSRCSRReadValW;
  logic                     CSRIllegalCSRAccessM, PrivIllegalInstrFaultM, STATUS_MPRV_CSR, PrivRetM;
  logic                     TrigBreakM;                                     // a trigger raises a breakpoint exception

  // track the current privilege level
  // Debug Mode enters M like an undelegated trap, and dret returns like an mret to dcsr.prv
  privmode #(P) privmode(.clk, .reset, .StallW, .TrapM(ArchTrapM | DebugEnterM), .mretM(mretM | dretM), .sretM,
    .DelegateM(DelegateM & ~DebugEnterM), .STATUS_MPP(dretM ? DCSRPrv : STATUS_MPP), .STATUS_SPP,
    .NextPrivilegeModeM, .PrivilegeModeW);

  // decode privileged instructions
  privdec #(P) pmd(.clk, .reset, .StallM, .InstrM(InstrM[31:7]),
    .PrivilegedM, .IllegalIEUFPUInstrM, .IllegalCSRAccessM,
    .PrivilegeModeW, .STATUS_TSR, .STATUS_TVM, .STATUS_TW, .IntPendingM(IntPendingM | DebugWakeM),
    .IllegalInstrFaultM(PrivIllegalInstrFaultM),
    .EcallFaultM, .BreakpointFaultM, .sretM, .mretM, .RetM(PrivRetM), .WaitM, .WaitedM, .sfencevmaM, .sfencevmaAllM);

  // Control and Status Registers
  csr #(.P(P), .HART_ID(HART_ID)) csr(.clk, .reset, .FlushM, .FlushW, .StallE, .StallM, .StallW,
    .InstrM, .InstrOrigM, .PCM, .PCSpillM, .SrcAM, .IEUAdrxTvalM,
    .CSRReadM, .CSRWriteM, .TrapM(ArchTrapM), .mretM, .sretM, .InterruptM,
    .MTimerInt, .MExtInt, .SExtInt, .MSwInt,
    .MTIME_CLINT, .InstrValidM, .FRegWriteM, .LoadStallD, .StoreStallD,
    .BPDirWrongM, .BTAWrongM, .RASPredPCWrongM, .BPWrongM,
    .sfencevmaM, .InvalidateICacheM, .ICacheStallF, .DCacheStallM, .DivBusyE, .FDivBusyE,
    .IClassWrongM, .IClassM, .DCacheMiss, .DCacheAccess, .ICacheMiss, .ICacheAccess,
    .NextPrivilegeModeM, .PrivilegeModeW, .CauseM, .SelHPTW,
    .STATUS_MPP, .STATUS_SPP, .STATUS_TSR, .STATUS_TVM,
    .STATUS_MIE, .STATUS_SIE, .STATUS_MXR, .STATUS_SUM, .STATUS_MPRV(STATUS_MPRV_CSR), .STATUS_TW, .STATUS_FS,
    .MEDELEG_REGW, .MIP_REGW, .MIE_REGW, .MIDELEG_REGW,
    .SATP_REGW, .PMPCFG_ARRAY_REGW, .PMPADDR_ARRAY_REGW,
    .SetFflagsM, .FRM_REGW, .ENVCFG_CBE, .ENVCFG_PBMTE, .ENVCFG_ADUE,
    .EPCM(CSREPCM), .TrapVectorM(CSRTrapVectorM),
    .CSRReadValW(CSRCSRReadValW), .IllegalCSRAccessM(CSRIllegalCSRAccessM), .BigEndianM);

  // pipeline early-arriving trap sources
  privpiperegs ppr(.clk, .reset, .StallD, .StallE, .StallM, .FlushD, .FlushE, .FlushM,
    .InstrPageFaultF, .InstrAccessFaultF, .HPTWInstrAccessFaultF, .HPTWInstrPageFaultF, .IllegalIEUFPUInstrD,
    .InstrPageFaultM, .InstrAccessFaultM, .HPTWInstrAccessFaultM, .HPTWInstrPageFaultM, .IllegalIEUFPUInstrM);

  // trap logic
  trap #(P) trap(.reset,
    .InstrMisalignedFaultM, .InstrAccessFaultM, .HPTWInstrAccessFaultM, .HPTWInstrPageFaultM, .IllegalInstrFaultM,
    .BreakpointFaultM(BreakpointFaultM & ~EBreakToDebugM | TrigBreakM), .LoadMisalignedFaultM, .StoreAmoMisalignedFaultM,
    .LoadAccessFaultM, .StoreAmoAccessFaultM, .EcallFaultM, .InstrPageFaultM,
    .LoadPageFaultM, .StoreAmoPageFaultM, .PrivilegeModeW,
    .MIP_REGW, .MIE_REGW(DebugIntMask ? '0 : MIE_REGW), .MIDELEG_REGW, .MEDELEG_REGW, .STATUS_MIE, .STATUS_SIE,
    .InstrValidM, .CommittedM, .CommittedF,
    .TrapM(TrapRawM), .WaitedM, .InterruptM, .ExceptionM, .IntPendingM, .DelegateM, .CauseM);

  ///////////////////////////////////////////
  // Debug Mode and triggers (DEBUG_SUPPORTED)
  ///////////////////////////////////////////

  if (P.DEBUG_SUPPORTED) begin : debug
    logic              TrigDebugM, ModeCSRHitM, TrigCSRHitM;
    logic [P.XLEN-1:0] ModeCSRReadValM, TrigCSRReadValM;
    debugmode #(P) debugmode(.clk, .reset, .StallW, .FlushW, .DebugHaltReq, .DebugResetHaltReq, .TrigDebugM,
      .InstrM, .PrivilegedM, .InstrValidM, .CommittedM, .CommittedF, .WaitedM, .PCM, .PrivilegeModeW,
      .BreakpointFaultM, .ExceptionM, .ArchTrapM, .CSRReadM, .CSRWriteM, .SrcAM,
      .DebugMode, .DebugEnterM, .DebugTrapM, .DebugTrapVectorM, .EBreakToDebugM, .dretM, .DPC, .DCSRPrv,
      .DebugIntMask, .DebugWakeM, .DebugCSRHitM(ModeCSRHitM), .DebugCSRReadValM(ModeCSRReadValM));
    // Triggers (Sdtrig, DEBUG_TRIGGERS)
    if (P.DEBUG_TRIGGERS > 0) begin : trig
      triggers #(P) triggers(.clk, .reset, .StallW, .FlushW, .DebugMode, .PrivilegeModeW, .STATUS_MIE,
        .InstrM, .InstrValidM, .CommittedM, .CommittedF, .WaitedM, .PCM, .IEUAdrM(IEUAdrxTvalM),
        .ArchTrapM, .InterruptM, .CauseM, .CSRReadM, .CSRWriteM, .SrcAM,
        .TrigCSRHitM, .TrigCSRReadValM, .TrigDebugM, .TrigBreakM);
    end else begin : notrig
      assign {TrigCSRHitM, TrigDebugM, TrigBreakM} = '0;
      assign TrigCSRReadValM = '0;
    end
    assign DebugCSRHitM = ModeCSRHitM | TrigCSRHitM;
    assign DebugCSRReadValM = ModeCSRReadValM | TrigCSRReadValM;
    flopenrc #(P.XLEN) dcsrvalreg(clk, reset, FlushW, ~StallW, DebugCSRReadValM, DebugCSRReadValW);
  end else begin : nodebug
    assign {DebugMode, DebugEnterM, DebugTrapM, EBreakToDebugM, dretM, DebugIntMask, DebugWakeM, DebugCSRHitM, TrigBreakM} = '0;
    assign {DebugTrapVectorM, DPC, DebugCSRReadValW} = '0;
    assign DCSRPrv = P.M_MODE;
  end

  // Architectural traps do not happen in Debug Mode, nor on the instruction before which the hart
  // enters it; the redirect of the PC covers both
  assign ArchTrapM   = TrapRawM & ~DebugMode & ~DebugEnterM;
  assign TrapM       = ArchTrapM | DebugTrapM;
  assign TrapVectorM = DebugTrapM ? DebugTrapVectorM : CSRTrapVectorM;
  assign RetM        = sretM | mretM | dretM;
  assign EPCM        = dretM ? DPC : CSREPCM;
  // dret is legal in Debug Mode, and so are the debug CSRs (the trigger CSRs in M-mode too)
  assign IllegalInstrFaultM = PrivIllegalInstrFaultM & ~dretM;
  assign IllegalCSRAccessM  = CSRIllegalCSRAccessM & ~DebugCSRHitM;
  assign CSRReadValW = CSRCSRReadValW | DebugCSRReadValW;
  ///////////////////////////////////////////
  // Instruction trace interface (TRACE_SUPPORTED, docs/trace.md)
  ///////////////////////////////////////////

  if (P.TRACE_SUPPORTED) begin : trace
    etraceingress #(P) etraceingress(.clk, .reset, .StallW, .FlushW, .InstrValidM, .PCM, .PCSpillM,
      .IEUAdrxTvalM, .InstrOrigM, .xRetM(mretM | sretM), .PrivilegeModeW, .DebugMode, .ArchTrapM,
      .InterruptM, .EcallM(EcallFaultM), .EBreakM(BreakpointFaultM), .CauseM, .DebugEnterM, .ITrace);
  end else assign ITrace = '0;

  // mstatus.MPRV does not apply in Debug Mode (dcsr.mprven = 0)
  assign STATUS_MPRV = STATUS_MPRV_CSR & ~DebugMode;
endmodule
