antoniofloresgil/cvw/fpga/constraints/constraints-nexysvideo.xdc

##### Clock and reset #####
set_property -dict {PACKAGE_PIN R4 IOSTANDARD LVCMOS33} [get_ports default_100mhz_clk]
set_property -dict {PACKAGE_PIN G4 IOSTANDARD LVCMOS15} [get_ports resetn]

##### UART #####
set_property -dict {PACKAGE_PIN V18 IOSTANDARD LVCMOS33} [get_ports UARTSin]
set_property -dict {PACKAGE_PIN AA19 IOSTANDARD LVCMOS33 DRIVE 4} [get_ports UARTSout]

##### Switches and LEDs #####
set_property -dict {PACKAGE_PIN E22 IOSTANDARD LVCMOS12} [get_ports {GPI[0]}]
set_property -dict {PACKAGE_PIN F21 IOSTANDARD LVCMOS12} [get_ports {GPI[1]}]
set_property -dict {PACKAGE_PIN G21 IOSTANDARD LVCMOS12} [get_ports {GPI[2]}]
set_property -dict {PACKAGE_PIN G22 IOSTANDARD LVCMOS12} [get_ports {GPI[3]}]
set_property -dict {PACKAGE_PIN T14 IOSTANDARD LVCMOS25} [get_ports {GPO[0]}]
set_property -dict {PACKAGE_PIN T15 IOSTANDARD LVCMOS25} [get_ports {GPO[1]}]
set_property -dict {PACKAGE_PIN T16 IOSTANDARD LVCMOS25} [get_ports {GPO[2]}]
set_property -dict {PACKAGE_PIN U16 IOSTANDARD LVCMOS25} [get_ports {GPO[3]}]
set_property -dict {PACKAGE_PIN V15 IOSTANDARD LVCMOS25} [get_ports {GPO[4]}]

##### Micro SD #####
set_property -dict {PACKAGE_PIN W19 IOSTANDARD LVCMOS33} [get_ports SDCCLK]
set_property -dict {PACKAGE_PIN W20 IOSTANDARD LVCMOS33 PULLTYPE PULLUP} [get_ports SDCCmd]
set_property -dict {PACKAGE_PIN V19 IOSTANDARD LVCMOS33 PULLTYPE PULLUP} [get_ports SDCIn]
set_property -dict {PACKAGE_PIN U18 IOSTANDARD LVCMOS33 PULLTYPE PULLUP} [get_ports SDCCS]
set_property -dict {PACKAGE_PIN T18 IOSTANDARD LVCMOS33 PULLTYPE PULLUP} [get_ports SDCCD]
set_property -dict {PACKAGE_PIN V20 IOSTANDARD LVCMOS33} [get_ports SD_RESET]

##### DDR3 #####
set_property IO_BUFFER_TYPE NONE [get_ports {ddr3_ck_n[*]}]
set_property IO_BUFFER_TYPE NONE [get_ports {ddr3_ck_p[*]}]

set_property CONFIG_VOLTAGE 3.3 [current_design]
set_property CFGBVS VCCO [current_design]
