antoniofloresgil/cvw/src/mmu/mmu.sv

///////////////////////////////////////////
// mmu.sv
//
// Written:  David Harris David_Harris@hmc.edu, Kip Macsai-Goren kmacsaigoren@hmc.edu 4 June 2021
// Modified: Rose Thompson, Muhammad Zain
//
// Purpose: Memory management unit: TLB, PMA, and PMP checks.
//
// Documentation: RISC-V System on Chip Design
//
// A component of the CORE-V-WALLY configurable RISC-V project.
// https://github.com/openhwfoundation/cvw
//
// Copyright (C) 2021-26 Harvey Mudd College & Oklahoma State University
//
// SPDX-License-Identifier: Apache-2.0 WITH SHL-2.1
////////////////////////////////////////////////////////////////////////////////////////////////

module mmu import cvw::*; #(parameter cvw_t P,
                            parameter TLB_ENTRIES = 8, IMMU = 0) (
  input  logic                     clk, reset,
  input  logic [P.XLEN-1:0]        SATP_REGW,          // Current value of satp CSR (from privileged unit)
  input  logic                     STATUS_MXR,         // Status CSR: make executable page readable
  input  logic                     STATUS_SUM,         // Status CSR: Supervisor access to user memory
  input  logic                     STATUS_MPRV,        // Status CSR: modify machine privilege
  input  logic [1:0]               STATUS_MPP,         // Status CSR: previous machine privilege level
  input  logic                     ENVCFG_PBMTE,       // Page-based memory types enabled
  input  logic                     ENVCFG_ADUE,        // HPTW A/D Update enable
  input  logic [1:0]               PrivilegeModeW,     // Current privilege level of the processor
  input  logic                     DebugMode,          // the hart is in Debug Mode: the Debug Module's memory is accessible
  input  logic                     DisableTranslation, // virtual address translation disabled during D$ flush and HPTW walk that use physical addresses
  input  logic [P.XLEN+1:0]        VAdr,               // virtual/physical address from IEU or physical address from HPTW
  input  logic [2:0]               Size,               // access size: 000 = 8 bits, 001 = 16 bits, 010 = 32 bits, 011 = 64 bits, 100 = 128 bits
  input  logic [P.XLEN-1:0]        PTE,                // page table entry
  input  logic [2:0]               PageTypeWriteVal,   // page type
  input  logic                     TLBWrite,           // write TLB entry
  input  logic                     TLBFlush,           // Invalidate all TLB entries (ASID-specific preserves global)
  input  logic                     TLBFlushAll,        // Flush global (G=1) entries too; when 0, G=1 entries are preserved
  output logic [P.PA_BITS-1:0]     PhysicalAddress,    // PAdr when no translation, or translated VAdr (TLBPAdr) when there is translation
  output logic                     TLBMiss,            // Miss TLB
  output logic                     Cacheable,          // PMA indicates memory address is cacheable
  output logic                     Idempotent,         // PMA indicates memory address is idempotent
  output logic                     SelTIM,             // Select a tightly integrated memory
  // Faults
  output logic                     InstrAccessFaultF, LoadAccessFaultM, StoreAmoAccessFaultM, // access fault sources
  output logic                     InstrPageFaultF, LoadPageFaultM, StoreAmoPageFaultM,       // page fault sources
  output logic                     UpdateDA,                                                  // TLB hit needs to set the dirty or access bit
  output logic                     LoadMisalignedFaultM, StoreAmoMisalignedFaultM,            // misaligned fault sources
  // PMA checker signals
  input  logic [3:0]               CMOpM,                                                     // Cache management instructions
  input  logic                     AtomicAccessM, ExecuteAccessF, WriteAccessM, ReadAccessM,  // access type
  input  var logic [7:0]           PMPCFG_ARRAY_REGW[P.PMP_ENTRIES-1:0],                      // PMP configuration
  input  var logic [P.PA_BITS-3:0] PMPADDR_ARRAY_REGW[P.PMP_ENTRIES-1:0]                      // PMP addresses
);

  logic [P.PA_BITS-1:0]        TLBPAdr;                  // physical address for TLB
  logic                        PMAInstrAccessFaultF;     // Instruction access fault from PMA
  logic                        PMPInstrAccessFaultF;     // Instruction access fault from PMP
  logic                        PMALoadAccessFaultM;      // Load access fault from PMA
  logic                        PMPLoadAccessFaultM;      // Load access fault from PMP
  logic                        PMAStoreAmoAccessFaultM;  // Store or AMO access fault from PMA
  logic                        PMPStoreAmoAccessFaultM;  // Store or AMO access fault from PMP
  logic                        DataMisalignedM;          // load or store misaligned
  logic                        SizeMisalignedM;          // misaligned for an access of 64 bits or less
  logic                        Translate;                // Translation occurs when virtual memory is active and DisableTranslation is off
  logic                        TLBPageFault;             // Page fault from TLB
  logic                        ReadNoAmoAccessM;         // Read that is not part of atomic operation causes Load faults.  Otherwise StoreAmo faults
  logic [1:0]                  PBMemoryType;             // PBMT field of PTE during TLB hit, or 00 otherwise
  logic                        MisalignedCausesAccessFaultM; // Misaligned access throws an access fault instead of a misaligned fault
  logic [1:0]                  EffectivePrivilegeModeW;  // Effective privilege mode accounting for MPRV
  logic                        MisalignedFaultAllowedM;  // System can throw misaligned if ZICCLSM is not supported, or access is uncachable, idempotent, and TLB has found the entry.
  logic                        PAOutOfRange;             // Untranslated address has nonzero bits above PA_BITS

  // Get Effective Privilege Mode
  // for DTLB, when mstatus.MPRV=1, use mstatus.MPP rather than the current privilege mode
  assign EffectivePrivilegeModeW = IMMU ? PrivilegeModeW : (STATUS_MPRV ? STATUS_MPP : PrivilegeModeW);

  // only instantiate TLB if Virtual Memory is supported
  if (P.VIRTMEM_SUPPORTED) begin : tlb
    logic ReadAccess, WriteAccess;
    assign ReadAccess = ExecuteAccessF | ReadAccessM; // execute also acts as a TLB read.  Execute and Read are never active for the same MMU, so safe to mix pipestages
    assign WriteAccess = WriteAccessM;
    tlb #(.P(P), .TLB_ENTRIES(TLB_ENTRIES), .ITLB(IMMU)) tlb(
          .clk, .reset,
          .SATP_MODE(SATP_REGW[P.XLEN-1:P.XLEN-P.SVMODE_BITS]),
          .SATP_ASID(SATP_REGW[P.ASID_BASE+P.ASID_BITS-1:P.ASID_BASE]),
          .VAdr(VAdr[P.XLEN-1:0]), .STATUS_MXR, .STATUS_SUM, .STATUS_MPRV, .STATUS_MPP, .ENVCFG_PBMTE, .ENVCFG_ADUE,
          .EffectivePrivilegeModeW, .ReadAccess, .WriteAccess, .CMOpM,
          .DisableTranslation, .PTE, .PageTypeWriteVal,
          .TLBWrite, .TLBFlush, .TLBFlushAll, .TLBPAdr, .TLBMiss,
          .Translate, .TLBPageFault, .UpdateDA, .PBMemoryType);
  end else begin : notlb // just pass address through as physical
    assign Translate    = 1'b0;
    assign TLBMiss      = 1'b0;
    assign TLBPageFault = 1'b0;
    assign PBMemoryType = 2'b00;
    assign UpdateDA     = 1'b0;
    assign TLBPAdr      = '0;
  end

  // If translation is occurring, select translated physical address from TLB
  // the lower 12 bits are the page offset. These are never changed from the original
  // non translated address.
  mux2 #(P.PA_BITS-12) addressmux(VAdr[P.PA_BITS-1:12], TLBPAdr[P.PA_BITS-1:12], Translate, PhysicalAddress[P.PA_BITS-1:12]);
  assign PhysicalAddress[11:0] = VAdr[11:0];

  // An untranslated address is a physical address, so bits XLEN-1:PA_BITS must be zero.  Otherwise it is outside
  // the physical address space rather than an alias of a lower address, and the PMA checker raises an access fault.
  // Translated addresses come from the PPN and always fit; RV32 addresses are narrower than PA_BITS.
  if (P.XLEN > P.PA_BITS) assign PAOutOfRange = ~Translate & (|VAdr[P.XLEN-1:P.PA_BITS]);
  else                    assign PAOutOfRange = 1'b0;

  ///////////////////////////////////////////
  // Check physical memory accesses
  ///////////////////////////////////////////

  pmachecker #(P) pmachecker(.PhysicalAddress, .PAOutOfRange, .Size, .CMOpM,
    .AtomicAccessM, .ExecuteAccessF, .WriteAccessM, .ReadAccessM, .PBMemoryType, .DebugMode,
    .Cacheable, .Idempotent, .SelTIM,
    .PMAInstrAccessFaultF, .PMALoadAccessFaultM, .PMAStoreAmoAccessFaultM);

  // In Debug Mode the Debug Module's memory (0x0-0xFFF: its ROM, program buffer and data registers) is not subject to
  // PMP: a locked entry applies to Machine mode too, and a catch-all one without execute permission (an RTOS's) would
  // fault the fetch of the Debug ROM, so the hart would never halt.  Outside Debug Mode the region is unmapped.
  logic PMPBypass;
  if (P.DEBUG_SUPPORTED) assign PMPBypass = DebugMode & (PhysicalAddress[P.PA_BITS-1:12] == '0);
  else                   assign PMPBypass = 1'b0;

  if (P.PMP_ENTRIES > 0) begin : pmp
    logic PMPInstrAccessFaultRawF, PMPLoadAccessFaultRawM, PMPStoreAmoAccessFaultRawM;
    pmpchecker #(P) pmpchecker(.PhysicalAddress, .EffectivePrivilegeModeW,
      .PMPCFG_ARRAY_REGW, .PMPADDR_ARRAY_REGW,
      .ExecuteAccessF, .WriteAccessM, .ReadAccessM, .Size(Size[1:0]), .CMOpM,
      .PMPInstrAccessFaultF(PMPInstrAccessFaultRawF), .PMPLoadAccessFaultM(PMPLoadAccessFaultRawM),
      .PMPStoreAmoAccessFaultM(PMPStoreAmoAccessFaultRawM));
    assign PMPInstrAccessFaultF     = PMPInstrAccessFaultRawF & ~PMPBypass;
    assign PMPStoreAmoAccessFaultM  = PMPStoreAmoAccessFaultRawM & ~PMPBypass;
    assign PMPLoadAccessFaultM      = PMPLoadAccessFaultRawM & ~PMPBypass;
  end else begin
    assign PMPInstrAccessFaultF     = 1'b0;
    assign PMPStoreAmoAccessFaultM  = 1'b0;
    assign PMPLoadAccessFaultM      = 1'b0;
  end

  assign ReadNoAmoAccessM = ReadAccessM & ~WriteAccessM; // AMO causes StoreAmo rather than Load fault

  // Misaligned faults
  always_comb // exclusion-tag: immu-wordaccess
    case (Size[1:0])
      2'b00:  SizeMisalignedM = 1'b0;              // lb, sb, lbu // exclusion-tag: mmu-size-byte
      2'b01:  SizeMisalignedM = VAdr[0];           // lh, sh, lhu // exclusion-tag: mmu-size-half
      2'b10:  SizeMisalignedM = VAdr[1] | VAdr[0]; // lw, sw, flw, fsw, lwu
      2'b11:  SizeMisalignedM = |VAdr[2:0];        // ld, sd, fld, fsd // exclusion-tag: mmu-size-double
    endcase
  if (P.LLEN == 128) assign DataMisalignedM = Size[2] ? |VAdr[3:0] : SizeMisalignedM; // flq, fsq
  else               assign DataMisalignedM = SizeMisalignedM;

  // When ZICCLSM_SUPPORTED, misaligned cacheable loads and stores are handled in hardware so they do not throw a misaligned fault
  // When ZICCLSM_SUPPORTED, misaligned uncachable accesses are lower priority than page and access faults, so must wait for TLB to resolve
  // When ZICCLSM_SUPPORTED, misaligned atomics take an access fault instead (below), whatever the region
  // When ZICCLSM is not supported, misaligned accesses always fault, with higher priority than access or page fault
  assign MisalignedFaultAllowedM  = ~P.ZICCLSM_SUPPORTED | (~Cacheable & ~TLBMiss & Idempotent & ~AtomicAccessM); // should a misaligned access fault?
  assign LoadMisalignedFaultM     = DataMisalignedM & ReadNoAmoAccessM & MisalignedFaultAllowedM;
  assign StoreAmoMisalignedFaultM = DataMisalignedM & WriteAccessM & MisalignedFaultAllowedM; // Store and AMO both assert WriteAccess

  // A misaligned access causes an access fault rather than a misaligned fault when a misaligned load/store is
  // handled in hardware and either the access is atomic, which is never handled in hardware and must not be
  // emulated (privileged spec 3.6.3.3), or the region is non-idempotent, where the spec recommends an access
  // fault so software does not emulate the access with multiple smaller accesses that could have side effects
  assign MisalignedCausesAccessFaultM = DataMisalignedM & P.ZICCLSM_SUPPORTED & (AtomicAccessM | ~Idempotent);

  // Access faults
  // If TLB miss and translating we want to not have faults from the PMA and PMP checkers.
  assign InstrAccessFaultF    = (PMAInstrAccessFaultF    | PMPInstrAccessFaultF)    & ~TLBMiss; // exclusion-tag: mmu-instr-fault
  assign LoadAccessFaultM     = (PMALoadAccessFaultM     | PMPLoadAccessFaultM     | MisalignedCausesAccessFaultM & ReadNoAmoAccessM)     & ~TLBMiss; // exclusion-tag: mmu-load-fault
  assign StoreAmoAccessFaultM = (PMAStoreAmoAccessFaultM | PMPStoreAmoAccessFaultM | MisalignedCausesAccessFaultM & WriteAccessM) & ~TLBMiss; // exclusion-tag: mmu-store-fault

  // Specify which type of page fault is occurring
  assign InstrPageFaultF    = TLBPageFault & ExecuteAccessF;
  assign LoadPageFaultM     = TLBPageFault & ReadNoAmoAccessM;
  assign StoreAmoPageFaultM = TLBPageFault & (WriteAccessM | (|CMOpM));
endmodule
