antoniofloresgil/cvw/src/wally/wallypipelinedsoc.sv

///////////////////////////////////////////
// wallypipelinedsoc.sv
//
// Written:  David Harris David_Harris@hmc.edu 6 November 2020
// Modified: Rose Thompson, Jacob Pease, Ben Bracker, Naiche Whyte-Aguayo
//
// Purpose: System on chip: core and uncore.
//
// Documentation: RISC-V System on Chip Design
//
// A component of the CORE-V-WALLY configurable RISC-V project.
// https://github.com/openhwfoundation/cvw
//
// Copyright (C) 2020-26 Harvey Mudd College & Oklahoma State University
//
// SPDX-License-Identifier: Apache-2.0 WITH SHL-2.1
////////////////////////////////////////////////////////////////////////////////////////////////

module wallypipelinedsoc import cvw::*; #(parameter cvw_t P, `CVW_MULTICORE_PARAMS(P.AHBW))  (
  input  logic                clk,
  input  logic                reset_ext,        // external asynchronous reset pin
  output logic                reset,            // reset synchronized to clk to prevent races on release
  // AHB Interface
  input  logic [P.AHBW-1:0]    HRDATAEXT,
  input  logic                 HREADYEXT, HRESPEXT,
  output logic                 HSELEXT,
  // fpga debug signals
  input  logic                 ExternalStall,
  // outputs to external memory, shared with uncore memory
  output logic                 HCLK, HRESETn,
  output logic [P.PA_BITS-1:0] HADDR,
  output logic [P.AHBW-1:0]    HWDATA,
  output logic [P.XLEN/8-1:0]  HWSTRB,
  output logic                 HWRITE,
  output logic [2:0]           HSIZE,
  output logic [2:0]           HBURST,
  output logic [3:0]           HPROT,
  output logic [1:0]           HTRANS,
  output logic                 HMASTLOCK,
  output logic                 HREADY,
  // I/O Interface
  input  logic [31:0]          GPIOIN,          // inputs from GPIO
  output logic [31:0]          GPIOOUT,         // output values for GPIO
  output logic [31:0]          GPIOEN,          // output enables for GPIO
  input  logic                 UARTSin,         // UART serial data input
  output logic                 UARTSout,        // UART serial data output
  input  logic                 SPIIn,           // SPI pins in
  output logic                 SPIOut,          // SPI pins out
  output logic [3:0]           SPICS,           // SPI chip select pins
  output logic                 SPICLK,          // SPI clock
  input  logic                 SDCIn,           // SDC DATA[0]     to     SPI DI
  output logic                 SDCCmd,          // SDC CMD         from   SPI DO
  output logic [3:0]           SDCCS,           // SDC Card Detect from   SPI CS
  output logic                 SDCCLK,          // SDC Clock       from   SPI Clock
  output logic [3:0]           PWMGPIO,         // PWM GPIO output
  // JTAG debug port (DEBUG_SUPPORTED).  The inputs default to 0, so that the SoC's existing
  // instances need not connect them.
  input  logic                 TCK = 1'b0,
  input  logic                 TMS = 1'b0,
  input  logic                 TDI = 1'b0,
  output logic                 TDO
);

  // Uncore signals
  logic [P.AHBW-1:0]          HRDATA;           // from AHB mux in uncore
  logic                       HRESP;            // response from AHB
  logic [NCORES-1:0]          MTimerInt, MSwInt;// timer and software interrupts from CLINT
  logic [63:0]                MTIME_CLINT;      // from CLINT to CSRs
  logic [NCORES-1:0]          MExtInt,SExtInt;  // from PLIC

  // synchronize reset to SOC clock domain
  logic                       PowerOnReset;     // resets everything, the Debug Module too
  logic [NCORES-1:0]          CoreReset;        // each hart: reset, or held by the Debug Module
  logic                       NDMReset;
  logic [NCORES-1:0]          HartReset;
  synchronizer resetsync(.clk, .d(reset_ext), .q(PowerOnReset));
  // The watchdog's reset request (MCU_SUPPORTED) resets everything but the Debug Module.  It is held
  // for 16 clocks: the reset clears the watchdog, which drops the request.
  logic                       WDTReset;         // from the watchdog in the uncore
  logic [3:0]                 WDTHold;
  always_ff @(posedge clk)
    if (PowerOnReset)         WDTHold <= 4'd0;
    else if (WDTReset)        WDTHold <= 4'd15;
    else if (WDTHold != 4'd0) WDTHold <= WDTHold - 4'd1;
  assign reset = PowerOnReset | NDMReset | (WDTHold != 4'd0);
  assign CoreReset = {NCORES{reset}} | HartReset;

  // AHB between the memory system and the uncore, and the Debug Module's System Bus Access
  logic [P.PA_BITS-1:0]       MemHADDR, DbgHADDR;
  logic [P.AHBW-1:0]          MemHWDATA, DbgHWDATA;
  logic [P.XLEN/8-1:0]        MemHWSTRB, DbgHWSTRB;
  logic                       MemHWRITE, MemHMASTLOCK, MemHREADY, DbgHWRITE, DbgHREADY;
  logic [2:0]                 MemHSIZE, MemHBURST, DbgHSIZE;
  logic [3:0]                 MemHPROT;
  logic [1:0]                 MemHTRANS, DbgHTRANS;
  logic [P.AHBW-1:0]          MemHRDATA;
  logic [NCORES-1:0]          DebugHaltReq, DebugResetHaltReq;   // to each hart

  if (P.DEBUG_SUPPORTED) begin : debug
    logic       DMIReq, DMIWrite, DMIError;
    logic [6:0] DMIAddr;
    logic [31:0] DMIWData, DMIRData;
    dtm dtm(.TRSTn(~reset_ext), .TCK, .TMS, .TDI, .TDO, .clk, .reset(PowerOnReset),
      .DMIReq, .DMIAddr, .DMIWData, .DMIWrite, .DMIRData, .DMIError);
    logic              DMHSEL;
    logic [P.AHBW-1:0] DMHRDATA;
    dm #(.P(P), .NHARTS(NCORES)) dm(.clk, .reset(PowerOnReset), .DMIReq, .DMIAddr, .DMIWData, .DMIWrite, .DMIRData, .DMIError,
      .NDMReset, .HartReset, .DebugHaltReq, .DebugResetHaltReq,
      .DMHSEL, .DMHADDR(MemHADDR[11:0]), .DMHWRITE(MemHWRITE), .DMHREADY(HREADY), .DMHWDATA(MemHWDATA),
      .DMHWSTRB(MemHWSTRB), .DMHRDATA, .SBHADDR(DbgHADDR), .SBHWDATA(DbgHWDATA), .SBHWSTRB(DbgHWSTRB),
      .SBHWRITE(DbgHWRITE), .SBHSIZE(DbgHSIZE), .SBHTRANS(DbgHTRANS), .SBHREADY(DbgHREADY),
      .SBHRDATA(HRDATA), .SBHRESP(HRESP));
    ahbdebugarb #(.P(P)) arb(.HCLK, .HRESETn,
      .CoreHADDR(MemHADDR), .CoreHWDATA(MemHWDATA), .CoreHWSTRB(MemHWSTRB), .CoreHWRITE(MemHWRITE),
      .CoreHSIZE(MemHSIZE), .CoreHBURST(MemHBURST), .CoreHPROT(MemHPROT), .CoreHTRANS(MemHTRANS),
      .CoreHMASTLOCK(MemHMASTLOCK), .CoreHREADY(MemHREADY), .CoreHRDATA(MemHRDATA),
      .DbgHADDR, .DbgHWDATA, .DbgHWSTRB, .DbgHWRITE, .DbgHSIZE, .DbgHTRANS, .DbgHREADY, .DMHSEL, .DMHRDATA,
      .HADDR, .HWDATA, .HWSTRB, .HWRITE, .HSIZE, .HBURST, .HPROT, .HTRANS, .HMASTLOCK, .HREADY, .HRDATA);
  end else begin : nodebug
    assign {NDMReset, HartReset, DebugHaltReq, DebugResetHaltReq, TDO} = '0;
    assign MemHRDATA = HRDATA;
    assign {HADDR, HWDATA, HWSTRB, HWRITE, HSIZE, HBURST, HPROT, HTRANS, HMASTLOCK} =
      {MemHADDR, MemHWDATA, MemHWSTRB, MemHWRITE, MemHSIZE, MemHBURST, MemHPROT, MemHTRANS, MemHMASTLOCK};
    assign MemHREADY = HREADY;
    assign {DbgHADDR, DbgHWDATA, DbgHWSTRB, DbgHWRITE, DbgHSIZE, DbgHTRANS, DbgHREADY} = '0;
  end

  // Keep hart zero named core for existing single-core verification probes.
  logic [NCORES-1:0][P.PA_BITS-1:0] CoreHADDR;
  logic [NCORES-1:0][P.AHBW-1:0] CoreHWDATA, CoreHRDATA;
  logic [NCORES-1:0][P.XLEN/8-1:0] CoreHWSTRB;
  logic [NCORES-1:0] CoreHWRITE, CoreHMASTLOCK, CoreHREADY, CoreHRESP, CoreSCFail;
  logic [NCORES-1:0][2:0] CoreHSIZE, CoreHBURST;
  logic [NCORES-1:0][3:0] CoreHPROT;
  logic [NCORES-1:0][1:0] CoreHTRANS, CoreHTRANSOut, CoreHATOMIC;
  logic [NCORES-1:0][3:0] CoreCacheEvents;
  logic [NCORES-1:0][2*P.XLEN+13:0] CoreITrace;   // instruction trace of each hart (TRACE_SUPPORTED)

  // Preserve the upstream no-bus outputs; bus-enabled harts share clock/reset.
  assign HCLK = P.BUS_SUPPORTED ? clk : 1'b0;
  assign HRESETn = P.BUS_SUPPORTED ? ~reset : 1'b0;
  wallypipelinedcore #(.P(P), .HART_ID(0), .SHARED_ATOMICS(NCORES > 1 || SHARED_CACHE)) core(.clk, .reset(CoreReset[0]),
    .SCFail(CoreSCFail[0]), .HATOMIC(CoreHATOMIC[0]),
    .MTimerInt(MTimerInt[0]), .MExtInt(MExtInt[0]), .SExtInt(SExtInt[0]), .MSwInt(MSwInt[0]), .MTIME_CLINT,
    .ExtCacheEvents(CoreCacheEvents[0]), .DebugHaltReq(DebugHaltReq[0]), .DebugResetHaltReq(DebugResetHaltReq[0]),
    .HRDATA(CoreHRDATA[0]), .HREADY(CoreHREADY[0]), .HRESP(CoreHRESP[0]), .HCLK(), .HRESETn(),
    .HADDR(CoreHADDR[0]), .HWDATA(CoreHWDATA[0]), .HWSTRB(CoreHWSTRB[0]),
    .HWRITE(CoreHWRITE[0]), .HSIZE(CoreHSIZE[0]), .HBURST(CoreHBURST[0]), .HPROT(CoreHPROT[0]),
    .HTRANS(CoreHTRANSOut[0]), .HMASTLOCK(CoreHMASTLOCK[0]), .ExternalStall, .ITrace(CoreITrace[0]));

  for (genvar h = 1; h < NCORES; h++) begin : harts
    wallypipelinedcore #(.P(P), .HART_ID(h), .SHARED_ATOMICS(1)) core(.clk, .reset(CoreReset[h]),
      .SCFail(CoreSCFail[h]), .HATOMIC(CoreHATOMIC[h]),
      .MTimerInt(MTimerInt[h]), .MExtInt(MExtInt[h]), .SExtInt(SExtInt[h]), .MSwInt(MSwInt[h]), .MTIME_CLINT,
      .ExtCacheEvents(CoreCacheEvents[h]), .DebugHaltReq(DebugHaltReq[h]), .DebugResetHaltReq(DebugResetHaltReq[h]),
      .HRDATA(CoreHRDATA[h]), .HREADY(CoreHREADY[h]), .HRESP(CoreHRESP[h]), .HCLK(), .HRESETn(),
      .HADDR(CoreHADDR[h]), .HWDATA(CoreHWDATA[h]), .HWSTRB(CoreHWSTRB[h]),
      .HWRITE(CoreHWRITE[h]), .HSIZE(CoreHSIZE[h]), .HBURST(CoreHBURST[h]), .HPROT(CoreHPROT[h]),
      .HTRANS(CoreHTRANSOut[h]), .HMASTLOCK(CoreHMASTLOCK[h]), .ExternalStall, .ITrace(CoreITrace[h]));
  end

  // A hart held in reset by the Debug Module still presents its first fetch: silence it, so
  // that the Debug Module can use the bus (HartReset is 0 without DEBUG_SUPPORTED)
  for (genvar h = 0; h < NCORES; h++) begin : holdharts
    assign CoreHTRANS[h] = HartReset[h] ? 2'b00 : CoreHTRANSOut[h];
  end

  // Memory topology and capability checks are owned by the optional subsystem.
  multicore_memory_system #(.P(P), `CVW_MULTICORE_CONNECT) memory_system(
    .HCLK, .HRESETn, .CoreHADDR, .CoreHWDATA, .CoreHWSTRB, .CoreHWRITE, .CoreHMASTLOCK,
    .CoreHSIZE, .CoreHBURST, .CoreHPROT, .CoreHTRANS, .CoreHATOMIC,
    .CoreSCFail, .CoreHRDATA, .CoreHREADY, .CoreHRESP, .CoreCacheEvents,
    .HADDR(MemHADDR), .HWDATA(MemHWDATA), .HWSTRB(MemHWSTRB), .HWRITE(MemHWRITE), .HSIZE(MemHSIZE),
    .HBURST(MemHBURST), .HPROT(MemHPROT), .HTRANS(MemHTRANS), .HMASTLOCK(MemHMASTLOCK),
    .HRDATA(MemHRDATA), .HREADY(MemHREADY), .HRESP);

  // Instruction trace (TRACE_SUPPORTED, docs/trace.md): an encoder and a RAM sink per hart, whose
  // control registers sit in a window that the uncore does not decode; they supply the read data
  // of a transfer there
  logic [P.AHBW-1:0] UncoreHRDATA;
  // The port of the trace sink to the uncore RAM (TRACE_IN_RAM), which is idle otherwise
  logic                                 TrReq, TrWe, TrGrant;
  logic [3:0]                           TrBwe;
  logic [$clog2(P.TRACE_RAM_WORDS)-1:0] TrAddr;
  logic [31:0]                          TrDin, TrDout;
  if (P.TRACE_SUPPORTED & P.BUS_SUPPORTED) begin : etracegen
    logic              TraceHSEL;
    logic [P.AHBW-1:0] TraceHRDATA;
    etrace #(.P(P), .NHARTS(NCORES)) etrace(.clk, .reset(PowerOnReset), .ITrace(CoreITrace), .HADDR, .HTRANS, .HWRITE,
      .HREADY, .HWDATA, .TraceHSEL, .TraceHRDATA, .TrReq, .TrWe, .TrBwe, .TrAddr, .TrDin, .TrGrant, .TrDout);
    assign HRDATA = TraceHSEL ? TraceHRDATA : UncoreHRDATA;
  end else begin : noetrace
    assign HRDATA = UncoreHRDATA;
    assign {TrReq, TrWe, TrBwe, TrAddr, TrDin} = '0;
  end

  // instantiate uncore if a bus interface exists
  if (P.BUS_SUPPORTED) begin : uncoregen
    uncore #(.P(P), .NCORES(NCORES)) uncore(.HCLK, .HRESETn,
      .HADDR, .HWDATA, .HWSTRB, .HWRITE, .HSIZE, .HBURST, .HPROT, .HTRANS, .HMASTLOCK, .HRDATAEXT,
      .HREADYEXT, .HRESPEXT, .HRDATA(UncoreHRDATA), .HREADY, .HRESP, .HSELEXT,
      .MTimerInt, .MSwInt, .MExtInt, .SExtInt, .GPIOIN, .GPIOOUT, .GPIOEN, .UARTSin,
      .UARTSout, .MTIME_CLINT, .SPIIn, .SPIOut, .SPICS, .SPICLK, .SDCIn, .SDCCmd, .SDCCS, .SDCCLK, .PWMGPIO, .WDTReset,
      .TrReq, .TrWe, .TrBwe, .TrAddr, .TrDin, .TrGrant, .TrDout);
  end else begin
    assign {UncoreHRDATA, HREADY, HRESP, HSELEXT, MTimerInt, MSwInt, MExtInt, SExtInt,
            MTIME_CLINT, GPIOOUT, GPIOEN, UARTSout, SPIOut, SPICS, SPICLK, SDCCmd, SDCCS, SDCCLK, PWMGPIO, WDTReset,
            TrGrant, TrDout} = '0;
  end

endmodule
