antoniofloresgil/cvw/src/privileged/trap.sv

///////////////////////////////////////////
// trap.sv
//
// Written:  David Harris David_Harris@hmc.edu 9 January 2021
// Modified: Domenico Ottolia dottolia@hmc.edu, Rose Thompson, Ben Bracker, Jinghe Yu, Kip Macsai-Goren, Thomas Fleming
//
// Purpose: Exception and interrupt prioritization.
//
// Documentation: RISC-V System on Chip Design
//
// A component of the CORE-V-WALLY configurable RISC-V project.
// https://github.com/openhwfoundation/cvw
//
// Copyright (C) 2021-26 Harvey Mudd College & Oklahoma State University
//
// SPDX-License-Identifier: Apache-2.0 WITH SHL-2.1
////////////////////////////////////////////////////////////////////////////////////////////////

module trap import cvw::*; #(parameter cvw_t P) (
  input  logic                 reset,
  input  logic                 InstrMisalignedFaultM, InstrAccessFaultM, HPTWInstrAccessFaultM, HPTWInstrPageFaultM, IllegalInstrFaultM,
  input  logic                 BreakpointFaultM, LoadMisalignedFaultM, StoreAmoMisalignedFaultM,
  input  logic                 LoadAccessFaultM, StoreAmoAccessFaultM, EcallFaultM, InstrPageFaultM,
  input  logic                 LoadPageFaultM, StoreAmoPageFaultM,              // various trap sources
  input  logic                 WaitedM,                                         // wfi in M has waited: it retires before an interrupt
  input  logic [1:0]           PrivilegeModeW,                                  // current privilege mode
  input  logic [13:0]          MIP_REGW, MIE_REGW, MIDELEG_REGW,                // interrupt pending, enabled, and delegate CSRs
  input  logic [15:0]          MEDELEG_REGW,                                    // exception delegation SR
  input  logic                 STATUS_MIE, STATUS_SIE,                          // machine/supervisor interrupt enables
  input  logic                 InstrValidM,                                     // current instruction is valid, not flushed
  input  logic                 CommittedM, CommittedF,                          // LSU/IFU has committed to a bus operation that can't be interrupted
  output logic                 TrapM,                                           // Trap is occurring
  output logic                 InterruptM,                                      // Interrupt is occurring
  output logic                 ExceptionM,                                      // exception is occurring
  output logic                 IntPendingM,                                     // Interrupt is pending, might occur if enabled
  output logic                 DelegateM,                                       // Delegate trap to supervisor handler
  output logic [4:0]           CauseM                                           // trap cause
);

  logic                        MIntGlobalEnM, SIntGlobalEnM;                    // Global interrupt enables
  logic                        Committed;                                       // LSU or IFU has committed to a bus operation that can't be interrupted
  logic                        BothInstrAccessFaultM, BothInstrPageFaultM;      // instruction or HPTW ITLB fill caused an Instruction Access Fault
  logic [13:0]                 PendingIntsM, ValidIntsM, EnabledIntsM;          // interrupts are pending, valid, or enabled

  ///////////////////////////////////////////
  // Determine pending enabled interrupts
  // interrupt if any sources are pending
  // & with a M stage valid bit to avoid interrupting a nonexistent flushed instruction (in the M stage)
  // & with ~CommittedM to make sure MEPC isn't chosen so as to rerun the same instr twice
  ///////////////////////////////////////////

  assign MIntGlobalEnM = (PrivilegeModeW != P.M_MODE) | STATUS_MIE; // if M ints enabled or lower priv 3.1.9
  assign SIntGlobalEnM = (PrivilegeModeW == P.U_MODE) | ((PrivilegeModeW == P.S_MODE) & STATUS_SIE); // if in lower priv mode, or if S ints enabled and not in higher priv mode 3.1.9
  assign PendingIntsM  = MIP_REGW & MIE_REGW;
  assign IntPendingM   = |PendingIntsM;
  assign Committed     = CommittedM | CommittedF; // exclusion-tag: trap-committed
  assign EnabledIntsM  = (MIntGlobalEnM ? PendingIntsM & ~MIDELEG_REGW : '0) | (SIntGlobalEnM ? PendingIntsM & MIDELEG_REGW : '0);
  // Suppress interrupts if the memory system has partially processed a request, or if a wfi
  // in M has waited: it then retires and the interrupt is taken on the next instruction (mepc = pc + 4).
  // Gating ValidIntsM rather than InterruptM keeps CauseM consistent when the wait ends in an exception.
  assign ValidIntsM    = (Committed | WaitedM) ? '0 : EnabledIntsM;
  assign InterruptM    = (|ValidIntsM) & InstrValidM;
  assign DelegateM     = P.S_SUPPORTED & (InterruptM ? MIDELEG_REGW[CauseM[3:0]] : MEDELEG_REGW[CauseM[3:0]]) &
                         (PrivilegeModeW == P.U_MODE | PrivilegeModeW == P.S_MODE);

  ///////////////////////////////////////////
  // Trigger Traps
  // According to RISC-V Spec Section 1.6, exceptions are caused by instructions.  Interrupts are external asynchronous.
  // Traps are the union of exceptions and interrupts.
  ///////////////////////////////////////////

  assign BothInstrAccessFaultM = InstrAccessFaultM | HPTWInstrAccessFaultM;
  assign BothInstrPageFaultM = InstrPageFaultM | HPTWInstrPageFaultM;
  // coverage off -item e 1 -fecexprrow 2
  // excludes InstrMisalignedFaultM from coverage of this line, since misaligned instructions cannot occur in rv64gc.
  assign ExceptionM = InstrMisalignedFaultM | BothInstrAccessFaultM | IllegalInstrFaultM |
                      LoadMisalignedFaultM | StoreAmoMisalignedFaultM |
                      BothInstrPageFaultM | LoadPageFaultM | StoreAmoPageFaultM |
                      BreakpointFaultM | EcallFaultM |
                      LoadAccessFaultM | StoreAmoAccessFaultM;
  // coverage on
  // An exception waits, like an interrupt, while the IFU has a committed I$ fill or bus fetch (CommittedF):
  // trapping would flush the fetch partway through its AHB transaction (issues #412, #845).  Only the LSU
  // can raise an exception after the fetch commits (a page table walk fault, a fault found once the walk
  // fills the DTLB, or a fault on the second half of a misaligned access); any other exception is present
  // before the fetch commits and traps then.  The wait is safe: CommittedF implies IFUStallF, so the instruction stays in M;
  // its own access is squashed (lsu.sv SelfFaultM), a misaligned access does not start its spill (align.sv
  // DataFaultM), and the walker holds its fault (hptw.sv FAULT) until the trap is taken.
  assign TrapM = (ExceptionM & ~CommittedF) | InterruptM; // exclusion-tag: trap-trapm

  ///////////////////////////////////////////
  // Cause priority defined in privileged spec
  ///////////////////////////////////////////

  always_comb
    if      (reset)                                           CauseM = 5'd0; // hard reset 3.3
    else if (ValidIntsM[11])                                  CauseM = 5'd11; // Machine External Int
    else if (ValidIntsM[3])                                   CauseM = 5'd3;  // Machine Sw Int
    else if (ValidIntsM[7])                                   CauseM = 5'd7;  // Machine Timer Int
    // if any of the interrupts are delegated to S mode they would be moved to lower priority than the undelegated ones
    else if (~MIDELEG_REGW[9] & ValidIntsM[9])                CauseM = 5'd9;  // not delegated Supervisor External Int // exclusion-tag: trap-sint-start
    else if (~MIDELEG_REGW[1] & ValidIntsM[1])                CauseM = 5'd1;  // not delegated Supervisor Sw Int
    else if (~MIDELEG_REGW[5] & ValidIntsM[5])                CauseM = 5'd5;  // not delegated Supervisor Timer Int
    else if (~MIDELEG_REGW[13] & ValidIntsM[13])              CauseM = 5'd13; // not delegated counter overflow
    else if (ValidIntsM[9])                                   CauseM = 5'd9;  // delegated Supervisor External Int
    else if (ValidIntsM[1])                                   CauseM = 5'd1;  // delegated Supervisor Sw Int
    else if (ValidIntsM[5])                                   CauseM = 5'd5;  // delegated Supervisor Timer Int
    else if (ValidIntsM[13])                                  CauseM = 5'd13; // delegated counter overflow // exclusion-tag: trap-sint-end
    else if (BothInstrPageFaultM)                             CauseM = 5'd12; // Instruction page fault // exclusion-tag: trap-instr-page-fault
    else if (BothInstrAccessFaultM)                           CauseM = 5'd1;  // Instruction access fault
    else if (IllegalInstrFaultM)                              CauseM = 5'd2;  // Illegal instruction
    // coverage off
    // Misaligned instructions cannot occur in rv64gc
    else if (InstrMisalignedFaultM)                           CauseM = 5'd0;  // Instruction address misaligned
    // coverage on
    else if (BreakpointFaultM)                                CauseM = 5'd3;  // Breakpoint
    else if (EcallFaultM)                                     CauseM = {3'b010, PrivilegeModeW}; // Ecall: 8 from U, 9 from S, 11 from M
    else if (StoreAmoMisalignedFaultM & ~P.ZICCLSM_SUPPORTED) CauseM = 5'd6;  // misaligned faults are higher priority if they always are taken
    else if (LoadMisalignedFaultM & ~P.ZICCLSM_SUPPORTED)     CauseM = 5'd4;  // Load address misaligned
    else if (StoreAmoPageFaultM)                              CauseM = 5'd15; // Store/AMO page fault // exclusion-tag: trap-store-page-fault
    else if (LoadPageFaultM)                                  CauseM = 5'd13; // Load page fault // exclusion-tag: trap-load-page-fault
    else if (StoreAmoAccessFaultM)                            CauseM = 5'd7;  // Store/AMO access fault
    else if (LoadAccessFaultM)                                CauseM = 5'd5;  // Load access fault
    else if (StoreAmoMisalignedFaultM & P.ZICCLSM_SUPPORTED)  CauseM = 5'd6; // See priority in Privileged Spec 3.1.15
    else if (LoadMisalignedFaultM & P.ZICCLSM_SUPPORTED)      CauseM = 5'd4;
    else                                                      CauseM = 5'd0;
endmodule
