antoniofloresgil/cvw/src/wally/wallypipelinedcore.sv

///////////////////////////////////////////
// wallypipelinedcore.sv
//
// Written:  David Harris David_Harris@hmc.edu 9 January 2021
// Modified: Rose Thompson, Katherine Parry, Ben Bracker, Thomas Fleming, Kip Macsai-Goren, Lucio
//
// Purpose: Five-stage pipelined RISC-V core.
//
// Documentation: RISC-V System on Chip Design
//
// A component of the CORE-V-WALLY configurable RISC-V project.
// https://github.com/openhwfoundation/cvw
//
// Copyright (C) 2021-26 Harvey Mudd College & Oklahoma State University
//
// SPDX-License-Identifier: Apache-2.0 WITH SHL-2.1
////////////////////////////////////////////////////////////////////////////////////////////////

module wallypipelinedcore import cvw::*; #(parameter cvw_t P, parameter int unsigned HART_ID = 0,
                                        parameter bit SHARED_ATOMICS = 0) (
   input  logic                  clk, reset,
   // Internal shared-memory atomic sideband (unused by legacy single-core SoCs).
   input  logic                  SCFail,
   output logic [1:0]            HATOMIC, // 00 normal, 01 LR, 10 SC, 11 AMO
   // Privileged
   input  logic                  MTimerInt, MExtInt, SExtInt, MSwInt,
   input  logic [63:0]           MTIME_CLINT,
   input  logic                  DebugHaltReq = 1'b0,  // halt request from the Debug Module (DEBUG_SUPPORTED)
   input  logic                  DebugResetHaltReq = 1'b0, // it is resethaltreq's
   // PMU events of caches outside the core: {ICacheMiss, ICacheAccess, DCacheMiss, DCacheAccess}
   input  logic [3:0]            ExtCacheEvents,
   // Bus Interface
   input  logic [P.AHBW-1:0]     HRDATA,
   input  logic                  HREADY, HRESP,
   output logic                  HCLK, HRESETn,
   output logic [P.PA_BITS-1:0]  HADDR,
   output logic [P.AHBW-1:0]     HWDATA,
   output logic [P.XLEN/8-1:0]   HWSTRB,
   output logic                  HWRITE,
   output logic [2:0]            HSIZE,
   output logic [2:0]            HBURST,
   output logic [3:0]            HPROT,
   output logic [1:0]            HTRANS,
   output logic                  HMASTLOCK,
   input  logic                  ExternalStall,
   output logic [2*P.XLEN+13:0]  ITrace         // instruction trace interface (TRACE_SUPPORTED)
);

  logic                          StallF, StallD, StallE, StallM, StallW;
  logic                          FlushD, FlushE, FlushM, FlushW;
  logic                          TrapM, RetM;

  // signals that must connect through DP
  logic                          IntDivE, W64E;
  logic                          CSRReadM, CSRWriteM, PrivilegedM;
  logic [1:0]                    AtomicM;
  logic [P.XLEN-1:0]             ForwardedSrcAE, ForwardedSrcBE;
  logic [P.XLEN-1:0]             SrcAM;
  logic [2:0]                    Funct3E;
  logic [31:0]                   InstrD;
  logic [31:0]                   InstrM, InstrOrigM;
  logic [P.XLEN-1:0]             PCSpillF, PCE, PCLinkE;
  logic [P.XLEN-1:0]             PCM, PCSpillM;
  logic [P.XLEN-1:0]             CSRReadValW, MDUResultW;
  logic [P.XLEN-1:0]             EPCM, TrapVectorM;
  logic [1:0]                    MemRWE;
  logic [1:0]                    MemRWM;
  logic                          InstrValidD, InstrValidE, InstrValidM;
  logic                          InstrMisalignedFaultM;
  logic                          IllegalBaseInstrD, IllegalFPUInstrD, IllegalIEUFPUInstrD;
  logic                          InstrPageFaultF, LoadPageFaultM, StoreAmoPageFaultM;
  logic                          LoadMisalignedFaultM, LoadAccessFaultM;
  logic                          StoreAmoMisalignedFaultM, StoreAmoAccessFaultM;
  logic                          InvalidateICacheM, FlushDCacheM;
  logic                          PCSrcE;
  logic                          CSRWriteFenceM;
  logic                          DivBusyE;
  logic                          StructuralStallD;
  logic                          LoadStallD;
  logic                          StoreStallD;
  logic                          SquashSCW;
  logic [1:0]                    LSUAtomicOp;
  logic                          MDUActiveE;                      // Mul/Div instruction being executed
  logic                          ENVCFG_ADUE;                     // HPTW A/D Update enable
  logic                          ENVCFG_PBMTE;                    // Page-based memory type enable
  logic [3:0]                    ENVCFG_CBE;                      // Cache Block operation enables
  logic [3:0]                    CMOpM;                           // 1: cbo.inval; 2: cbo.clean; 4: cbo.flush; 8: cbo.zero
  logic                          IFUPrefetchE, LSUPrefetchM;      // instruction / data prefetch hints

  // floating point unit signals
  logic [2:0]                    FRM_REGW;
  logic [4:0]                    RdE, RdM, RdW;
  logic                          FPUStallD;
  logic                          FWriteIntE;
  logic [P.FLEN-1:0]             FWriteDataM;
  logic [P.XLEN-1:0]             FIntResM;
  logic [P.XLEN-1:0]             FCvtIntResW;
  logic                          FCvtIntW;
  logic                          FDivBusyE;
  logic                          FRegWriteM;
  logic                          FpLoadStoreM;
  logic [4:0]                    SetFflagsM;
  logic [P.XLEN-1:0]             FIntDivResultW;

  // memory management unit signals
  logic                          ITLBWriteF;
  logic                          ITLBMissOrUpdateAF;
  logic [P.XLEN-1:0]             SATP_REGW;
  logic                          STATUS_MXR, STATUS_SUM, STATUS_MPRV;
  logic [1:0]                    STATUS_MPP, STATUS_FS;
  logic [1:0]                    PrivilegeModeW;
  logic                          DebugMode;          // the hart is in Debug Mode (DEBUG_SUPPORTED)
  logic [P.XLEN-1:0]             PTE;
  logic [2:0]                    PageType;
  logic                          sfencevmaM, sfencevmaAllM;
  logic                          SelHPTW;

  // PMA checker signals
  /* verilator lint_off UNDRIVEN */ // these signals are undriven in configurations without a privileged unit
  var logic [P.PA_BITS-3:0]      PMPADDR_ARRAY_REGW[P.PMP_ENTRIES-1:0];
  var logic [7:0]                PMPCFG_ARRAY_REGW[P.PMP_ENTRIES-1:0];
  /* verilator lint_on UNDRIVEN */

  // IMem stalls
  logic                          IFUStallF;
  logic                          LSUStallM;

  // cpu lsu interface
  logic [2:0]                    Funct3M;
  logic [P.XLEN-1:0]             IEUAdrE;
  logic [P.XLEN-1:0]             WriteDataM;
  logic [P.XLEN-1:0]             IEUAdrM;
  logic [P.XLEN-1:0]             IEUAdrxTvalM;
  logic [P.LLEN-1:0]             ReadDataW;
  logic                          CommittedM;

  // AHB ifu interface
  logic [P.PA_BITS-1:0]          IFUHADDR;
  logic [2:0]                    IFUHBURST;
  logic [1:0]                    IFUHTRANS;
  logic [2:0]                    IFUHSIZE;
  logic                          IFUHWRITE;
  logic                          IFUHREADY;

  // AHB LSU interface
  logic [P.PA_BITS-1:0]          LSUHADDR;
  logic [P.XLEN-1:0]             LSUHWDATA;
  logic [P.XLEN/8-1:0]           LSUHWSTRB;
  logic                          LSUHWRITE;
  logic                          LSUHREADY;

  logic                          BPWrongE, BPWrongM, BPRedirectD;
  logic                          BPDirWrongM;
  logic                          BTAWrongM;
  logic                          RASPredPCWrongM;
  logic                          IClassWrongM;
  logic [3:0]                    IClassM;
  logic                          InstrAccessFaultF, HPTWInstrAccessFaultF, HPTWInstrPageFaultF;
  logic                          HPTWInstrAccessFaultHeldF, HPTWInstrPageFaultHeldF;
  logic [2:0]                    LSUHSIZE;
  logic [2:0]                    LSUHBURST;
  logic [1:0]                    LSUHTRANS;

  logic                          DCacheMiss;
  logic                          DCacheAccess;
  logic                          ICacheMiss;
  logic                          ICacheAccess;
  logic                          BigEndianM;
  logic                          FCvtIntE;
  logic                          CommittedF;
  logic                          BranchD, BranchE, JumpD, JumpE;
  logic                          DCacheStallM, ICacheStallF;
  logic                          WaitM;                           // wfi is waiting for an interrupt

  // instruction fetch unit: PC, branch prediction, instruction cache
  ifu #(P) ifu(.clk, .reset,
    .StallF, .StallD, .StallE, .StallM, .StallW, .FlushD, .FlushE, .FlushM, .FlushW,
    .InstrValidE, .InstrValidD,
    .BranchD, .BranchE, .JumpD, .JumpE, .ICacheStallF,
    // Fetch
    .HRDATA, .PCSpillF, .IFUHADDR,
    .IFUStallF, .IFUHBURST, .IFUHTRANS, .IFUHSIZE, .IFUHREADY, .IFUHWRITE,
    .ICacheAccess, .ICacheMiss,
    // Execute
    .PCLinkE, .PCSrcE, .IEUAdrE, .IEUAdrM, .PCE, .BPWrongE, .BPRedirectD, .BPWrongM,
    // Mem
    .CommittedF, .EPCM, .TrapVectorM, .RetM, .TrapM, .InvalidateICacheM, .CSRWriteFenceM,
    .InstrD, .InstrM, .InstrOrigM, .PCM, .PCSpillM, .IClassM, .BPDirWrongM,
    .BTAWrongM, .RASPredPCWrongM, .IClassWrongM,
    // Faults out
    .IllegalBaseInstrD, .IllegalFPUInstrD, .InstrPageFaultF, .IllegalIEUFPUInstrD, .InstrMisalignedFaultM,
    // mmu management
    .PrivilegeModeW, .DebugMode, .PTE, .PageType, .SATP_REGW, .STATUS_MXR, .STATUS_SUM, .STATUS_MPRV,
    .STATUS_MPP, .ENVCFG_PBMTE, .ENVCFG_ADUE, .ITLBWriteF, .sfencevmaM, .sfencevmaAllM, .ITLBMissOrUpdateAF,
    .HPTWInstrAccessFaultF, .HPTWInstrPageFaultF, .HPTWInstrAccessFaultHeldF, .HPTWInstrPageFaultHeldF,
    // pmp/pma (inside mmu) signals.
    .PMPCFG_ARRAY_REGW, .PMPADDR_ARRAY_REGW, .InstrAccessFaultF);

  // integer execution unit: integer register file, datapath and controller
  ieu #(P) ieu(.clk, .reset,
    // Decode Stage interface
    .InstrD, .STATUS_FS, .ENVCFG_CBE, .IllegalIEUFPUInstrD, .IllegalBaseInstrD,
    // Execute Stage interface
    .PCE, .PCLinkE, .FWriteIntE, .FCvtIntE, .IEUAdrE, .IntDivE, .W64E,
    .Funct3E, .ForwardedSrcAE, .ForwardedSrcBE, .MDUActiveE, .CMOpM, .IFUPrefetchE, .LSUPrefetchM,
    // Memory stage interface
    .SquashSCW,  // from LSU
    .MemRWE,     // read/write control goes to LSU
    .MemRWM,     // read/write control goes to LSU
    .AtomicM,    // atomic control goes to LSU
    .WriteDataM, // Write data to LSU
    .Funct3M,    // size and signedness to LSU
    .SrcAM,      // to privilege and fpu
    .RdE, .RdM, .FIntResM, .FlushDCacheM,
    .BranchD, .BranchE, .JumpD, .JumpE,
    // Writeback stage
    .CSRReadValW, .MDUResultW, .FIntDivResultW, .RdW, .ReadDataW(ReadDataW[P.XLEN-1:0]),
    .InstrValidM, .InstrValidE, .InstrValidD, .FCvtIntResW, .FCvtIntW,
    // hazards
    .StallD, .StallE, .StallM, .StallW, .FlushD, .FlushE, .FlushM, .FlushW,
    .StructuralStallD, .LoadStallD, .StoreStallD, .PCSrcE,
    .CSRReadM, .CSRWriteM, .PrivilegedM, .CSRWriteFenceM, .InvalidateICacheM);

  lsu #(.P(P), .SHARED_ATOMICS(SHARED_ATOMICS)) lsu(
    .clk, .reset, .StallM, .FlushM, .StallW, .FlushW, .CommittedF,
    // CPU interface
    .SCFail, .LSUAtomicOp,
    .MemRWE, .MemRWM, .Funct3M, .Funct7M(InstrM[31:25]), .AtomicM,
    .CommittedM, .DCacheMiss, .DCacheAccess, .SquashSCW,
    .FpLoadStoreM, .FWriteDataM, .IEUAdrE, .IEUAdrM, .WriteDataM,
    .ReadDataW, .FlushDCacheM, .CMOpM, .LSUPrefetchM,
    // connected to ahb (all stay the same)
    .LSUHADDR, .HRDATA, .LSUHWDATA, .LSUHWSTRB, .LSUHSIZE,
    .LSUHBURST, .LSUHTRANS, .LSUHWRITE, .LSUHREADY,
    // connect to csr or privilege and stay the same.
    .PrivilegeModeW, .DebugMode, .BigEndianM, // connects to csr
    .PMPCFG_ARRAY_REGW,           // connects to csr
    .PMPADDR_ARRAY_REGW,          // connects to csr
    // hptw keep i/o
    .SATP_REGW,                   // from csr
    .STATUS_MXR,                  // from csr
    .STATUS_SUM,                  // from csr
    .STATUS_MPRV,                 // from csr
    .STATUS_MPP,                  // from csr
    .ENVCFG_PBMTE,                // from csr
    .ENVCFG_ADUE,                 // from csr
    .sfencevmaM, .sfencevmaAllM,  // connects to privilege
    .DCacheStallM,                // connects to privilege
    .IEUAdrxTvalM,                // connects to privilege
    .LoadPageFaultM,              // connects to privilege
    .StoreAmoPageFaultM,          // connects to privilege
    .LoadMisalignedFaultM,        // connects to privilege
    .LoadAccessFaultM,            // connects to privilege
    .HPTWInstrAccessFaultF,       // connects to privilege
    .HPTWInstrPageFaultF,         // connects to privilege
    .StoreAmoMisalignedFaultM,    // connects to privilege
    .StoreAmoAccessFaultM,        // connects to privilege
    .PCSpillF, .ITLBMissOrUpdateAF, .PTE, .PageType, .ITLBWriteF, .SelHPTW,
    .LSUStallM);

  if (P.BUS_SUPPORTED) begin : ebu
    ebu #(P) ebu(
      .clk, .reset,
      // IFU interface
      .IFUHADDR, .IFUHBURST, .IFUHTRANS, .IFUHREADY, .IFUHSIZE,
      // LSU interface
      .LSUHADDR, .LSUHWDATA, .LSUHWSTRB, .LSUHSIZE, .LSUHBURST,
      .LSUHTRANS, .LSUHWRITE, .LSUHREADY, .LSUAtomicOp, .HATOMIC,
      // BUS interface
      .HREADY, .HRESP, .HCLK, .HRESETn,
      .HADDR, .HWDATA, .HWSTRB, .HWRITE, .HSIZE, .HBURST,
      .HPROT, .HTRANS, .HMASTLOCK);
  end else begin
    assign {IFUHREADY, LSUHREADY, HCLK, HRESETn, HADDR, HWDATA,
            HWSTRB, HWRITE, HSIZE, HBURST, HPROT, HTRANS, HMASTLOCK, HATOMIC} = '0;
  end

  // global stall and flush control
  hazard hzu(
    .BPWrongE, .BPRedirectD, .CSRWriteFenceM, .RetM, .TrapM,
    .StructuralStallD,
    .LSUStallM, .IFUStallF,
    .FPUStallD, .ExternalStall,
    .DivBusyE, .FDivBusyE,
    .WaitM,
    // Stall & flush outputs
    .StallF, .StallD, .StallE, .StallM, .StallW,
    .FlushD, .FlushE, .FlushM, .FlushW);

  // privileged unit
  if (P.ZICSR_SUPPORTED) begin : priv
    privileged #(.P(P), .HART_ID(HART_ID)) priv(
      .clk, .reset,
      .FlushD, .FlushE, .FlushM, .FlushW, .StallD, .StallE, .StallM, .StallW,
      .CSRReadM, .CSRWriteM, .SrcAM, .PCM, .PCSpillM,
      .InstrM, .InstrOrigM, .CSRReadValW, .EPCM, .TrapVectorM,
      .RetM, .TrapM, .sfencevmaM, .sfencevmaAllM, .InvalidateICacheM, .DCacheStallM, .ICacheStallF,
      .InstrValidM, .CommittedM, .CommittedF,
      .FRegWriteM, .LoadStallD, .StoreStallD,
      .BPDirWrongM, .BTAWrongM, .BPWrongM,
      .RASPredPCWrongM, .IClassWrongM, .DivBusyE, .FDivBusyE,
      .IClassM, .DCacheMiss(DCacheMiss | ExtCacheEvents[1]), .DCacheAccess(DCacheAccess | ExtCacheEvents[0]),
      .ICacheMiss(ICacheMiss | ExtCacheEvents[3]), .ICacheAccess(ICacheAccess | ExtCacheEvents[2]), .PrivilegedM,
      .InstrPageFaultF, .LoadPageFaultM, .StoreAmoPageFaultM,
      .InstrMisalignedFaultM, .IllegalIEUFPUInstrD,
      .LoadMisalignedFaultM, .StoreAmoMisalignedFaultM,
      .MTimerInt, .MExtInt, .SExtInt, .MSwInt,
      .MTIME_CLINT, .IEUAdrxTvalM, .SetFflagsM,
      .InstrAccessFaultF, .HPTWInstrAccessFaultF(HPTWInstrAccessFaultHeldF), .HPTWInstrPageFaultF(HPTWInstrPageFaultHeldF), .LoadAccessFaultM, .StoreAmoAccessFaultM, .SelHPTW, .DebugHaltReq, .DebugResetHaltReq,
      .PrivilegeModeW, .SATP_REGW,
      .STATUS_MXR, .STATUS_SUM, .STATUS_MPRV, .STATUS_MPP, .STATUS_FS,
      .PMPCFG_ARRAY_REGW, .PMPADDR_ARRAY_REGW,
      .FRM_REGW, .ENVCFG_CBE, .ENVCFG_PBMTE, .ENVCFG_ADUE, .WaitM, .BigEndianM, .ITrace, .DebugMode);
  end else begin
    assign ITrace = '0;
    assign DebugMode = 1'b0;
    assign {CSRReadValW, PrivilegeModeW,
            SATP_REGW, STATUS_MXR, STATUS_SUM, STATUS_MPRV, STATUS_MPP, STATUS_FS, FRM_REGW,
            // PMPCFG_ARRAY_REGW, PMPADDR_ARRAY_REGW,
            ENVCFG_CBE, ENVCFG_PBMTE, ENVCFG_ADUE,
            EPCM, TrapVectorM, RetM, TrapM,
            sfencevmaM, sfencevmaAllM, BigEndianM, WaitM} = '0;
  end

  // multiply/divide unit
  if (P.ZMMUL_SUPPORTED) begin : mdu
    mdu #(P) mdu(.clk, .reset, .StallM, .StallW, .FlushE, .FlushM, .FlushW,
      .ForwardedSrcAE, .ForwardedSrcBE,
      .Funct3E, .Funct3M, .IntDivE, .W64E, .MDUActiveE,
      .MDUResultW, .DivBusyE);
  end else begin // no M instructions supported
    assign MDUResultW = '0;
    assign DivBusyE   = 1'b0;
  end

  // floating point unit
  if (P.F_SUPPORTED) begin : fpu
    fpu #(P) fpu(
      .clk, .reset,
      .FRM_REGW,                           // Rounding mode from CSR
      .InstrD,                             // instruction from IFU
      .ReadDataW(ReadDataW[P.FLEN-1:0]),   // Read data from memory
      .ForwardedSrcAE,                     // Integer input being processed (from IEU)
      .StallE, .StallM, .StallW,           // stall signals from HZU
      .FlushE, .FlushM, .FlushW,           // flush signals from HZU
      .RdE, .RdM, .RdW,                    // which FP register to write to (from IEU)
      .STATUS_FS,                          // is floating-point enabled?
      .FRegWriteM,                         // FP register write enable
      .FpLoadStoreM,
      .ForwardedSrcBE,                     // Integer input for intdiv
      .Funct3E, .Funct3M, .IntDivE, .W64E, // Integer flags and functions
      .FPUStallD,                          // Stall the decode stage
      .FWriteIntE, .FCvtIntE,              // integer register write enable, conversion operation
      .FWriteDataM,                        // Data to be written to memory
      .FIntResM,                           // data to be written to integer register
      .FCvtIntResW,                        // fp -> int conversion result to be stored in int register
      .FCvtIntW,                           // fpu result selection
      .FDivBusyE,                          // Is the divide/sqrt unit busy (stall execute stage)
      .IllegalFPUInstrD,                   // Is the instruction an illegal fpu instruction
      .SetFflagsM,                         // FPU flags (to privileged unit)
      .FIntDivResultW);
  end else begin                           // no F_SUPPORTED or D_SUPPORTED; tie outputs low
    assign {FPUStallD, FWriteIntE, FCvtIntE, FIntResM, FCvtIntW, FRegWriteM,
            IllegalFPUInstrD, SetFflagsM, FpLoadStoreM,
            FWriteDataM, FCvtIntResW, FIntDivResultW, FDivBusyE} = '0;
  end

endmodule
