antoniofloresgil/cvw/src/privileged/csr.sv

///////////////////////////////////////////
// csr.sv
//
// Written:  David Harris David_Harris@hmc.edu 9 January 2021
// Modified: Rose Thompson, Ben Bracker, Domenico Ottolia dottolia@hmc.edu, Udeema Shakya, Katherine Parry, Jordan Carlin
//
// Purpose: Control and status registers.
//
// Documentation: RISC-V System on Chip Design
//
// A component of the CORE-V-WALLY configurable RISC-V project.
// https://github.com/openhwfoundation/cvw
//
// Copyright (C) 2021-26 Harvey Mudd College & Oklahoma State University
//
// SPDX-License-Identifier: Apache-2.0 WITH SHL-2.1
////////////////////////////////////////////////////////////////////////////////////////////////

module csr import cvw::*;  #(parameter cvw_t P, parameter int unsigned HART_ID = 0) (
  input  logic                     clk, reset,
  input  logic                     FlushM, FlushW,
  input  logic                     StallE, StallM, StallW,
  input  logic [31:0]              InstrM,                    // current instruction
  input  logic [31:0]              InstrOrigM,                // Original compressed or uncompressed instruction in Memory stage for Illegal Instruction XTVAL
  input  logic [P.XLEN-1:0]        PCM,                       // program counter, next PC going to trap/return logic
  input  logic [P.XLEN-1:0]        PCSpillM,                  // program counter, next PC going to trap/return logic aligned after an instruction spill
  input  logic [P.XLEN-1:0]        SrcAM, IEUAdrxTvalM,       // SrcA and memory address from IEU
  input  logic                     CSRReadM, CSRWriteM,       // read or write CSR
  input  logic                     TrapM,                     // trap is occurring
  input  logic                     mretM, sretM,              // return instruction
  input  logic                     InterruptM,                // interrupt is occurring
  input  logic                     MTimerInt,                 // timer interrupt
  input  logic                     MExtInt, SExtInt,          // external interrupt (from PLIC)
  input  logic                     MSwInt,                    // software interrupt
  input  logic [63:0]              MTIME_CLINT,               // TIME value from CLINT
  input  logic                     InstrValidM,               // current instruction is valid
  input  logic                     FRegWriteM,                // writes to floating point registers change STATUS.FS
  input  logic [4:0]               SetFflagsM,                // Set floating point flag bits in FCSR
  input  logic [1:0]               NextPrivilegeModeM,        // STATUS bits updated based on next privilege mode
  input  logic [1:0]               PrivilegeModeW,            // current privilege mode
  input  logic [4:0]               CauseM,                    // Trap cause
  input  logic                     SelHPTW,                   // hardware page table walker active, so base endianness on supervisor mode
  // inputs for performance counters
  input  logic                     LoadStallD, StoreStallD,
  input  logic                     ICacheStallF,
  input  logic                     DCacheStallM,
  input  logic                     BPDirWrongM,
  input  logic                     BTAWrongM,
  input  logic                     RASPredPCWrongM,
  input  logic                     IClassWrongM,
  input  logic                     BPWrongM,                  // branch predictor is wrong
  input  logic [3:0]               IClassM,
  input  logic                     DCacheMiss,
  input  logic                     DCacheAccess,
  input  logic                     ICacheMiss,
  input  logic                     ICacheAccess,
  input  logic                     sfencevmaM,
  input  logic                     InvalidateICacheM,
  input  logic                     DivBusyE,                  // integer divide busy
  input  logic                     FDivBusyE,                 // floating point divide busy
  // outputs from CSRs
  output logic [1:0]               STATUS_MPP,
  output logic                     STATUS_SPP, STATUS_TSR, STATUS_TVM,
  output logic [15:0]              MEDELEG_REGW,
  output logic [P.XLEN-1:0]        SATP_REGW,
  output logic [13:0]              MIP_REGW, MIE_REGW, MIDELEG_REGW,
  output logic                     STATUS_MIE, STATUS_SIE,
  output logic                     STATUS_MXR, STATUS_SUM, STATUS_MPRV, STATUS_TW,
  output logic [1:0]               STATUS_FS,
  output var logic [7:0]           PMPCFG_ARRAY_REGW[P.PMP_ENTRIES-1:0],
  output var logic [P.PA_BITS-3:0] PMPADDR_ARRAY_REGW[P.PMP_ENTRIES-1:0],
  output logic [2:0]               FRM_REGW,
  output logic [3:0]               ENVCFG_CBE,
  output logic                     ENVCFG_PBMTE,              // Page-based memory type enable
  output logic                     ENVCFG_ADUE,               // HPTW A/D Update enable
  // PC logic output from privileged unit to IFU
  output logic [P.XLEN-1:0]        EPCM,                      // Exception Program counter to IFU PC logic
  output logic [P.XLEN-1:0]        TrapVectorM,               // Trap vector, to IFU PC logic
  //
  output logic [P.XLEN-1:0]        CSRReadValW,               // value read from CSR
  output logic                     IllegalCSRAccessM,         // Illegal CSR access: CSR doesn't exist or is inaccessible at this privilege level
  output logic                     BigEndianM                 // memory access is big-endian based on privilege mode and STATUS register endian fields
);

  localparam MIP = 12'h344;
  localparam SIP = 12'h144;

  logic [P.XLEN-1:0]       CSRMReadValM, CSRSReadValM, CSRUReadValM, CSRCReadValM;
  logic [P.XLEN-1:0]       CSRReadValM;
  logic [P.XLEN-1:0]       CSRSrcM;
  logic [P.XLEN-1:0]       CSRRWM, CSRRSM, CSRRCM;
  logic [P.XLEN-1:0]       CSRWriteValM;
  logic [P.XLEN-1:0]       MSTATUS_REGW, SSTATUS_REGW, MSTATUSH_REGW;
  logic [P.XLEN-1:0]       STVEC_REGW, MTVEC_REGW;
  logic [P.XLEN-1:0]       MEPC_REGW, SEPC_REGW;
  logic [31:0]             MCOUNTINHIBIT_REGW, MCOUNTEREN_REGW, SCOUNTEREN_REGW;
  logic                    WriteMSTATUSM, WriteMSTATUSHM, WriteSSTATUSM;
  logic                    CSRMWriteM, CSRSWriteM, CSRUWriteM;
  logic                    UngatedCSRMWriteM;
  logic                    WriteFRMM, SetOrWriteFFLAGSM;
  logic [P.XLEN-1:0]       UnalignedNextEPCM, NextEPCM, NextXtvalM;
  logic [5:0]              NextCauseM;
  logic [11:0]             CSRAdrM;
  logic                    IllegalCSRCAccessM, IllegalCSRMAccessM, IllegalCSRSAccessM, IllegalCSRUAccessM;
  logic                    InsufficientCSRPrivilegeM;
  logic                    IllegalCSRMWriteReadonlyM;
  logic [P.XLEN-1:0]       CSRReadVal2M;
  logic [13:0]             MIP_REGW_writeable;
  logic                    LCOFIPSetM;
  logic [P.XLEN-1:0]       TVecM, NextFaultXtvalM;
  logic                    MTrapM, STrapM;
  logic                    SelMtvecM;
  logic [P.XLEN-1:0]       TVecAlignedM;
  logic                    InstrValidNotFlushedM;
  logic                    STimerInt;
  logic [63:0]             MENVCFG_REGW;
  logic [P.XLEN-1:0]       SISELECT_REGW;
  logic                    CounterDelegationEnabled;
  logic [P.XLEN-1:0]       SENVCFG_REGW;
  logic                    ENVCFG_STCE; // supervisor timer counter enable
  logic                    ENVCFG_FIOM; // fence implies io (presently not used)

  // only valid unflushed instructions can access CSRs
  assign InstrValidNotFlushedM = InstrValidM & ~StallW & ~FlushW;

  ///////////////////////////////////////////
  // XTVAL: gets value from PC, Instruction, or load/store address (for MTVAL/STVAL)
  ///////////////////////////////////////////

  always_comb
    if (InterruptM)           NextFaultXtvalM = '0;
    else case (CauseM)
      12, 1:                  NextFaultXtvalM = PCSpillM;  // Instruction page/access faults report the faulting half of a spilled fetch // exclusion-tag: xtval-instr-fault
      3:                      NextFaultXtvalM = PCM;       // Breakpoint reports the address of the ebreak itself, not the second half of a spilled fetch
      2:                      NextFaultXtvalM = {{(P.XLEN-32){1'b0}}, InstrOrigM}; // Illegal instruction fault
      0, 4, 6, 13, 15, 5, 7:  NextFaultXtvalM = IEUAdrxTvalM; // Instruction misaligned, Load/Store Misaligned/page/access faults // exclusion-tag: xtval-data-fault
      default:                NextFaultXtvalM = '0; // Ecall, interrupts
    endcase

  ///////////////////////////////////////////
  // Trap Vectoring & Returns; vectored traps must be aligned to 64-byte address boundaries
  ///////////////////////////////////////////

  // Select trap vector from STVEC or MTVEC and word-align
  assign SelMtvecM = (NextPrivilegeModeM == P.M_MODE);
  mux2 #(P.XLEN) tvecmux(STVEC_REGW, MTVEC_REGW, SelMtvecM, TVecM);
  assign TVecAlignedM = {TVecM[P.XLEN-1:2], 2'b00};

  // Support vectored interrupts
  if (P.VECTORED_INTERRUPTS_SUPPORTED) begin : vec
    logic VectoredM;
    logic [P.XLEN-1:0] TVecPlusCauseM;
    assign VectoredM = InterruptM & (TVecM[1:0] == 2'b01);
    assign TVecPlusCauseM = {TVecAlignedM[P.XLEN-1:6], CauseM[3:0], 2'b00}; // 64-byte alignment allows concatenation rather than addition
    mux2 #(P.XLEN) trapvecmux(TVecAlignedM, TVecPlusCauseM, VectoredM, TrapVectorM);
  end else
    assign TrapVectorM = TVecAlignedM; // unvectored interrupt handler can be at any word-aligned address. This is called Sstvecd

  // Trap Returns
  // A trap sets the PC to TrapVector
  // A return sets the PC to MEPC or SEPC
  mux2 #(P.XLEN) epcmux(SEPC_REGW, MEPC_REGW, mretM, EPCM);

  ///////////////////////////////////////////
  // CSRWriteValM
  ///////////////////////////////////////////

  always_comb begin
    // Choose either rs1 or uimm[4:0] as source; funct3[2] = InstrM[14] is 1 for csrrwi/csrrsi/csrrci
    CSRSrcM = InstrM[14] ? {{(P.XLEN-5){1'b0}}, InstrM[19:15]} : SrcAM;

    // CSR set and clear for MIP/SIP should only touch internal state, not interrupt inputs
    if (CSRAdrM == MIP | CSRAdrM == SIP) CSRReadVal2M = {{(P.XLEN-14){1'b0}}, MIP_REGW_writeable};
    else                                 CSRReadVal2M = CSRReadValM;

    // Compute AND/OR modification
    CSRRWM = CSRSrcM;
    CSRRSM = CSRReadVal2M | CSRSrcM;
    CSRRCM = CSRReadVal2M & ~CSRSrcM;
    case (InstrM[13:12]) // funct3[1:0]: 01 = csrrw(i), 10 = csrrs(i), 11 = csrrc(i)
      2'b01:   CSRWriteValM = CSRRWM;
      2'b10:   CSRWriteValM = CSRRSM;
      2'b11:   CSRWriteValM = CSRRCM;
      default: CSRWriteValM = CSRReadValM;
    endcase
  end

  ///////////////////////////////////////////
  // CSR Write values
  ///////////////////////////////////////////

  assign CSRAdrM = InstrM[31:20];
  assign UnalignedNextEPCM = TrapM ? PCM : CSRWriteValM;
  assign NextEPCM = P.ZCA_SUPPORTED ? {UnalignedNextEPCM[P.XLEN-1:1], 1'b0} : {UnalignedNextEPCM[P.XLEN-1:2], 2'b00}; // 3.1.15 alignment
  assign NextCauseM = TrapM ? {InterruptM, CauseM} : {CSRWriteValM[P.XLEN-1], CSRWriteValM[4:0]};
  assign NextXtvalM = TrapM ? NextFaultXtvalM : CSRWriteValM;
  assign UngatedCSRMWriteM = CSRWriteM & (PrivilegeModeW == P.M_MODE);
  assign CSRMWriteM = UngatedCSRMWriteM & InstrValidNotFlushedM;
  assign CSRSWriteM = CSRWriteM & (|PrivilegeModeW) & InstrValidNotFlushedM;
  assign CSRUWriteM = CSRWriteM & InstrValidNotFlushedM;
  // Record the trap only when it is taken, like mstatus and the privilege mode
  assign MTrapM = TrapM & ~StallW & (NextPrivilegeModeM == P.M_MODE);
  assign STrapM = TrapM & ~StallW & (NextPrivilegeModeM == P.S_MODE) & P.S_SUPPORTED;

  ///////////////////////////////////////////
  // CSRs
  ///////////////////////////////////////////

  csri #(P) csri(.clk, .reset,
    .CSRMWriteM, .CSRSWriteM, .CSRWriteValM, .CSRAdrM,
    .MExtInt, .SExtInt, .MTimerInt, .STimerInt, .MSwInt,
    .MIDELEG_REGW, .ENVCFG_STCE, .LCOFIPSetM, .MIP_REGW, .MIE_REGW, .MIP_REGW_writeable);

  csrsr #(P) csrsr(.clk, .reset, .StallW,
    .WriteMSTATUSM, .WriteMSTATUSHM, .WriteSSTATUSM,
    .TrapM, .FRegWriteM, .NextPrivilegeModeM, .PrivilegeModeW,
    .mretM, .sretM, .WriteFRMM, .SetOrWriteFFLAGSM, .CSRWriteValM, .SelHPTW,
    .MSTATUS_REGW, .SSTATUS_REGW, .MSTATUSH_REGW,
    .STATUS_MPP, .STATUS_SPP, .STATUS_TSR, .STATUS_TW,
    .STATUS_MIE, .STATUS_SIE, .STATUS_MXR, .STATUS_SUM, .STATUS_MPRV, .STATUS_TVM,
    .STATUS_FS, .BigEndianM);

  csrm #(.P(P), .HART_ID(HART_ID)) csrm(.clk, .reset,
    .UngatedCSRMWriteM, .CSRMWriteM, .CSRSWriteM, .MTrapM, .CSRAdrM,
    .NextEPCM, .NextCauseM, .NextXtvalM, .MSTATUS_REGW, .MSTATUSH_REGW,
    .CSRWriteValM, .CSRMReadValM, .MTVEC_REGW,
    .MEPC_REGW, .MCOUNTEREN_REGW, .MCOUNTINHIBIT_REGW,
    .MEDELEG_REGW, .MIDELEG_REGW, .PMPCFG_ARRAY_REGW, .PMPADDR_ARRAY_REGW,
    .MIP_REGW, .MIE_REGW, .WriteMSTATUSM, .WriteMSTATUSHM,
    .IllegalCSRMAccessM, .IllegalCSRMWriteReadonlyM,
    .MENVCFG_REGW);

  if (P.S_SUPPORTED) begin : csrs
    logic STCE;
    assign STCE = P.SSTC_SUPPORTED & (PrivilegeModeW == P.M_MODE | (MCOUNTEREN_REGW[1] & ENVCFG_STCE));
    csrs #(P) csrs(.clk, .reset,
      .CSRSWriteM, .STrapM, .CSRAdrM,
      .NextEPCM, .NextCauseM, .NextXtvalM, .SSTATUS_REGW,
      .STATUS_TVM,
      .CSRWriteValM, .PrivilegeModeW,
      .MCOUNTEREN_REGW, .MCOUNTINHIBIT_REGW, .CounterDelegationEnabled, .SISELECT_REGW,
      .CSRSReadValM, .STVEC_REGW, .SEPC_REGW,
      .SCOUNTEREN_REGW,
      .SATP_REGW, .MIP_REGW, .MIE_REGW, .MIDELEG_REGW, .MTIME_CLINT, .STCE,
      .WriteSSTATUSM, .IllegalCSRSAccessM, .STimerInt, .SENVCFG_REGW);
  end else begin
    assign WriteSSTATUSM = 1'b0;
    assign CSRSReadValM = '0;
    assign SEPC_REGW = '0;
    assign STVEC_REGW = '0;
    assign SCOUNTEREN_REGW = '0;
    assign SATP_REGW = '0;
    assign IllegalCSRSAccessM = 1'b1;
    assign STimerInt = '0;
    assign SENVCFG_REGW = '0;
    assign SISELECT_REGW = '0;
  end

  // Floating Point CSRs in User Mode only needed if Floating Point is supported
  if (P.F_SUPPORTED) begin : csru
    csru #(P) csru(.clk, .reset, .InstrValidNotFlushedM,
      .CSRUWriteM, .CSRAdrM, .CSRWriteValM, .STATUS_FS, .CSRUReadValM,
      .SetFflagsM, .FRM_REGW, .WriteFRMM, .SetOrWriteFFLAGSM,
      .IllegalCSRUAccessM);
  end else begin
    assign FRM_REGW = '0;
    assign CSRUReadValM = '0;
    assign IllegalCSRUAccessM = 1'b1;
    assign WriteFRMM = 1'b0;
    assign SetOrWriteFFLAGSM = 1'b0;
  end

  // counters are always instantiated but may read as zero if not supported
  csrc #(P) counters(.clk, .reset, .StallE, .StallM, .StallW, .FlushM,
    .InstrValidNotFlushedM, .LoadStallD, .StoreStallD, .CSRWriteM, .CSRMWriteM, .CSRSWriteM,
    .BPDirWrongM, .BTAWrongM, .RASPredPCWrongM, .IClassWrongM, .BPWrongM,
    .IClassM, .DCacheMiss, .DCacheAccess, .ICacheMiss, .ICacheAccess, .sfencevmaM,
    .InterruptM, .TrapM, .InvalidateICacheM, .ICacheStallF, .DCacheStallM, .DivBusyE, .FDivBusyE,
    .CSRAdrM, .PrivilegeModeW, .CSRWriteValM,
    .MCOUNTINHIBIT_REGW, .MCOUNTEREN_REGW, .SCOUNTEREN_REGW,
    .SISELECT_REGW, .CounterDelegationEnabled,
    .MTIME_CLINT, .CSRCReadValM, .IllegalCSRCAccessM, .LCOFIPSetM);

  // Broadcast appropriate environment configuration based on privilege mode
  assign ENVCFG_STCE  = MENVCFG_REGW[63]; // supervisor timer counter enable
  assign CounterDelegationEnabled = P.SMCDELEG_SUPPORTED & MENVCFG_REGW[60];
  assign ENVCFG_PBMTE = MENVCFG_REGW[62]; // page-based memory types enable
  assign ENVCFG_ADUE  = MENVCFG_REGW[61]; // Hardware A/D Update enable
  assign ENVCFG_CBE   = (PrivilegeModeW == P.M_MODE) ? 4'b1111 :
                        (PrivilegeModeW == P.S_MODE | !P.S_SUPPORTED) ? MENVCFG_REGW[7:4] :
                                                                        (MENVCFG_REGW[7:4] & SENVCFG_REGW[7:4]);
  // FIOM presently doesn't do anything because Wally fences don't do anything
  assign ENVCFG_FIOM  = (PrivilegeModeW == P.M_MODE) ? 1'b1 :
                        (PrivilegeModeW == P.S_MODE | !P.S_SUPPORTED) ? MENVCFG_REGW[0] :
                                                                        (MENVCFG_REGW[0] & SENVCFG_REGW[0]);

  // merge CSR Reads
  assign CSRReadValM = CSRUReadValM | CSRSReadValM | CSRMReadValM | CSRCReadValM;
  flopenrc #(P.XLEN) CSRValWReg(clk, reset, FlushW, ~StallW, CSRReadValM, CSRReadValW);

  // merge illegal accesses: illegal if none of the CSR addresses is legal or privilege is insufficient
  // CSRAdrM[9:8] is the lowest privilege mode allowed to access the CSR (00: U, 01: S, 11: M)
  assign InsufficientCSRPrivilegeM = (CSRAdrM[9:8] == 2'b11 & PrivilegeModeW != P.M_MODE) |
                                     (CSRAdrM[9:8] == 2'b01 & PrivilegeModeW == P.U_MODE);
  assign IllegalCSRAccessM = ((IllegalCSRCAccessM & IllegalCSRMAccessM &
    IllegalCSRSAccessM & IllegalCSRUAccessM |
    InsufficientCSRPrivilegeM) & CSRReadM) | IllegalCSRMWriteReadonlyM;
endmodule
