antoniofloresgil/cvw/src/ebu/ahbmsicache.sv

// SPDX-License-Identifier: Apache-2.0 WITH SHL-2.1
// Private, direct-mapped write-back data-cache banks; parameterizable multiword lines.
// The arbiter orders atomics, misses and permission acquisition. Optional local
// read/exclusive-write ports overlap independent traffic; each M write broadcasts a
// commit through the arbiter for reservation and instruction invalidation.
// BusRd: flush M, downgrade a data peer to S; MESI grants E without a peer.
// BusRdX/BusUpgr: flush a modified snooper if any, invalidate peers, take M.
// IFU reads do not allocate, but snoop all banks (including their own hart).
module ahbmsicache import cvw::*; #(
  parameter cvw_t P,
  parameter int unsigned NCORES = 2,
  parameter int unsigned WORDS = 8192/(P.AHBW/8),
  parameter int unsigned LINE_WORDS = 1,
  parameter bit CACHE_TO_CACHE = 0,
  parameter bit CACHE_BURSTS = 0,
  parameter bit MESI = 0,
  parameter int unsigned IFILL_WORDS = 1,
  parameter bit LOCAL_READS = 0,
  parameter bit LOCAL_WRITES = 0
)(
  input  logic HCLK, HRESETn,
  input  logic [NCORES-1:0][P.PA_BITS-1:0] CacheReadAddr,
  output logic [NCORES-1:0] CacheReadHit, CacheWriteHit,
  input  logic [NCORES-1:0] CacheWriteCommit,
  input  logic [NCORES-1:0][P.AHBW-1:0] CacheWriteData,
  input  logic [NCORES-1:0][P.XLEN/8-1:0] CacheWriteStrb,
  output logic [NCORES-1:0][P.AHBW-1:0] CacheReadData,
  output logic [NCORES-1:0] DataMiss,            // PMU: a cacheable data request found no line in its owner's bank
  input  logic [(NCORES > 1 ? $clog2(NCORES) : 1)-1:0] UpHOWNER,
  input  logic [P.PA_BITS-1:0] UpHADDR,
  input  logic [P.AHBW-1:0] UpHWDATA,
  input  logic [P.XLEN/8-1:0] UpHWSTRB,
  input  logic UpHWRITE, UpHMASTLOCK,
  input  logic [2:0] UpHSIZE, UpHBURST,
  input  logic [3:0] UpHPROT,
  input  logic [1:0] UpHTRANS,
  output logic [P.AHBW-1:0] UpHRDATA,
  output logic UpHREADY, UpHRESP,
  output logic [P.PA_BITS-1:0] HADDR,
  output logic [P.AHBW-1:0] HWDATA,
  output logic [P.XLEN/8-1:0] HWSTRB,
  output logic HWRITE, HMASTLOCK,
  output logic [2:0] HSIZE, HBURST,
  output logic [3:0] HPROT,
  output logic [1:0] HTRANS,
  input  logic [P.AHBW-1:0] HRDATA,
  input  logic HREADY, HRESP
);
  localparam OFFSET = $clog2(P.AHBW/8);
  localparam LINE_BITS = $clog2(LINE_WORDS);
  localparam LINE_OFFSET = OFFSET + LINE_BITS;
  localparam N_LINES = WORDS / LINE_WORDS;
  localparam INDEX = $clog2(N_LINES);
  localparam WORD_INDEX = $clog2(WORDS);
  localparam BEAT_BITS = LINE_BITS > 0 ? LINE_BITS : 1;
  localparam TAG = P.PA_BITS - LINE_OFFSET - INDEX;
  localparam HART_BITS = NCORES > 1 ? $clog2(NCORES) : 1;
  typedef enum logic [1:0] {I, S, M, E} msi_t;
  typedef enum logic [3:0] {IDLE, LOOKUP, SNOOP, ADDRESS, DATA, COMPLETE, REPLY, ERROR_REPLY} state_t;
  typedef enum logic [2:0] {EVICT, FLUSH, FILL, BYPASS, IFILL} transfer_t;
  // One independently tagged/stateful data bank per hart, not a shared cache.
  msi_t [NCORES-1:0][N_LINES-1:0] States;
  logic [TAG-1:0] Tags[NCORES][N_LINES];
  state_t State;
  transfer_t Transfer;
  logic [HART_BITS-1:0] Owner, Snooper, FlushOwner, Supplier;
  logic AnyHit, PeerHit;
  logic [P.PA_BITS-1:0] Addr;
  logic [INDEX-1:0] Index;
  logic [TAG-1:0] Tag;
  logic [P.AHBW-1:0] WriteData, FillData;
  logic [P.AHBW-1:0] FillLine[LINE_WORDS];
  logic [BEAT_BITS-1:0] Beat;
  logic [WORD_INDEX-1:0] WordIndex;
  logic [P.XLEN/8-1:0] Strobes;
  logic Write, Filled, Cacheable, DirtyPeer;
  logic [2:0] Size;
  logic [3:0] Prot;
  logic [NCORES-1:0] Hit;

  logic [NCORES-1:0][WORD_INDEX-1:0] LocalWordIndex;
  logic [NCORES-1:0][P.AHBW-1:0] LocalReadData;
  logic [HART_BITS-1:0] WordReadOwner, LineReadOwner;
  logic [P.AHBW-1:0] WordReadData, LineReadData[LINE_WORDS];
  assign WordReadOwner = State == COMPLETE ? Owner : Supplier;
  assign LineReadOwner = State == LOOKUP ? Owner : State == SNOOP ? Snooper :
    Transfer == EVICT ? Owner : FlushOwner;
  for (genvar h = 0; h < NCORES; h++) begin : dataindices
    assign LocalWordIndex[h] = CacheReadAddr[h][OFFSET +: WORD_INDEX];
  end
  multicore_dcache_data #(.P(P), .NCORES(NCORES), .WORDS(WORDS), .LINE_WORDS(LINE_WORDS)) data_bank(
    .HCLK, .HRESETn, .LocalWordIndex, .LocalReadData,
    .WordReadOwner, .WordReadIndex(WordIndex), .WordReadData, .LineReadOwner, .LineReadIndex(Index), .LineReadData,
    .Install(State == COMPLETE && Prot[0] && Filled), .Store(State == COMPLETE && Prot[0] && Write),
    .WriteOwner(Owner), .InstallIndex(Index), .InstallLine(FillLine),
    .StoreIndex(WordIndex), .StoreData(WriteData), .StoreStrb(Strobes),
    .LocalStore(CacheWriteCommit), .LocalStoreData(CacheWriteData), .LocalStoreStrb(CacheWriteStrb));
  // synopsys translate_off
  // Preserve existing passive test probes without exporting arrays as hardware
  // ports. Functional datapaths use only the explicit storage ports above.
  wire [P.AHBW-1:0] Lines[NCORES][WORDS];
  assign Lines = data_bank.Lines;
  // synopsys translate_on

  localparam MAX_WORDS = LINE_WORDS > IFILL_WORDS ? LINE_WORDS : IFILL_WORDS;
  localparam BC = $clog2(MAX_WORDS+1);
  localparam IO = OFFSET+$clog2(IFILL_WORDS);
  logic [P.PA_BITS-1:0] SAddr, BAddr;
  logic [P.AHBW-1:0] SWData, BWData;
  logic [P.XLEN/8-1:0] SStrb, BStrb;
  logic SWrite, BWrite, BurstDone, BurstError, UseBurst;
  logic [2:0] SSize, BSize, BBurst;
  logic [3:0] SProt, BProt;
  logic [1:0] STrans, BTrans;
  logic [P.AHBW-1:0] BurstReadLine[MAX_WORDS], BurstWriteLine[MAX_WORDS];
  logic IBufferValid, IFillClean;
  logic [P.PA_BITS-1:0] IBufferBase;
  logic [P.AHBW-1:0] IBuffer[IFILL_WORDS];
  logic [P.PA_BITS-1:0] ProbeIAddr;
  always_comb begin
    IFillClean = 1'b1;
    ProbeIAddr = '0;
    // Prefetch IFU words only when the ENTIRE I line is current in RAM.
    // Other D lines in a larger I region may have different dirty owners.
    for (int w = 0; w < IFILL_WORDS; w++) begin
      ProbeIAddr = ((Addr >> IO) << IO) + (P.PA_BITS'(w) << OFFSET);
      for (int h = 0; h < NCORES; h++)
        if (States[h][ProbeIAddr[LINE_OFFSET +: INDEX]] == M &&
            Tags[h][ProbeIAddr[LINE_OFFSET +: INDEX]] == ProbeIAddr[P.PA_BITS-1:LINE_OFFSET+INDEX])
          IFillClean = 1'b0;
    end
  end
  assign UseBurst = CACHE_BURSTS &&
    (Transfer == IFILL || (LINE_WORDS > 1 &&
     (Transfer == EVICT || Transfer == FLUSH || (Transfer == FILL && Prot[0]))));
  for (genvar w = 0; w < MAX_WORDS; w++) begin : writebuffer
    if (w < LINE_WORDS)
      assign BurstWriteLine[w] = LineReadData[w];
    else assign BurstWriteLine[w] = '0;
  end
  if (CACHE_BURSTS && MAX_WORDS > 1) begin : burst
    ahblineburst #(.P(P), .MAX_WORDS(MAX_WORDS)) engine(
      .HCLK, .HRESETn, .Start(UseBurst && State == ADDRESS), .Write(SWrite), .Base(SAddr),
      .WordCount(BC'(Transfer == IFILL ? IFILL_WORDS : LINE_WORDS)), .Prot(SProt),
      .WriteLine(BurstWriteLine), .ReadLine(BurstReadLine), .Done(BurstDone), .Error(BurstError),
      .HADDR(BAddr), .HWDATA(BWData), .HWSTRB(BStrb), .HWRITE(BWrite), .HSIZE(BSize),
      .HBURST(BBurst), .HPROT(BProt), .HTRANS(BTrans), .HRDATA, .HREADY, .HRESP);
    assign {HADDR, HWDATA, HWSTRB, HWRITE, HSIZE, HBURST, HPROT, HTRANS} = UseBurst ?
      {BAddr, BWData, BStrb, BWrite, BSize, BBurst, BProt, BTrans} :
      {SAddr, SWData, SStrb, SWrite, SSize, 3'b000, SProt, STrans};
  end else begin : scalar
    assign {HADDR, HWDATA, HWSTRB, HWRITE, HSIZE, HBURST, HPROT, HTRANS} =
      {SAddr, SWData, SStrb, SWrite, SSize, 3'b000, SProt, STrans};
    assign {BAddr, BWData, BStrb, BWrite, BSize, BBurst, BProt, BTrans, BurstDone, BurstError} = '0;
    for (genvar w = 0; w < MAX_WORDS; w++) assign BurstReadLine[w] = '0;
  end

  if (LOCAL_READS || LOCAL_WRITES) begin : readprobes
    logic [NCORES-1:0] ProbeHit;
    always_comb begin
      for (int h = 0; h < NCORES; h++) begin
        ProbeHit[h] = HRESETn &&
          multicore_cacheable(P, 64'(CacheReadAddr[h])) &&
          States[h][CacheReadAddr[h][LINE_OFFSET +: INDEX]] != I &&
          Tags[h][CacheReadAddr[h][LINE_OFFSET +: INDEX]] == CacheReadAddr[h][P.PA_BITS-1:LINE_OFFSET+INDEX];
        CacheReadHit[h] = LOCAL_READS && ProbeHit[h];
        CacheReadData[h] = LOCAL_READS ? LocalReadData[h] : '0;
        CacheWriteHit[h] = LOCAL_WRITES && ProbeHit[h] &&
          (States[h][CacheReadAddr[h][LINE_OFFSET +: INDEX]] == M ||
           (MESI && States[h][CacheReadAddr[h][LINE_OFFSET +: INDEX]] == E));
      end
    end
  end else begin : noreadprobes
    assign CacheReadHit = '0;
    assign CacheWriteHit = '0;
    assign CacheReadData = '0;
  end

  assign Index = Addr[LINE_OFFSET +: INDEX];
  assign WordIndex = Addr[OFFSET +: WORD_INDEX];
  assign Tag = Addr[P.PA_BITS-1:LINE_OFFSET+INDEX];
  assign Cacheable = multicore_cacheable(P, 64'(Addr));
  always_comb begin
    DirtyPeer = 1'b0;
    AnyHit = 1'b0;
    PeerHit = 1'b0;
    Supplier = '0;
    Snooper = '0;
    for (int h = 0; h < NCORES; h++) begin
      Hit[h] = States[h][Index] != I && Tags[h][Index] == Tag;
      if (Hit[h] && HART_BITS'(h) != Owner) PeerHit = 1'b1;
      if (Hit[h] && !AnyHit) begin
        AnyHit = 1'b1;
        Supplier = HART_BITS'(h);
      end
      // An uncached instruction fetch must also snoop its own D-cache.
      if (Hit[h] && States[h][Index] == M && (HART_BITS'(h) != Owner || !Prot[0])) begin
        DirtyPeer = 1'b1;
        Snooper = HART_BITS'(h);
      end
    end
  end
  // Count the miss once, at lookup; a permission upgrade of a present line is a hit.
  always_comb begin
    DataMiss = '0;
    if (State == LOOKUP && Cacheable && Prot[0] && !Hit[Owner]) DataMiss[Owner] = 1'b1;
  end

  assign UpHREADY = HRESETn && (State == IDLE || State == REPLY);
  assign STrans = HRESETn && State == ADDRESS ? 2'b10 : 2'b00;

  assign HMASTLOCK = UpHMASTLOCK;
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
