antoniofloresgil/cvw/src/ebu/ahbmsifabric.sv

// SPDX-License-Identifier: Apache-2.0 WITH SHL-2.1
// Independent address-home MSI engines sharing one physical AHB port.
// One blocking request per hart; distinct banks may have active coherence
// transactions concurrently. A home owns all I/D aliases of its region.
module ahbmsifabric import cvw::*; #(
  parameter cvw_t P,
  parameter int unsigned NCORES = 2,
  parameter int unsigned BANKS = 2,
  parameter int unsigned DCACHE_WORDS = 8192/(P.AHBW/8),
  parameter int unsigned DCACHE_LINE_WORDS = 1,
  parameter bit PRIVATE_ICACHE = 0,
  parameter int unsigned ICACHE_WORDS = 8192/(P.AHBW/8),
  parameter int unsigned ICACHE_LINE_WORDS = 1,
  parameter bit CACHE_TO_CACHE = 0,
  parameter bit CACHE_BURSTS = 0,
  parameter bit MESI = 0,
  parameter bit LOCAL_DCACHE_READS = 0,
  parameter bit LOCAL_DCACHE_WRITES = 0
)(
  input logic HCLK, HRESETn,
  input logic [NCORES-1:0][P.PA_BITS-1:0] CoreHADDR,
  input logic [NCORES-1:0][P.AHBW-1:0] CoreHWDATA,
  input logic [NCORES-1:0][P.XLEN/8-1:0] CoreHWSTRB,
  input logic [NCORES-1:0] CoreHWRITE, CoreHMASTLOCK,
  input logic [NCORES-1:0][2:0] CoreHSIZE, CoreHBURST,
  input logic [NCORES-1:0][3:0] CoreHPROT,
  input logic [NCORES-1:0][1:0] CoreHTRANS, CoreHATOMIC,
  output logic [NCORES-1:0] CoreSCFail, CoreHREADY, CoreHRESP,
  output logic [NCORES-1:0][P.AHBW-1:0] CoreHRDATA,
  output logic [NCORES-1:0] DataMiss, InstrMiss,  // PMU: per-hart misses from every home
  output logic [P.PA_BITS-1:0] HADDR,
  output logic [P.AHBW-1:0] HWDATA,
  output logic [P.XLEN/8-1:0] HWSTRB,
  output logic HWRITE, HMASTLOCK,
  output logic [2:0] HSIZE, HBURST,
  output logic [3:0] HPROT,
  output logic [1:0] HTRANS,
  input logic [P.AHBW-1:0] HRDATA,
  input logic HREADY, HRESP
);
  localparam BB = BANKS > 1 ? $clog2(BANKS) : 1;
  // synopsys translate_off
  corebus_contract #(.P(P), .NCORES(NCORES)) port_contract(
    .HCLK, .HRESETn, .CoreHTRANS, .CoreHATOMIC, .CoreHBURST, .CoreHWRITE, .CoreHMASTLOCK,
    .CoreHREADY, .CoreHRESP, .CoreSCFail, .CoreHWDATA, .CoreHWSTRB, .CoreHRDATA);
  // synopsys translate_on
  localparam HB = NCORES > 1 ? $clog2(NCORES) : 1;
  localparam DW = DCACHE_WORDS/BANKS;
  localparam IW = ICACHE_WORDS/BANKS;
  localparam HOME_OFFSET = $clog2(P.AHBW/8) + $clog2(DW > IW ? DW : IW);
  typedef enum logic [2:0] {AVAILABLE, ISSUE, WAIT_REPLY, REPLY, ERROR_REPLY} state_t;
  state_t State[NCORES];
  logic [NCORES-1:0][BB-1:0] Home;
  logic [NCORES-1:0][P.PA_BITS-1:0] Addr;
  logic [NCORES-1:0][2:0] Size;
  logic [NCORES-1:0][3:0] Prot;
  logic [NCORES-1:0][1:0] Op;
  logic [NCORES-1:0] Write, Dispatch;
  logic [BANKS-1:0][NCORES-1:0][1:0] BTrans;
  logic [BANKS-1:0][NCORES-1:0] BReady, BResp, BSCFail, Clear;
  logic [BANKS-1:0][NCORES-1:0][P.AHBW-1:0] BData;
  logic [BANKS-1:0][NCORES-1:0] BDataMiss, BInstrMiss;
  logic [BANKS-1:0][P.PA_BITS-1:0] MemAddr;
  logic [BANKS-1:0][P.AHBW-1:0] MemWData, MemRData;
  logic [BANKS-1:0][P.XLEN/8-1:0] MemStrb;
  logic [BANKS-1:0] MemWrite, MemReady, MemResp;
  logic [BANKS-1:0][2:0] MemSize, MemBurst;
  logic [BANKS-1:0][3:0] MemProt;
  logic [BANKS-1:0][1:0] MemTrans;
  logic AtomicLock, AnyActive, AtomicPending, AtomicFound;
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
