antoniofloresgil/cvw/(commit log)

2026-10-07 Add open-source FPGA flow with LiteX/LiteDRAM DDR3
    Provide external DDR3 for the Nexys Video from an open (Yosys +
    nextpnr-xilinx) flow, replacing Vivado's encrypted MIG:
    - install Yosys/slang, nextpnr-xilinx, prjxray and openFPGALoader, plus a
    pinned LiteX venv including the service-CPU firmware toolchain
    (fpga-toolchain-install.sh, litex-install.sh, wally-package-install.sh,
    setup.sh, README.md)
    - generate the official LiteDRAM standalone core (VexRiscv service CPU that
    runs the software JEDEC init/leveling) and a minimal wrapper, sharing one
    sys clock with Wally (gen_litedram.py, gen-litedram.sh)
    - bridge Wally's external AHB port to LiteDRAM's Wishbone slave and map DDR3
    at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
2026-10-07 Document future design to run DDR3 bring-up without a service CPU
    Add a TODO section to docs/fpga-opensource-litedram.md describing how the
    VexRiscv service CPU could be removed by having Wally run the LiteDRAM
    software initialization itself:
    - what the standalone core exposes with cpu_type=None (wb_ctrl for CSRs,
    DDR data still on user_port_wally)
    - the bring-up sequence to port (init_sequence + sdram_leveling, all MMIO)
    - where the code would live (Wally's on-chip IROM/DTIM, never DDR)
    - what Wally needs, benefits, and costs/risks
    To be undertaken only once the current service-CPU bring-up blocker is
    resolved and Wally+DDR3 runs on hardware.
2026-10-15 Add DDR3 bring-up diagnostics; DRAM initialization still fails
    Expose LiteDRAM service CPU boot, bus and data-access diagnostics on FPGA LEDs. DRAM initialization is not working on hardware yet.
    [fpgaOpenSource.sv]
2026-10-15 Prepare Nexys Video Linux boot and fix microSD power
    [fpgaTopNexysA7.sv]
2026-10-17 Add configurable multicore SoC with shared-memory atomics
    Add per-hart IDs and interrupts, buffered AHB arbitration, central LR/SC reservations and serialized AMOs. Include uncached configurations, bare-metal concurrency tests and documentation.
    Validated 1, 2 and 3 harts with RAM latencies 0 and 3, legacy configuration lint and pre-commit checks.
2026-10-18 Add shared multicore cache and Linux SMP boot support
    Add an optional unified physical cache after multicore arbitration, with write-through coherence and software PTE A/D updates.
    Provide isolated OpenSBI/Linux SMP image builds, device trees and QEMU/Verilator runners. Verify Linux on two Wally RTL cores, including pinned workers and shared atomic and spinlock-protected counters.
    Validate shared-cache atomics and memory tests on one, two and three harts, UART subword transfers, legacy configurations, lint and pre-commit checks.
2026-10-18 Establish persistent engineering knowledge and decision records
    Preserve existing agent instructions and add a concise knowledge index, maintenance rules, architecture and verification pointers, and a branch-scoped current-work checkpoint.
    Record the implemented multicore cache decision, verified Linux SMP evidence and unresolved open-tool DDR3 bring-up without changing RTL, configurations, tests, build scripts or submodules.
2026-10-20 Add configurable multiword private cache lines and validate Linux SMP
    Add independently parameterized I/D line sizes, full-line MSI ownership,
    fill/writeback sequencing, local-hit hazard guards and Linux geometry identity.
    Preserve the one-word defaults, fixed total capacities and single-core bypass.
    Validation passes: 16 controller cases (32,000 randomized operations),
    30 full-core executions, 20 lint/structural checks, four legacy checks,
    two negative controls, QEMU and checkpoint restoration. The frozen two-hart
    32-byte I/D model completes Linux SMP at 287,836,760 cycles, exit 0, with
    two online CPUs and both shared counters equal to 128.
    Record both preceding one-word Linux PASS result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
    [ahbmsicache.sv, ahbmulticore.sv, build.py, devicetree.py, linux_tb.sv, msi_tb.sv, run.py, soc_tb.sv]
2026-10-20 Add independent MSI coherence homes and validate Linux SMP
    Add configurable address-home controllers sharing one physical AHB port.
    Preserve total per-hart I/D capacity, one-home defaults and single-core bypass.
    Clear per-hart reservations across homes and drain/serialize AMO admission
    while allowing owner instruction fetches through another home.
    Validation: ten banked and two one-home controller cases (24000 random
    operations), 18 full-core runs, 18 lint/structural checks, four legacy checks,
    two negative controls, QEMU and bit-exact checkpoint restoration. Directed
    RV32/RV64 four-hart tests reach four active homes. The independent two-home
    Linux model completes at 457,165,361 cycles, exi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
2026-10-21 Add optional Smcntrpmf fixed counter filtering
    [csrc.sv, csrc_tb.sv, cvw.sv, run.py]
2026-10-21 Fix delegated PMU Linux probe visibility and CI checks
    [delegation_build.py]
2026-10-21 Validate Sscofpmf Linux sampling and privilege filtering
2026-10-21 Centralize multicore profiles and validate RTL/device-tree consistency
2026-10-21 Validate Smcntrpmf fixed-counter filtering in Linux
    [delegation_build.py, run.py, sampling_init.c]
2026-10-22 Scope multicore capabilities and distinguish transport from CPU error recovery
    [bus_fault_guard.sv, check_capabilities.py, ci.py, devicetree.py, fault_guard_tb.sv, linux_tb.sv, run.py]
2026-10-22 test multicore downstream fixture reuse
    [ahb_downstream_checker.sv, check_downstream_checker.py, ci.py, downstream_checker_tb.sv, msi_tb.sv, msifabric_tb.sv, run.py]
2026-10-23 Fix open FPGA Yosys buffer cleanup
    [check_netlist_cleanup.py]
2026-10-29 Fix open FPGA DDR3 by moving to openXC7 nextpnr-xilinx 0.9.8
    The LiteDRAM DDR3 core failed read leveling and memtest when placed and
    routed by the gatecat nextpnr-xilinx build, while the same Yosys netlist
    routed by Vivado worked. openXC7 nextpnr-xilinx 0.9.8 produces a working
    image at both 40 and 80 MHz.
    - Install openXC7 nextpnr-xilinx 0.9.8 and its prjxray-db; drop the
    Boost patch, which is no longer needed.
    - Add a placer patch that keeps negedge FFs out of half-tiles holding
    posedge LUT-RAM, which the FASM writer otherwise rejects.
    - Read sources as one slang compilation unit with fpgaOpenSource.sv
    first so cvw.sv macros are visible, drop --top (rejected by 0.9.8),
    and use XC7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
    [opensource-NexysVideo.xdc]
2026-10-30 Boot Linux on the Nexys Video with the open-source FPGA flow
    Build the rv64gc fpganexysvideo configuration with Yosys/nextpnr-xilinx
    (make nexysvideo FLOW=opensource OPENCONFIG=fpganexysvideo) and boot
    OpenSBI + Linux from the SD card to a BusyBox shell.
    - LiteDRAM: optional separate Wally clock (12.5 MHz PLL output) with a
    CDC native port, and a user port as wide as XLEN.
    - ahbwishbonebridge: parameterized data width; fix dropped beats in
    AHB bursts (the next beat's address phase coincides with the ack).
    - fpgaOpenSource: SD card over SPI, 64-bit Wishbone, Wally clock domain.
    - ZSBL: patch device tree clock-frequency/timebase-frequency to
    SYSTEMCLOCK so an SD card built for the Vivad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
    [ahbwishbonebridge.sv, fpgaOpenSource.sv, gpt.c, lzc.sv, lzctree.sv, opensource-NexysVideo.xdc]
2026-10-30 Fix LiteDRAM shared-clock mode and record RV32 open-flow hardware check
    gen_litedram.py computed the width of Wally's Wishbone address from a
    controller attribute that does not exist, so the default shared-clock
    mode (fpgaopensource) failed to generate. Read the width from the
    generated core's user_port_wally_adr instead, which works in both modes.
    The rebuilt RV32 design (40.7 MHz in nextpnr) passed 973 consecutive
    64 KiB DDR3 write/verify passes on the Nexys Video.
2026-10-30 Update agent instructions and docs for the open FPGA flow
    AGENTS.md: replace stale RISCOF/tests.vh references with the ACT4
    workflow, correct the wsim --fcov note, and add a hardware, FPGA and
    bring-up method (measure first, judge fit after placement, bound long
    commands, pin the P&R engine, separate simulation from hardware proof).
    CLAUDE.md: add an FPGA flows section with the build and programming
    commands and the non-obvious constraints of the open flow.
    README.md and docs/engineering: the open flow now reaches DDR3 and Linux
    on the Nexys Video; scope the results to the verified revisions.
2026-10-31 Track tests/coverage64gc in the multicore workflow paths
    Upstream renamed tests/coverage to tests/coverage64gc, so the push and
    pull_request path filters no longer matched the directory.
2026-10-31 Record the open-flow optimization study and the open ASIC flow as future work
    The study measures why the RV64GC open flow reaches 13 to 15 MHz in nextpnr:
    routing delay dominates, the caches map to LUTRAM, denser placement does not
    help, and the 29 HPM counters cost about 1.7 MHz. No design change is applied.
    Future work records an OpenROAD-based ASIC flow, on its own branch, to complete
    the open flow.
2026-11-01 Fix nextpnr seed 2 for the RV64GC open-flow build
    With the default seed the merged RV64GC netlist does not route: router2
    stalls at 27-36 overused wires for 115 iterations. Seed 2 converges at
    iteration 3 (13.64 MHz estimated against the 12.5 MHz target) and Linux
    boots to the BusyBox login on the Nexys Video. NEXTPNR_SEED overrides it.
2026-11-01 Add --init-cpu to the LiteDRAM generator and plan Wally-run DDR3 init
    gen_litedram.py can now generate the LiteDRAM core without the VexRiscv
    service CPU (--init-cpu none): no CPU, ROM, SRAM, UART or timer, and the
    CSRs exposed as a Wishbone slave. The default (vexriscv) generates the same
    files as before. The plan for letting Wally run the DDR3 initialization,
    the CSR map and the estimated area saving (about 2000 LUT) are documented.
2026-11-01 Wire the LiteDRAM control registers to Wally's external bus (RV32)
    The open-flow top splits Wally's external region into the DDR3 window and,
    in its upper half, a window to the LiteDRAM CSRs (0x48000000 on
    fpgaopensource, whose EXT_MEM_RANGE grows to 256 MiB). The new extbussplit
    module merges the two AHB responses; both sides reuse ahbwishbonebridge.
    With --init-cpu none (INIT_CPU=none) Wally starts at power-up instead of
    waiting for init_done. The generated wrapper has the same ports in both
    modes. Nothing under src/ changes.
    A self-checking Verilator testbench covers the split. Full RV32 synthesis
    without the service CPU uses 2084 fewer LUTs. The RV64 control path is not
    wired: the exter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
2026-11-01 Add ddrinit: DDR3 initialization firmware run by Wally (RV32)
    fpga/ddrinit builds an IROM program for fpgaopensource that runs LiteX's own
    sdram_init() (JEDEC sequence, read leveling, bit-slip), compiled from the
    installed LiteX sources, through the LiteDRAM CSR window at 0x48000000, and
    then repeats a 64 KiB write/verify test of the DDR3. The image is 3.4 KiB.
    The DTIM of fpgaopensource was never preloaded, so IROM programs read their
    constant data as zeros. PreProcessOpenSource now enables the DTIM preload
    with 32-bit words in the staged copy of the sources; src/ is unchanged. The
    same image goes to boot.mem and data.mem.
    Not run yet: there is no simulation model of the DDR3 PHY in this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
    [main.c, printf.c]
2026-11-01 Let Wally initialize the DDR3 on RV32 by default
    On the Nexys Video, the RV32 fpgaopensource build without the LiteDRAM
    service CPU ran LiteX's sdram_init() from Wally's IROM (fpga/ddrinit),
    leveled the DDR3 exactly as the VexRiscv did and passed 1727 64 KiB
    write/verify passes with no errors. The control build with the service CPU
    and the new top also passed. After place and route the change saves 2763
    LUTs, 1407 FFs, 4 RAMB36 and 15 RAMB18.
    build-opensource.sh now picks INIT_CPU=none for RV32 and keeps the service
    CPU for RV64, where the CSR window would be cacheable. ddrinit gains
    SKIP_INIT=1 for builds that keep the service CPU.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
    [main.c]
2026-11-01 Fix the external-bus split on RV64: keep the whole region on DDR3
    The top picked the LiteDRAM CSR window with the top bit of EXT_MEM_RANGE.
    On RV64 (fpganexysvideo) that range is exactly the 512 MiB of DDR3, so the
    bit is a DDR3 address bit and every access from 0x90000000 up went to the
    tied-off control side; the ZSBL lost the device tree and Linux did not boot.
    The select now applies only when the control path exists (32-bit bus).
    With the fix the RV64 build (14.89 MHz) boots OpenSBI and Linux to the
    BusyBox login on the Nexys Video. RV32 is unchanged.
    [fpgaOpenSource.sv]
2026-11-01 Let Wally initialize the DDR3 on RV64 through an uncached EXT_IO window
    Wally's PMA gains an optional EXT_IO window inside EXT_MEM that is not
    cacheable, not idempotent and not atomic (EXT_IO_SUPPORTED/BASE/RANGE, off in
    every base configuration). Bus decoding is unchanged; the FPGA top now selects
    the LiteDRAM control registers with these parameters on RV32 and RV64. The
    regression and lint pass with the window off.
    A new open-flow configuration, fpganexysvideoopen, maps the window at
    0xA0000000 and adds a 16 KiB IROM/DTIM at 0x4000 for stage 0: ddrinit built
    for RV64 initializes the DDR3, tests it and jumps to the unchanged ZSBL.
    fpganexysvideo, shared with Vivado, keeps the service CPU.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
2026-11-01 Count PMU cache events and test per-hart counters on multicore
    With the private multicore caches the core's own I$ and D$ are off, so PMU
    events 13/14 (D$ access/miss) and 16/17 (I$ access/miss) stayed at zero.
    multicore_memory_system now reports per-hart cache events (accepted
    cacheable requests as accesses, coherence-engine lookups and instruction
    line fills as misses) through a new ExtCacheEvents core input, ORed into
    the existing events; it is zero without private caches.
    tests/multicore/pmu.S checks per-hart counters, per-hart event counting,
    Sscofpmf overflow interrupts only on the overflowing hart and, with private
    caches, all four cache events. The multicore CI lints the new
    multico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
2026-11-01 Record the PMU merge and its multicore verification
    adding-mpu-support was merged into main by PR #25 and deleted. Note it in
    the engineering docs, mark the Wally-run DDR3 initialization as merged
    (PR #23), and add the record of the multicore PMU checks: per-hart
    counters, Sscofpmf interrupts and private-cache events with 2 and 3 harts.
2026-11-01 Make the EXT_IO window non-executable and validate its bounds
    Brings the fixes from the upstream review of the EXT_IO PMA window
    (openhwfoundation/cvw#2038, commit 5abb74075) to this fork's version of
    the feature:
    - A fetch from the window now raises a PMA access fault, so the IFU never
    reads an I/O register on the bus, not even on a mispredicted path.
    - Elaboration stops unless the window lies inside EXT_MEM, is a naturally
    aligned power-of-two block and covers at least one line of every
    enabled cache, so no cache line is shared with cacheable memory.
    Adds the window test extIOWindow.S with its derivative extio_rv64gc
    (nightly), now also checking boundaries, misaligned accesses, LR/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
    [pmachecker.sv, testbench.sv]
2026-11-01 Reject an EXT_IO window without Zicsr
    Without Zicsr there is no MMU and no PMA checker, so every access is
    cacheable and executable and the window's bounds check never
    elaborates: EXT_IO_SUPPORTED would be silently ignored. The no-MMU
    branch of the LSU, which always elaborates in that case, now stops
    elaboration, and lint-wally requires the derivative extio_nozicsr_rv32e
    to be rejected.
2026-11-02 Add an open ASIC flow for Wally with LibreLane on IHP SG13G2
    asic/librelane/ generates a wrapper and config.json for one Wally
    configuration and runs LibreLane 3.0.17 (Yosys + slang, OpenROAD, Magic,
    KLayout, Netgen) from RTL to GDS. No Wally RTL changes.
    syn_rv32imc with a 30 ns clock completes with 0 Magic DRC, KLayout DRC,
    LVS and antenna errors and positive setup and hold slack in all corners
    (slow corner +1.34 ns); at 20 ns the slow corner fails by 6.66 ns. The
    results, the checker behaviour and the open issues are recorded in
    docs/engineering/experiments/2026-11-02-open-asic-flow.md.
2026-11-02 Drive the PMP arrays of csrm when PMP_ENTRIES is 0
    With PMP_ENTRIES = 0 the arrays PMPADDR_ARRAY_REGW and PMPCFG_ARRAY_REGW
    have the range [-1:0], and csrm.sv read them without driving them (the
    read mux is never selected). Verilator was silenced with a lint_off, but
    Yosys with the slang frontend reports 80 "used but has no driver" check
    errors (64 PMPADDR bits, 16 PMPCFG bits) on rv32imc, which stops an
    open-tool synthesis flow unless its check is disabled.
    Drive both arrays to zero when there is no PMP, and drop the lint_off.
    Nothing changes with PMP_ENTRIES > 0.
    Checked: lint-wally passes on all configurations; Yosys+slang check on
    syn_rv32imc goes from 80 warnings to 0; rv32imc ACT pri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
    [csrm.sv]
2026-11-02 Move the EXT_IO configuration checks to riscvassertions_wally
    Put the EXT_IO checks (needs Zicsr and EXT_MEM, power-of-two aligned
    window inside EXT_MEM, at least one cache line long) next to the other
    microarchitectural configuration assertions in the testbench, so that
    pmachecker.sv and lsu.sv carry no $fatal code and the Zicsr check no
    longer sits in the no-MMU branch of lsu.sv.
    lint-wally only elaborates wallywrapper, which does not instantiate
    riscvassertions_wally, so the expected-rejection check no longer applies:
    revert lint-wally and drop the two invalid derivatives, like the other
    configuration assertions, none of which has a negative test. An invalid
    window now stops any simulat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
    [lsu.sv, pmachecker.sv]
2026-11-02 Drop the ERROR_ON_SYNTH_CHECKS workaround from the ASIC flow
    csrm.sv now drives its PMP arrays without PMP (PR #28), and the synthesis
    check of syn_rv32imc is clean with ERROR_ON_SYNTH_CHECKS at its default.
2026-11-02 ASIC flow: larger slew repair margins, 30 ns default clock, checker notes
    With DESIGN_REPAIR_MAX_SLEW_PCT 40 and GRT_DESIGN_REPAIR_MAX_SLEW_PCT 30 the
    slow-corner slew violations of syn_rv32imc at 30 ns go from 111 to 2, with the
    same area and 0.42 ns of setup slack in that corner. The timing checkers fail
    only for the corners their wildcards match, which explains the earlier
    "violations found" followed by "No violations found"; document that.
2026-11-02 ASIC flow: make the setup checker fatal in every corner
2026-11-02 ASIC flow: results of the full syn_rv32imc run with fatal setup checker
    Magic and KLayout DRC, LVS and antenna clean; setup slack +0.42 ns in the
    slow corner at 30 ns; 2 slew and 1 cap violations left in the slow corner.
2026-11-02 ASIC flow: IHP SRAM macro for a 4 KiB DTIM (asic_rv32imc)
    sram/ram1p1rwbe.sv puts 1024x32 RAMs in RM_IHPSG13_1P_1024x32_c2_bm_bist
    and uses Wally's ram1p1rwbe, copied by gen_config.py as ram1p1rwbe_generic,
    for every other shape; make sramsim checks it against Wally's RAM with the
    PDK's behavioral model. sramtest/ is a standalone test design.
    The full KLayout deck reports violations inside the IHP SRAM macros
    (IHP-Open-PDK #793): designs with macros make that checker non-fatal and
    check_drc.py fails on anything else and on IHP's precheck rule set. Magic
    DRC is off for them until the PDK has the SRAM exceptions (PR #863).
    asic_rv32imc closes at 30 ns in every corner with LVS clean, in 1.57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
    [RM_IHPSG13_1P_1024x32_c2_bm_bist_bb.v, getenvval.c, ram1p1rwbe.sv, ram1p1rwbe_tb.sv, sramtest.sv]
2026-11-03 ASIC flow: LibreLane 3.1, a first chip with pads, and SG13CMOS5L
    - LibreLane 3.1.0.dev4 with the IHP PDK it pins (89d42ee), which has the
    SRAM rule exceptions for Magic: KLayout DRC is clean on the SRAM macro
    and fatal again; check_drc.py waives only Magic's Cnt.c rules inside the
    macros' bounding boxes, and turns Magic's pad-ring subcell overlaps into
    warnings when KLayout DRC is clean.
    - 40 ns and SYNTH_STRATEGY AREA 0 without SYNTH_ARITH_TREE/MUL_BOOTH for
    every design: with Yosys 0.69 asic_rv32imc misses 30 ns by 6.8 ns, and
    3.1's DELAY 4 default closes it with 50 % more area and power.
    - asic_soc_rv32imc, a chip (chip/): Wally's SoC in a 20-pad IHP ring after
    IHP's LibreLa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
2026-11-03 ASIC flow: chip power with the clock on the pad, Magic filler
    - chip_top.sdc defines the clock on the clock pad's output pin, as IHP's
    template does; OpenSTA gives such a pin no clock activity for power and
    the chip read 1.2 mW. Setting two transitions per period on the pin gives
    21.1 mW, the same as a clock on the port, with the same timing.
    - The chips use IHP's Magic filler instead of the KLayout one: it leaves 5
    minimum-density windows short instead of 15, and the chip keeps KLayout
    DRC 0, LVS 0 and only the known Magic violations.
    - The experiment doc records the chip in SG13CMOS5L (closes at 40 ns,
    12 density violations with the KLayout filler), asic_rv32imc ending clean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
2026-11-03 ASIC flow: chip meets IHP's metal density in SG13G2
    Metal2 straps in channels without cells (FP_OBSTRUCTIONS) and Metal3 straps
    in the chip's core power grid (chip/pdn_cfg.tcl), with the Magic filler: 0
    density violations, routing DRC 0, LVS 0, KLayout DRC 0, setup +3.52 ns in
    the slow corner. Straps over the cells covered pins and the antenna repair
    shorted its diodes to them. The SRAM macro moves to the top left corner.
    Two pads of each supply on opposite sides (24 pads). The asynchronous reset,
    UART receive and GPIO inputs are false paths. check_drc.py also reports as
    warnings the SG13CMOS5L pad-cell rules and the Magic filler's TM1Fil.a
    slivers when KLayout DRC is clean.
    Co-Authored-By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
    [chip_top.sv]
2026-11-04 Debug: JTAG DTM and Debug Module with System Bus Access
    A JTAG debug port after the RISC-V Debug Specification 1.0, behind the new
    DEBUG_SUPPORTED parameter (0 in every base configuration), without changes
    to the core:
    - src/debug/dtm.sv: JTAG TAP (IDCODE, DTMCS, DMI, BYPASS) and the DMI, which
    crosses from TCK to the system clock with a toggle handshake;
    - src/debug/dm.sv: Debug Module for one hart: dmcontrol, dmstatus,
    abstractcs, System Bus Access (8 to 64-bit accesses, auto-increment,
    read on address and data), hartreset (holds the core while the memories
    run) and ndmreset (the SoC except the debug port); the hart cannot halt
    yet, so abstract commands fail with cmderr 2;
    - src/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
    [cvw.sv, linux_tb.sv, pmu_tb.sv, soc_clock_tb.sv, soc_tb.sv, testbench.sv, wallypipelinedsoc.sv, wallywrapper.sv]
2026-11-04 Debug: Debug Mode, execution-based Debug Module, riscv-tests/debug targets
    Phase 1 of the full RISC-V Debug Specification 1.0:
    - src/debug/debugmode.sv: the hart's Debug Mode (dcsr, dpc, dscratch0/1), entry on
    haltreq, single step and ebreak to the debugger, dret. privileged.sv steers the
    existing trap and return paths with it; trap, privmode, privdec and csr are unchanged.
    - src/debug/dm.sv: execution-based Debug Module like PULP riscv-dbg: debug memory at
    0x0-0xFFF (ROM, WHERETO, abstract command, 8-word program buffer, data0/1, flags),
    halt/resume, setresethaltreq, Access Register for GPRs, FPRs and CSRs, postexec,
    aarpostincrement, abstractauto, cmderr 1-4, haltsum0.
    - src/de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
2026-11-04 Debug: dcsr.cause 5 for resethaltreq, wfi as a nop when stepped over
    Phase 2 of the RISC-V Debug Specification 1.0:
    - The Debug Module tells the core when its halt request comes from setresethaltreq
    (DebugResetHaltReq, a core input that defaults to 0), and debugmode reports
    dcsr.cause 5 for it, with the specification's priority: ebreak, resethaltreq,
    haltreq, step.
    - A wfi does not wait while the hart is single-stepping, so the step completes (the
    specification treats it as a nop), as it already did not for a halt request.
    - debug_tb: single steps, a step over wfi, ebreak with dcsr.ebreakm and
    setresethaltreq, checking dcsr.cause and dpc.
    Verified: debug_tb and make openocd on de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
    [privileged.sv, wallypipelinedcore.sv, wallypipelinedsoc.sv]
2026-11-04 Debug: Sdtrig triggers (mcontrol, mcontrol6, icount, itrigger, etrigger)
    Phase 3 of the RISC-V Debug Specification 1.0:
    - src/debug/triggers.sv: DEBUG_TRIGGERS triggers (tselect, tdata1-3, tinfo). Address
    matches on instruction, load and store addresses (equal, NAPOT, >=, <, and the negated
    equal and NAPOT), icount, itrigger and etrigger. A trigger fires before the instruction
    in M at the boundaries of an interrupt, so a matching store does not reach memory; with a
    bus access already under way it fires right after the instruction. action 1 enters Debug
    Mode (dcsr.cause 2); action 0 raises a breakpoint exception. A free trigger reads as
    mcontrol6 with every field 0, because O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
2026-11-04 Debug: several harts (hartsel, per-hart state, haltsum)
    Phase 4 of the RISC-V Debug Specification 1.0:
    - dm.sv serves NHARTS harts (NCORES of the SoC, 1 to 1024). It keeps the state of each hart
    (halted, haltreq, resume, go, reset, havereset, resumeack, resethaltreq); dmcontrol.hartsel
    picks the hart that the dmcontrol bits and the abstract commands concern; dmstatus reports it
    or "nonexistent"; haltsum0 and haltsum1. No hasel.
    - The ROM reports the hart's mhartid in GOING and EXCEPTION as well (27 words, the same for
    RV32 and RV64), so that the DM tells the harts apart.
    - wallypipelinedsoc: a reset and halt request per hart; the bus requests of a hart held in
    reset are silenced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
    [wallypipelinedsoc.sv]
2026-11-04 Trace: E-Trace instruction trace interface, checked against the reference flow
    Step 1 of phase 5 (docs/trace.md): the ingress port of Efficient Trace for RISC-V v2.0.
    - src/debug/etraceingress.sv (TRACE_SUPPORTED, in privileged.sv): one line per retired
    instruction and one per exception or interrupt, itype_width_p 3. A retired instruction waits
    for the next address, which tells a taken branch from a nontaken one with no signal from the
    pipeline. mret and sret are uninferable jumps (itype 6): the reference encoder sends the
    address after an itype 6, not after a 3. The core exports the line as ITrace.
    - TRACE_SUPPORTED: 0 in the base configurations; 1 in debug_rv32imc, debug_rv64gc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
2026-11-04 Debug: the Debug Module's memory is reachable in Debug Mode only
    The hart reached 0x0-0xFFF (the Debug Module's ROM, program buffer, data registers and flags)
    in any mode, so software could run the ROM or disturb a command, and a program that expects an
    access fault at address 0 got an illegal instruction instead (ACT's ExceptionsSm-00 failed on
    debug_rv64gc). Now the PMA checker treats the region as unmapped outside Debug Mode: a fetch,
    load or store there takes an access fault, with mtval the address.
    - privileged.sv outputs DebugMode; the core passes it through the IFU and the LSU to their MMUs
    and the PMA checker. Without DEBUG_SUPPORTED it is 0 and nothing changes.
    - debug_tb: a lo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
    [ifu.sv, lsu.sv, mmu.sv, pmachecker.sv, privileged.sv, wallypipelinedcore.sv]
2026-11-04 docs: ADR 0022, the open-ASIC chip as a microcontroller
    Proposed direction for asic_soc_rv32imc toward a Cortex-M3 class MCU:
    boot from external SPI flash, more SRAM, JTAG debug, APB timers/PWM,
    watchdog, I2C and pin multiplexing, analog functions off chip.
2026-11-04 Trace step 2: E-Trace instruction encoder
    src/debug/etraceencoder.sv: the compressed branch trace algorithm of E-Trace v2.0
    (itype_width_p 3, iaddress_lsb_p 1, differential addresses, no context/time),
    following the specification's reference encoder_model.py step for step: three-line
    pipeline, at most one packet per line, support packets when trace turns on and off,
    pipeline flush, sign-based compression and the te_inst header byte.
    Until the sink exists, testbench.sv instantiates it on hart 0 (trace on while a test
    runs); etracedump.sv also dumps its packets (+EtracePackets=), and etracecheck.py
    --rtl-packets compares them with the reference packet by packet.
    etracetest.S now also covers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
2026-11-04 Trace step 3: RAM sink and Trace Control Interface registers
    Each hart gets an E-Trace encoder and a Trace RAM Sink (SRAM mode) in the
    SoC, controlled through the RISC-V Trace Control Interface v1.0 registers
    at TRACE_BASE + h*0x2000 (encoder) and + 0x1000 (sink). The registers are
    reached through System Bus Access or by the harts' 32-bit loads and stores
    (PMA). The uncore is unchanged: it answers the window as any undecoded
    address and etrace supplies the read data.
    - etracesink: a 4-packet queue, up to 4 bytes per cycle into ram1p1rwbe,
    wrap and StopOnWrap, zero padding on disable, trTeInstStallOrOverflow
    when a packet is dropped (the hart never stalls).
    - New parameters TRACE_RAM_WOR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
    [cvw.sv, etracedump.sv, pmachecker.sv, testbench.sv, wallypipelinedsoc.sv]
2026-11-04 Trace step 4: several harts traced at once
    etrace_tb.sv instantiates the SoC with NHARTS harts (testbench.sv runs one),
    loads etracetest.S into RAM and waits for every hart's result. Every hart
    runs the program at once with its own trace encoder and RAM sink, mtimecmp
    and interrupt flag; hart h runs the first loop h more times so that the
    harts' traces differ. etracedump writes each hart's files with a .h<h>
    suffix, and make check-harts checks every hart against the reference on
    debug_rv32imc and debug_rv64gc_nocache with two harts: byte for byte, with
    RESYNC_MAX 0, 1 and 3.
2026-11-04 docs/debug.md: trace (phase 5) is done
2026-11-04 docs: what is left to do in debug and trace
2026-11-04 Trace: a decoder of our own, and debug/trace tests in the nightly regression
    etracedecode.py (standard library only) decodes the te_inst packets of
    Wally's encoder with the program read from the ELF, following the
    specification's decoder algorithm as the reference decoder_model.py writes
    it. etracecheck.py always runs it on the packets read back from the RAM
    sink and checks the program counters the hart retired; the reference flow
    runs in addition when ETRACE_SPEC names a riscv-trace-spec clone.
    Both decoders reconstruct the same program counters from every trace of
    make check and make check-harts (RV32/RV64, one and two harts, RESYNC_MAX
    0/1/3). A random bit flip fails the check in ~9 of 1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
2026-11-05 ASIC chip: JTAG debug port, triggers and trace, 2.4 mm die
    asic_soc_rv32imc gets DEBUG_SUPPORTED, 4 triggers and TRACE_SUPPORTED. The
    trace buffer is a second SRAM macro (top right of the core); 4 JTAG pads
    (28 pads, 7 per side); TCK is an asynchronous 100 ns clock in the SDC.
    gen_config.py: die 2.4 mm, strap channels stop under both macros, an
    obstruction over the strip right of the last channel (pdngen's thin Metal2
    straps there shorted an antenna diode), PDN_MACRO_CONNECTIONS matches the
    bracketed instance name. cocotb test debug_over_jtag: halt, SBA load, trace,
    resume, halt, decode the trace with etracedecode.py.
    SG13G2 chip: 70,185 cells, 45 % utilization, setup +2.17 ns (slow), hold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
    [chip_tb.sv, chip_top.sv, test_chip.py]
2026-11-05 ASIC chip: 32 KiB RAM, SPI flash boot with UART fallback, 2.6 mm die
    - RAM of asic_soc_rv32imc grows to 32 KiB in four 2048x32 IHP macros (banked adapter in
    ram1p1rwbe.sv); the trace buffer becomes 2048 words so the design has a single macro type
    (two kinds make Magic report false M2.d errors)
    - boot.S reads a WALY-tagged image from an SPI flash and falls back to the UART; GPIO[7] strap
    forces the UART, GPIO[6:0] sets the baud divisor; three cocotb tests cover both paths and JTAG
    - gen_config.py places the macros from config.vh; 2.6 mm die; KLayout DRC with 6 threads
    - Chips run at 45 ns (slow-corner setup was -0.25 ns at 40 ns)
    - Result, SG13G2 at 45 ns: 70,323 cells, setup +2.88 ns,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
    [RM_IHPSG13_1P_2048x32_c2_bm_bist_bb.v, chip_tb.sv, chip_top.sv, ram1p1rwbe.sv, ram1p1rwbe_tb.sv, test_chip.py]
2026-11-05 ASIC chip: MCU peripherals (timer/PWM/capture, watchdog, I2C, RTC)
    ADR 0022 step 4. New APB region MCU_SUPPORTED/BASE/RANGE at 0x10080000
    (src/uncore/mcu/) and PLIC sources 15-18 on asic_soc_rv32imc. The pins go
    through the GPIO's IOF1 (new iof1oen input for open-drain and input
    functions); the watchdog resets the SoC internally, so wallypipelinedsoc
    gets no new port. Unit test testbench/mcu; chip test mcu_peripherals runs
    mcu.S through the pads (PWM duty, capture, I2C slave, RTC, watchdog reset).
    Chip at 45 ns, 2.6 mm: 76,374 cells, setup +5.08 ns, hold +0.056 ns, route
    DRC / KLayout DRC / LVS / antenna 0, check_drc.py DRC OK.
    [adrdecs.sv, chip_tb.sv, cvw.sv, gpio_apb.sv, i2c_apb.sv, mcu_apb.sv, mcu_tb.sv, plic_apb.sv]
2026-11-06 docs: inventory of the fork's coupling with upstream
2026-11-06 Norms and MCU unit test coverage
    SPDX headers on the three debug test files that lacked one. The MCU unit test now
    covers a prescaled watchdog, clearing its flag through STATUS and unmapped registers;
    make cover in testbench/mcu reports 147 of 148 line points of the four peripherals
    (the missed one is a default branch of the I2C state machine).
    [mcu_tb.sv]
2026-11-06 multicore: feature-interaction case for cache bursts with cache-to-cache; coverage table updated
    The combination was run by no CI profile (ahbmsicache lines 349-352).
    Merged line coverage of ahbmsicache goes from 79 % to 98 %.
2026-11-06 popcnt: note that WIDTH must be a power of two
2026-11-06 docs: ADR 0023, KiCad test board for the microcontroller
2026-11-06 board: kicadgen.py (KiCad 10 schematic writer, work in progress); ADR 0023 defers the Nano-format module
2026-11-06 chip: I2C on GPIO6-7, boot straps on GPIO0-5
    The I2C bus needs pull-ups, which held two of the eight strap pins the bootloader read at reset
    high. SCL and SDA move from GPIO4-5 to GPIO6-7 (alternate function 1), and boot.S reads its straps
    from GPIO0-5 only: the baud divisor from GPIO[4:0] (still 18 when they read 0), the UART-only boot
    from GPIO[5]. The timer channels stay on GPIO0-3. chipsim passes its four tests.
    [test_chip.py, uncore.sv]
2026-11-06 board: schematic of the test board, generated by mcu_board.py (ERC clean)
    Five sheets: USB-C power with 3.3 V and 1.2 V LDOs and ammeter jumpers for the chip's supplies;
    FT2232HL JTAG and UART; the chip (provisional QFN32 pin numbers), 18.432 MHz oscillator, MAX811
    reset supervisor, W25Q32 flash; boot-strap DIP switches on GPIO0-5, buttons, buffered LEDs, I2C
    EEPROM, TMP102, ADS1115 and MCP4725 on GPIO6-7; three Pmod headers for an FPGA in place of the chip.
    KiCad files keep their tabs (forbid-tabs skips them).
    [chip.kicad_sch, debug.kicad_sch, fpga.kicad_sch, mcu_board.kicad_sch, peripherals.kicad_sch, power.kicad_sch]
2026-11-06 docs: ADR 0023 records the board's choices (Pmod headers for the FPGA, oscillator, buttons, I2C parts)
2026-11-06 board: PCB placement (mcu_pcb.py), chip pinout from the pad ring, chip image
    mcu_pcb.py places the 149 footprints of the schematic on a 110 x 85 mm four-layer board (In1 GND,
    In2 +3V3), USB-C on the left edge and the Pmod headers on the top edge, and writes the design rules
    into the project; DRC finds no electrical error and the board matches the schematic. Not routed;
    the planes are filled by KiCad (DRC --refill-zones, plotting). KiCad boards are exempt from the
    large-file check.
    The chip's QFN32 pin numbers now follow the pads' places in the final DEF (each pad to the nearest
    pin); chip_qfn32_socket.png draws it. The Pmod symbols use odd/even numbering, as the headers do.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
    [chip.kicad_sch, fpga.kicad_sch, mcu_board.kicad_pcb, peripherals.kicad_sch, power.kicad_sch]
2026-11-06 board: place the parts by function
    Connectors on the edges (USB-C and UART left, Pmod top, analog right), the chip in the middle with
    its JTAG header, oscillator, flash and decoupling beside it, the FT2232HL with its crystal and
    EEPROM, a row along the bottom edge with a test point, LED and button per GPIO, RESET apart, the
    strap DIP switch with its resistors. DRC: no electrical error, the board matches the schematic.
    [mcu_board.kicad_pcb]
2026-11-06 board: routed with Freerouting (route.py); chip-only VDD_IO
    route.py gives every SMD pad of GND and +3V3 a locked via to its plane (In1, In2), then routes F.Cu
    and B.Cu with Freerouting 2.5.0 through Specctra DSN: DRC reports no unconnected item and no
    electrical violation, and the board matches the schematic (silkscreen warnings remain).
    VDD_IO now feeds only the chip's pads, their decoupling, the reset supervisor and the JTAG
    reference, so the ammeter in JP1 measures the chip alone: the flash, oscillator and every pull-up
    moved to +3V3. JP1, JP2 and their test points sit beside the chip. Power tracks are 0.3 mm, the
    chip's and the FT2232HL's own supplies 0.2 mm (they fit between QFN pins);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
    [chip.kicad_sch, mcu_board.kicad_pcb, peripherals.kicad_sch]
2026-11-06 board: coupled USB pair, silkscreen, manufacturing files (fab.py)
    route.py routes the USB pair before the autorouter: straight and coupled, both lines 9.28 mm, the
    connector's second D+/D- pads and the ESD diode joined with short stubs, D- crossing under on B.Cu.
    It also joins the connector's second VBUS pair and removes the router's leftovers; a run that leaves
    a connection is simply repeated. DRC: no unconnected item, no electrical violation, board matches
    schematic. mcu_pcb.py places the silkscreen (small parts' references hidden, test points named by
    net, labels for connectors, jumpers, straps, title) clear of pads and of each other, and puts J1 level
    with the FT2232HL's USB pins. fab.py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
    [chip.kicad_sch, debug.kicad_sch, fpga.kicad_sch, mcu_board.kicad_pcb, peripherals.kicad_sch, power.kicad_sch]
2026-11-06 asic configurations: flop register file (LATCH_BASED_REGISTERFILE 0)
    rv32imc turned on upstream's latch-based register file (6c75547b3), which asic_rv32imc and
    asic_soc_rv32imc inherited in the last upstream merge. OpenROAD's clock tree synthesis then takes
    the 32 row clock gates as macro sinks and loses one (36 sinks in, 35 out, whatever the sink and
    macro clustering, post-processing or level balancing), and the disconnected-pins check stops the
    flow. The asic configurations go back to the flop register file every earlier chip run used.
    chipsim passes its four tests.
2026-11-06 docs: ADR 0023 notes the future development module (Nucleo-32 or ESP32 style, CH347)
2026-11-06 board: LCSC part numbers in the JLCPCB bill of materials
    Basic parts for the passives and FB1, extended parts for the rest, all
    checked against JLCPCB's catalogue; the through-hole headers stay empty
    to be soldered by hand. Y1 is a 12 pF load crystal for the 18 pF C7/C8.
2026-11-06 board: route.py uses itertools.pairwise (ruff RUF007 on Python 3.13)
2026-11-06 board: simulate the chip on the board's netlist (make boardsim)
    hardware/board/sim generates a SystemVerilog model from the KiCad
    schematic's netlist and runs seven cocotb tests against it: power-up
    reset and boot from the board's flash, the reset button, the UART baud
    rate from the straps and the oscillator, UART boot, JTAG and the reset
    line through the FT2232, the four I2C devices, and straps, buttons and
    LEDs. The tests detect four deliberate netlist errors. The BOM README
    now says that the LCSC numbers are filled in.
    [gen_board.py, models.sv, test_board.py]
2026-11-06 chip: RV32IMAC, the A extension on asic_soc_rv32imc
    ZAAMO_SUPPORTED and ZALRSC_SUPPORTED on the chip: Yosys measures +1,168
    cells (+2.0 %, +1.0 % of the area). chipsim gets an atomics test
    (atomics.S: the AMOs, LR/SC and misa.A) that passes with boardsim.
2026-11-06 chip: PMP with 16 entries on asic_soc_rv32imc, with a chipsim test
    PMP_ENTRIES 16 (+7,851 cells, +8.2 % of the area over RV32IMAC in Yosys) for an RTOS's memory
    protection. chip/test/pmp.S checks the PMP CSRs, User mode against regions with R+X, R+W, R and no
    entry, and a locked entry in Machine mode; chipsim 6/6 and boardsim 7/7.
2026-11-06 chip: rename asic_soc_rv32imc to asic_soc_rv32imac
    The chip has the A extension (and PMP), so its name says what it is. The experiment note of
    2026-11-02 keeps the old name, which the chip had then. chipsim 6/6, boardsim 7/7.
    [chip.kicad_sch, fpga.kicad_sch, mcu_board.kicad_pcb, mcu_board.kicad_sch]
2026-11-07 chip: 50 ns clock for the chips (16 PMP entries miss 45 ns by 0.12 ns)
    The post-route slow corner has a path from IEUAdrM through the PMP comparators at -0.12 ns at 45 ns.
    50 ns is 20 MHz; the board's oscillator is 18.432 MHz.
2026-11-07 chip: FreeRTOS demo (kernel V11.3.3 as a submodule) and a chipsim test
    addins/FreeRTOS-Kernel with the RISC-V port (CLINT tick, no FPU); chip/freertos has the config, startup,
    linker script and a demo with tasks, a queue, a mutex and a software timer, 11 KiB in the 32 KiB RAM.
    chipsim's freertos test boots it from the flash and checks the output (7/7). On a hang the test halts the
    hart over JTAG and prints dpc, mcause, mepc, mtval, mstatus, mie, mip and mtvec.
2026-11-07 chip: 64 KiB RAM exploration (eight 2048x32 banks, two rows of macros, 2.92 mm die)
    UNCORE_RAM_RANGE 64'hFFFF; gen_config.py puts the RAM's first four banks along the top of the core and the
    rest plus the trace buffer along the bottom (the die is 2.92 mm with a 64 KiB RAM); boot.S loads up to
    64 KiB; chipsim's ram test writes every bank and checks byte and halfword stores. chipsim 8/8, boardsim 7/7.
    Flow result pending.
2026-11-07 docs: ADR 0022, the die limit is the QFN 32's 3 x 3 mm
2026-11-07 README: say what the fork is (open FPGA and ASIC flows, test board, FreeRTOS)
    An 'About this fork' section before the configurations: it is a fork of openhwgroup/cvw that adds the
    open FPGA flow, the open ASIC flow and its chip, the KiCad test board, FreeRTOS on the chip, the debug
    port and trace, and multicore and PMU work, with links to where each is documented. Upstream's setup
    guide below is unchanged.
2026-11-07 ram-64k: five macros on top, four bottom right, so the clock pad has room
    The bottom row of macros over the whole south edge left the clock tree's buffer next to clk_pad no
    place (DPL-0036); a 300 um strip of cells under the row piled 64 cells in one column instead. Now the
    top row has the four banks and the trace buffer and the bottom row's four banks sit against the right
    edge, leaving the window under the clock pad free.
2026-11-07 ram-64k-a: the trace buffer shares the RAM (TRACE_IN_RAM): eight macros, 2.752 mm die
    The trace sink writes the last TRACE_RAM_WORDS words of the uncore RAM through a port of ram_ahb that a hart's access
    to that area takes over. The RAM is split in power-of-two parts (ram1p1rwbe banks them), the last being the trace
    RAM, so the chip has eight 2048x32 macros instead of nine and a smaller die (the antenna rule Ant.e at the input
    pads grows with the die). Test: trace_inram_rv32gc runs testbench/debug/etrace.
2026-11-08 ram-64k-a: gen_config for the eight-macro chip (TOP_SHIFT 0, target density 70 %), docs
    gen_config.py: the die is 2.752 mm with TRACE_IN_RAM, the top macro row has no shift (Metal1 rails with no strap at
    1.89 um), global placement targets 70 % density (OpenROAD's antenna repair found no room at 0.85). docs/trace.md
    describes TRACE_IN_RAM and its software rule, the etrace test also runs trace_inram_rv32gc, ADR 0022 records the
    64 KiB RAM and the Ant.e measurements, the README follows.
2026-11-08 ram-64k: results of the 8-macro chip (2.752 mm die, 50 ns, DRC/LVS/antenna clean)
2026-11-08 Zephyr on asic_soc_rv32imac: User-mode threads isolated by the PMP (memory domains)
    addins/zephyr (v4.5.0, shallow), an out-of-tree board and SoC (wally_chip), a
    demo with two threads in two domains and nine access cases, and a chipsim test
    that checks the PMP faults in the RTL (store/load outside the domain, kernel
    data and code, UART, trace area, jump into data, syscall without permission).
2026-11-08 bootloader: default UART divisor 10 (115200 baud at the board's 18.432 MHz)
    The default, used when GPIO[4:0] read 0, was 18, from a 33.3 MHz clock: 64000
    baud with the test board's oscillator. boardsim checks the default, the strapped
    10 and the old 18; chipsim straps its own divisor and is unaffected.
    [test_board.py]
2026-11-08 board: silkscreen of SW2 says 1-5 OFF for 115200 baud
    The bootloader's default divisor is now 10 (115200 baud at 18.432 MHz), so all
    of switches 1-5 open give 115200; the label said 2 and 4 ON. Text edited in
    mcu_pcb.py and in mcu_board.kicad_pcb (a regeneration would discard the routing).
    DRC unchanged: 0 unconnected, 0 parity, the 18 known Pmod silkscreen warnings.
    [mcu_board.kicad_pcb]
2026-11-08 Zephyr drivers for the chip's peripherals: UART IRQ, GPIO, SPI, PWM
    Board and SoC: the FE310-compatible GPIO, SPI and PWM use Zephyr's SiFive drivers
    (SoC header with the peripheral clock, pinctrl_soc.h, pinctrl as a child of the
    GPIO, IOF0 states for the PWM outputs). Two demos and two chipsim tests: periph
    (polled UART, GPIO, SPI read of the flash, PWM duty cycles on the pads) and
    uart_irq (receiver on the PLIC's second level, with bus-access diagnostics).
2026-11-08 Zephyr drivers: I2C master and watchdog of the chip, module loading, docs
    Own drivers (module/drivers) for the I2C master (polled) and the two-stage
    watchdog (reset action only), with bindings and Kconfig; the module is loaded
    through ZEPHYR_MODULES, the only way CMake reads modules without west. The mcu
    demo and the zephyr_mcu chipsim test (I2C device on the pads, NACK, the reset
    the watchdog causes). README: what is not obvious (GPIO interrupts, PWM
    polarity, the UART callback loop, pinctrl).
    [i2c_wally.c, main.c, test_chip.py]
2026-11-08 board: footprint of the chip's QFN32 test socket (Yamaichi IC550-0324-007-G)
    From Yamaichi's drawing A111332-001: 32 through-hole contacts in staggered rows,
    the centre ground pin (pad 33, masked), two locating holes, five stand-off keep-out
    areas and the 24.5 x 22 mm body. Pin 1 at the bottom left of the nest, so pins 1-8 run
    along the bottom side. socket_fp.py generates mcu_board.pretty/..., socket_preview.py
    draws socket_footprint.png. Not used by the board yet: it covers the chip's decoupling,
    clock and flash, so the board has to be placed and routed again.
2026-11-08 board: variant with the chip's test socket (rev A-S), next to the one with direct soldering
    mcu_pcb.py --socket places the same schematic with the Yamaichi socket footprint for U6
    (turned 270 degrees, so each side of the package faces as in rev A): decoupling above the
    body, oscillator, clock/reset and LED buffer on the bottom side. route.py fans out the
    bottom-side parts on the bottom copper; fab.py --socket writes fab-socket/. The socket
    pads keep inner rings only where their net is, and the planes keep 0.2 mm from them, so
    the ground pins reach the plane. DRC: 0 unconnected, only the 18 Pmod silkscreen warnings
    of rev A. U11 pad 5 (+3V3) is joined by hand (a via and a 0.15 mm track). Rev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
    [mcu_board_socket.kicad_pcb]
2026-11-08 board: avoid the isinstance tuple form that ruff flags (UP038) for Python 3.13
    [mcu_pcb.py]
2026-11-08 asic: README numbers of the 64 KiB chip, from the flow with UART divisor 10
2026-11-08 docs: chip software (Zephyr, FreeRTOS), 64 KiB RAM, boot divisor and test board variants
2026-11-08 board: renders of rev A with the current silkscreen
2026-11-08 debug: PMP does not apply to the Debug Module's memory in Debug Mode
    A locked PMP catch-all without X (Zephyr and FreeRTOS use one, cfg 0x9b)
    also binds M-mode, so the fetch of the Debug ROM at 0x800 after a halt
    request faulted, the hart never reached the halt loop and the DM never saw
    allhalted. In Debug Mode the accesses below 0x1000 now bypass the PMP; the
    rest are still checked.
    Tests: debug_tb locks RTOS-like PMP entries and halts (times out without
    the fix; debug_rv32imc and debug_rv64gc), and the chip's zephyr_halt_idle
    halts Zephyr's idle thread three times and checks the UART echo afterwards.
    [mmu.sv, test_chip.py]
2026-11-09 docs: chip flow numbers after the Debug Mode PMP exemption
    Full flow rerun (RUN_2026-11-08_20-48-15): 90,429 standard cells, setup
    +3.41 ns (slow corner), hold +0.04 ns (fast corner), 19 mW; KLayout DRC,
    LVS and antenna clean, Magic only the waived findings.
2026-11-09 zephyr: drivers for the MCU timer (Counter with capture, PWM) and the RTC
    wally,timer implements the Counter API (top value with a callback, one
    alarm per channel, edge capture on GPIO0-3) and, as a child node
    wally,timer-pwm, the PWM API on the same four channels. wally,rtc
    implements the RTC API on the counter of seconds, with one full-date
    alarm that wakes a wfi. A new image (timer) and chipsim test
    (zephyr_timer) check them on the RTL: top callbacks, relative, absolute,
    cancelled and late alarms, captured edges driven into GPIO2, duty cycles
    measured on GPIO0 and GPIO1, the RTC's time and an alarm. make chipsim:
    14 of 14.
2026-11-09 zephyr: GPIO interrupts and interrupt-driven I2C
    The chip has one PLIC line (source 3) for the eight GPIOs, where Zephyr's
    sifive,gpio0 driver expects one per pin. wally,gpio has the same
    registers and one handler that finds the pending pins, so edge and level
    interrupts work on every pin. wally,i2c now sleeps on the controller's
    interrupt (PLIC source 17) while a command runs, and polls only without
    the devicetree property; a mutex serialises threads. The periph demo and
    test check three edge interrupts and a level interrupt on GPIO4; the mcu
    test exercises the I2C interrupt.
2026-11-09 zephyr: instruction trace switched on by the kernel, decoded against the ELF
    The trace app has the hart configure the E-Trace encoder and the RAM sink
    through the Trace Control Interface registers, trace a workload (three
    round trips between two threads and a timer interrupt) and switch it off.
    chipsim's zephyr_trace reads the sink's buffer over JTAG System Bus
    Access with the hart running and decodes it against Zephyr's ELF: the
    path goes through the workload, the semaphore calls, the context switch
    and the timer interrupt handler. read_trace_ram is shared with
    debug_over_jtag.
2026-11-09 zephyr: README: do not claim what the trace image does not test
2026-11-09 docs: XIP from the SPI flash left as a next-revision improvement
2026-11-09 fpga: the chip asic_soc_rv32imac on the Nexys Video, open-source flow
    fpgaChip.sv is chip_top.sv without the pad ring: a PLL makes 18.4375 MHz from the
    100 MHz oscillator (0.03 % above the test board's 18.432 MHz), so the chip's
    bootloader and Zephyr/FreeRTOS images run unchanged; GPIO on the switches and
    LEDs, the board's USB-UART as the console. make nexysvideochip builds it in
    about 5 minutes (7 % of the LUTs, 16 RAMB36). uart_load.py loads an image
    through the bootloader and shows the console.
    Bitstream built, not yet run on the board: the pins of SW4-7 and LD5-7 are
    unchecked against the reference manual.
    [fpgaChip.sv, fpgaChipClk.v, opensource-NexysVideoChip.xdc, uart_load.py]
2026-11-09 docs: refresh the state of the repository after the chip and firmware work
    README and the engineering index describe the chip, its firmware and the debug and
    trace documents; current-work.md has a checkpoint of 2026-11-09 instead of the
    October one; the Zephyr README no longer says the I2C driver polls; the chipsim
    test file lists all its tests.
    [test_chip.py]
2026-11-09 docs: implementation.md describes the repository as of 2026-11-09
    The flows (simulation, Vivado and open FPGA, Design Compiler, the open ASIC flow,
    the chip's RTL tests, the test board, the chip on the FPGA), how far each has been
    verified, the chip's numbers from the last full run and what is not established.
2026-11-09 fpga: Zephyr's isolation demo runs on the Nexys Video
    The console of the board is its FT232R, not the Digilent device that programs
    the FPGA. The bootloader's baud rate follows the switches (f_clk / (16 * divisor)),
    so uart_load.py takes --boot-baud, with any rate through termios2. The demo's
    fatal error handler read mcause after a timer tick had replaced it, which only a
    slow console shows; the oops of a refused system call is an ecall.
    [main.c, uart_load.py]
2026-11-10 fpga: the 8 switches and 8 LEDs of the chip on the Nexys Video checked on the board
    gpio_demo (Zephyr image): LD0..LD7 in turn, then the eight switches printed every
    half second. Run on the Nexys Video on 2026-11-10 with all of SW[4:0] down; every
    switch and every LED is on the pin of its GPIO, including SW4-7 and LD5-7. The app
    image also ran again to ZEPHYR OK at 115200 baud. Docs no longer say the chip's FPGA
    build is only on a branch.
    [main.c, opensource-NexysVideoChip.xdc]
2026-11-10 fpga: uart_irq and timer run on the Nexys Video; FPGA_TIMING for the timer demo, --send for uart_load.py
    zephyr/timer: with make APP=timer FPGA_TIMING=1 the demo uses the timings of a person at
    the board (40 s capture window, RTC at real seconds, 0.5 s PWM period). Without it the
    image is byte for byte the one of chipsim (same SHA-256).
    uart_load.py: --send TEXT --send-after MARKER sends characters to a program that waits
    for UART input (uart_irq); the bootloader's 'W' is accepted only when followed by
    silence, so the 'W' of a program's output ("SW7..0") is not taken for it.
    Board results of 2026-11-10 in docs/fpga-chip.md.
2026-11-10 docs: the mcu image (I2C master and watchdog) on the Nexys Video
    With no I2C device on the board SW6 and SW7 stand for SCL and SDA: both up gives a NACK
    (MCU FAIL i2c write -5), SDA held low acknowledges every address and the demo reaches the
    watchdog, which resets the SoC (the bootloader's 'W' comes back). Data and the ACK/NACK
    difference between addresses need a real device and are not checked.
2026-11-10 fpga: the instruction trace of the chip runs on the Nexys Video (FPGA_DUMP, trace_decode.py)
    The FPGA has no JTAG, so with make APP=trace FPGA_DUMP=1 the demo reads the sink's buffer
    itself through trRamData and prints it on the UART; trace_decode.py decodes the log
    against the ELF with etracedecode.py and checks what chipsim's zephyr_trace checks.
    On the board: 988 bytes, 5,952 instructions, 8 context switches, the timer interrupt.
    Without FPGA_DUMP the image is byte for byte the one of chipsim.
2026-11-10 fpga: the periph image runs on the Nexys Video (FPGA_TIMING for the edge interrupts)
    periph/main.c: with make APP=periph FPGA_TIMING=1 the two waits of the GPIO interrupt checks
    are 30 s instead of 100 ms, so that a person makes the edges on SW4. Without the option the
    On the board: PERIPH OK. UART echo, GPIO input to output, edge and level interrupts through
    the PLIC; the SPI transfer completes (no flash on the board: zeros); the PWM's duty cycles
    could not be told apart by eye. Notes on the bootloader's baud rate with SW4 up.
    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
2026-11-10 docs: FreeRTOS runs on the Nexys Video
    The demo ran to FREERTOS OK on the board (2026-11-10, switches all down): queue, mutex,
    software timer, preemption and the static PMP causes of the simulation. Also a note on a
    leftover switch (SW4 up after periph) that makes the next load fail silently.
2026-11-11 docs: ADR 0024, an edge-AI unit for the microcontroller (proposed)
    What exists (CFU Playground, X-HEEP and its near-memory units, CV-X-IF, TinyGPU-ML and
    student projects), five options, and the proposal: a memory-mapped int8 unit as block 4 of
    mcu_apb, prototyped on the Nexys Video and measured against software before any silicon
    decision. Constraints: 64 KiB RAM, no XIP, core untouched, die that cannot grow.
2026-11-11 docs: ADR 0024 records the open question, bring pieces here or move to the Coral NPU repository
    With the facts known (Google's ASAP7 flow for the vector variant: about 1.43 million cells, 441.5 um
    die; our chip: 90,429 cells in 130 nm; the scalar CoreMini on the Artix-7) and the data still to
    collect before deciding.
2026-11-11 docs: ADR 0024 sets B as the direction, with the bus master's place, and the licenses
    B (the unit of A plus a bus master of its own) is the target. The master goes in uncore.sv as a
    two-master arbiter before the address decode, not in ebu.sv. A table of licenses of the candidates
    (only Apache, Solderpad, BSD and MIT code may be reused; four projects have none) and what is
    reused: nothing for the MAC datapath, Wally's own AHB interface for the master.
2026-11-11 trace: register the line of the instruction trace interface (chip's longest FPGA path)
    RetireW depends on StallW, which comes from the memory system, and the encoder
    follows, so the chip's longest path on an FPGA ran from the load/store address
    (PMP checks) to the trace sink's queue. etraceingress now registers ITrace:
    the trace is one cycle later, nothing else changes. nextpnr-xilinx Fmax of
    asic_soc_rv32imac 20.86 -> 28.90 MHz (one seed); Vivado slowest full-cycle
    path 35.3 -> 33.1 ns. Also nexysvideochip-vivado (chip-vivado.tcl) to compare
    the two flows. etrace check/check-harts, chipsim zephyr_trace and lint pass.
